TravisNagle/ECEN5613_Final_Project/docs/F26_PDR_TravisNagle_NathanCohen.pptx

ECEN 5613 · Final Project · Preliminary Design Review

MIDI Foot Controller for Reaper

An 8051-based MIDI foot controller with a motorized fader that stays in sync with the DAW

Inputs

- 4 footswitches
- Expression pedal (TRS)
- Motorized fader position
- MIDI IN (opto-isolated)

Outputs

- MIDI OUT → USB-MIDI → Reaper
- Fader motor (closed-loop)
- LCD status + presets
- Debug serial port

Team & ownership

Travis Nagle - MIDI & Interface lead
M2 debug + switches, M4 MIDI IN/merge, M5 LCD/presets
Nathan Cohen - Analog & Control lead
M3 pedal/ADC, M6 motorized fader
Joint: M1 MIDI OUT

Builds on the Lab 1-3 board: AT89C51RC2 @ 11.0592 MHz, MAX232, bq4011 NVRAM

Notes: ~40 s. Both: introduce yourselves. SW lead: what the device does, inputs/outputs. AE lead: ownership split.

## New hardware around the existing 8051 board

New hardware

Footswitches → 74HC165
M2 · PISO, shares SCLK and /CS with ADC

Existing

AT89C51RC2
existing Lab 1-3 board
UART 31,250 baud (Timer 2)
Soft UART TX 9,600 (Timer 0)
1 ms system tick (Timer 1)
PCA PWM 10.8 kHz (fader)
NVRAM presets 0x7F00–0x7FFF

MIDI OUT → 74HC125
M1 · TXD → USB-MIDI → Reaper

Pedal + fader → MCP3008
M3 · 10-bit SPI ADC, CH0 pedal, CH1 fader

SN754410 H-bridge → fader motor
M6 · PWM + 2 dir, 12 V USB-PD supply

MIDI IN → 6N138 opto
M4 · RXD via RUN / PC jumper

11 free port pins → 9 allocated, 2 reserved for Lab 4

Debug: MAX232 ch2 → DB9 #2
M2 · soft UART TX only (DB9 new)

Single-UART constraint: TXD fans out to MAX232 + MIDI OUT; RXD selected by jumper (MIDI / PC for FLIP); debug moved to a soft UART.

LCD (Lab 4)
M5 · status, preset menu

Notes: ~60 s. Walk inputs left, outputs right. Point out: '165 + MCP3008 share SCLK and /CS (saves 2 pins); MIDI IN is galvanically isolated per MIDI 1.0; motor on a separate 12 V rail with single-point ground at the driver.

## New firmware: interrupts feed a cooperative main loop

INTERRUPTS & HARDWARE TIMERS

UART RX
byte → 32-byte ring buffer; no parsing in ISR

Timer 0 (high)
soft UART TX, 9600 baud debug

Timer 1
1 ms tick sets loop flags

PCA (hardware)
8-bit PWM to H-bridge, no CPU cost

Primary firmware complexity: MIDI IN parse + merge/filter at up to 3,125 B/s alongside the 1 kHz fader loop. Debug output adds ~39%.

MAIN-LOOP MODULES

MIDI parser
status/data state machine, running status, real-time bytes

Merge + filter
interleave local msgs at boundaries; table filter; loop prevention

Switch scan
'165 read, 20 ms debounce → CC / MCU transport notes

Pedal
8-sample average, calibration, hysteresis → CC 0–127

Fader control
1 kHz PD loop, deadband brake, 1 s stall timeout

MCU link
14-bit pitch bend both ways with Reaper

Presets + LCD
NVRAM records with checksum; long-press edit menu

Drivers
Timer 2 UART, hardware SPI, bit-banged ‘165, soft UART, debug log

Notes: ~60 s. ISRs only move bytes and set flags; the main loop does the work.
Worst case: full-speed MIDI both ways plus the 1 kHz fader loop.
MIDI takes just under half (25% interrupts + 21% parsing), fader 24%, everything else 16%, 14% spare.
Debug output adds ~39%, so it's off in the worst case.
Need more headroom? X2 mode doubles the CPU and moves PWM to 21.6 kHz; recheck LCD timing first.

## Milestones: each one independently demonstrable

| Milestone | Owner | Dates | Acceptance test | Status
M1 | MIDI OUT: Timer 2 UART, 74HC125 driver | Both | Wk 1-2 (10/19–11/1) | Note On/Off in MIDI-OX; Reaper synth plays | 74HC125, DIN jacks and USB-MIDI interface to order
M2 | Debug port + footswitches ('165) | TN | Wk 2-3 (to 11/8) | FS1 toggles Reaper record; debug logs event | 74HC165, footswitches, and DB9 to order
M3 | Expression pedal via MCP3008 | NC | Wk 3 (11/2–11/8) | Full travel → CC 0–127; no messages at rest | MCP3008 and TRS jack to order
M4 | MIDI IN, merge, filter (6N138) | TN | Wk 3-5 (to 11/22) | Pass-through with footswitch traffic, zero drops | 6N138 and 1N4148 to order
M5 | LCD, presets, menu (NVRAM) | TN | Wk 6 (11/23–11/29) | Edit preset by footswitch; survives power cycle | Waiting on Lab 4 LCD
M6 | Motorized fader, PD loop, MCU link | NC | Wk 2-6 (to 11/29) | Fader tracks Reaper in 1 s, ±1 mm, no oscillation | Fader and USB-PD module on hand; SN754410 to order
M7 | Stretch: tempo sync or 2nd fader | Both | Wk 6 if ahead | — | Optional

Key dates: order all parts Tue 10/20 · TA progress check week 3 · feature freeze Mon 11/30 · demo Fri 12/4

Notes: ~50 s. Two tracks run in parallel weeks 4–5 (SW: M4, AE: M6).

## Deliverables, fallback plan, and open risks

Footswitch control of Reaper over MIDI

Minimum
M1–M2

OPEN RISKS → MITIGATION

Parts lead time
Order all parts 10/20; in-stock substitutes (e.g. TRS jack)

+ pedal, MIDI IN merge/filter, LCD presets, motorized fader

1

Target
M1–M6

2

One MIDI IN: keyboard (M4) vs Reaper feedback (M6)
Demo M4 and M6 with separate cabling; filter notes and pitch bend in MCU mode

+ MIDI clock tempo sync, or a second motorized fader

Stretch
M7

3

Fader fights Reaper feedback
Send synthetic MCU touch on user movement and ignore Reaper's fader position while touched

12 V not offered by every USB-PD charger
Verify in-hand charger; 9 V setting is marginal

FALLBACK

- DIN/USB-MIDI fails: MIDI bytes out DB9 #1 at 115,200 baud → Hairless MIDI → loopMIDI → Reaper
- Motor control fails: fader still works as an unpowered slider through the ADC

4

5

10.8 kHz PWM may be audible
X2 mode, after rechecking bus timing → 21.6 kHz PWM and 2× CPU

6

M5 depends on Lab 4 LCD
M5 is firmware-only; slip does not block M6

Notes: ~50 s. Close with: minimum demo is reachable by week 3; every target milestone is independently demonstrable. Then questions.
