TravisNagle/ECEN5613_Final_Project/hardware/digikey_order_102466363.csv

# | QUANTITY | PART NUMBER | MANUFACTURER PART NUMBER | DESCRIPTION | UNIT OF MEASURE | CUSTOMER REFERENCE | AVAILABILITY | UNIT PRICE
1 | 2 | MCP3008-I/P-ND | MCP3008-I/P | IC ADC 10BIT 16-PDIP |  | U11 fader ADC (+1 spare) | Immediate | 3.12000
2 | 2 | 296-1610-5-ND | SN74HCT244N | IC BUFF 4.5V/5.5V 20-PDIP |  | U16 panel button buffer (+1 spare) | Immediate | 1.52000
3 | 2 | 296-2110-5-ND | CD74HCT273E | IC FF D-TYPE 1-ELE 8-BIT 20-PDIP |  | U14 direction latch with /MR (+1 spare); kit 74L | Immediate | 1.16000
4 | 2 | 25TWL10MEFC5X11-ND | 25TWL10MEFC5X11 | CAP ALUM 10UF 20% 25V RADIAL TH |  | 10 uF 25 V (ADC reference filter; kit 10 uF are | Immediate | 0.27000
5 | 2 | P14419-ND | EEU-FR1E471 | CAP ALUM 470UF 20% 25V RADIAL TH |  | 470 uF 25 V motor rail bulk | Immediate | 1.00000
6 | 1 | RHEF300HF-ND | RHEF300 | PTC RESET FUSE 16V 3A RADIAL |  | PTC fuse for motor rail (3 A hold; three motors | Immediate | 0.81000
7 | 1 | 4878-P6KE15ACT-ND | P6KE15A | TVS DIODE 12.8VWM 21.2V DO204AC |  | TVS for motor rail | Immediate | 0.53000
8 | 3 | AT42QT1010-TSHRCT-ND | AT42QT1010-TSHR | IC TOUCH SENSOR 1KEY SOT23-6 |  | A4/A5 fader touch sensor IC SOT-23-6 (+1 spare) | Immediate | 0.77000
9 | 2 | 23-0702461201-ND | 0702461201 | CONN HEADER VERT 12POS 2.54MM |  | J20 12-pin shrouded keyed header (panel end + bo | Immediate | 2.69000
10 | 2 | WM9219-ND | 0702461001 | CONN HEADER VERT 10POS 2.54MM |  | J21 10-pin shrouded keyed header (panel end + bo | Immediate | 1.92000
11 | 2 | 2057-FCS-12-SG-ND | FCS-12-SG | SOCKET FLAT CABLE IDC 12P 2.54MM |  | J20 12-pin polarized IDC ribbon socket gold (one | Immediate | 0.41000
12 | 2 | ED10500-ND | 101-106 | CONN SOCKET 10POS IDC GOLD |  | J21 10-pin polarized IDC ribbon socket gold (one | Immediate | 0.31000
13 | 2 | 19-3365/12100-DS-ND | 3365/12 100 | CBL RIBN 12COND 0.05 GRY FEET | Feet | 12-conductor 0.050 in ribbon; quantity is feet; | Immediate | 0.96000 (Per Foot)
