TravisNagle/ECEN5613_Final_Project/hardware/kicad/ESD_Final/ESD_Final_schematic.pdf

1 | 2 | 3 | 4 | 5 | 6 | 7 | 8

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
Size: A3 | Rev: 13.4 | F Date: 2026-10-25
KiCad E.D.A. 10.0.6 | Id: 1/8

# Title: Reaper MIDI control surface: boards and cables

### File: ESD_Final.kicad_sch

### Sheet: /

### ECEN 5613 Final Project

### Spec: Hardware_Map.md Rev 13.4

### Generated from hardware/kicad/tools/design.py by gen_schematic.py

### Authors: Nathan Cohen, Travis Nagle (AI-assisted, see report)

Class board: 8051, address latch, decode, reset, status LED

File: class_mcu.kicad_sch Class board: Serial, USB-MIDI, I2C and panel cables File: class_io.kicad_sch

Fader button board: Fader buttons F1/F2 and touch sensors File: fader_strip.kicad_sch Button daughter board: PCF8574 buttons and LEDs on the RJ45 I2C bus (Phase 3) File: btn_daughter.kicad_sch

Class board: Power, motor supply, motor driver and direction latch

File: class_power.kicad_sch

D-pad board: Button buffer, fader ADC, D-pad, LCD contrast File: dpad.kicad_sch Panel Mounted: Motor faders, LCD and pedal jack (wired to the boards) File: panel.kicad_sch

### Inter-board connections:

J20 (class) <-> J30 (D-pad) | 12-pin ribbon, about 9 in: AD0-AD7, LCD_RS, LCD_RW, LCD_E, GND
J21 (class) <-> J31 (D-pad) | 10-pin ribbon, about 8 in: +5V, GND x2, BTN_OE_N, TOUCH2, ADC SPI, 1 spare
J22 (class) --> FDR1, FDR2 motors | 4 wires (two twisted pairs)
J32 (D-pad) <-> J40 (fader strip) | 6 wires: +5V, GND, BTN_F1, BTN_F2, TOUCH1, TOUCH2
J33 (D-pad) --> LCD1 | 14 wires; | J34 (D-pad) --> FDR1/FDR2 pots | 4 wires; | J35 (D-pad) --> J13 pedal jack | 3 wires
J41 (fader strip) --> FDR1/FDR2 touch pins T | 2 wires
J11 (class) RJ45 --> J101 (button daughter) patch cable; | J102 --> next daughter board
Power: J1 (class) <-- 9 V >= 2 A adapter. | USB-C to the KB2040 (A2). | DB9 J5 / J7 TTL debug to the PC.

# ECEN 5613 Final Project: 8051 MIDI control surface for Reaper (Hardware_Map.md Rev 13.4)

Authors: Nathan Cohen and Travis Nagle. One sheet per board section; nets join across sheets by global label.

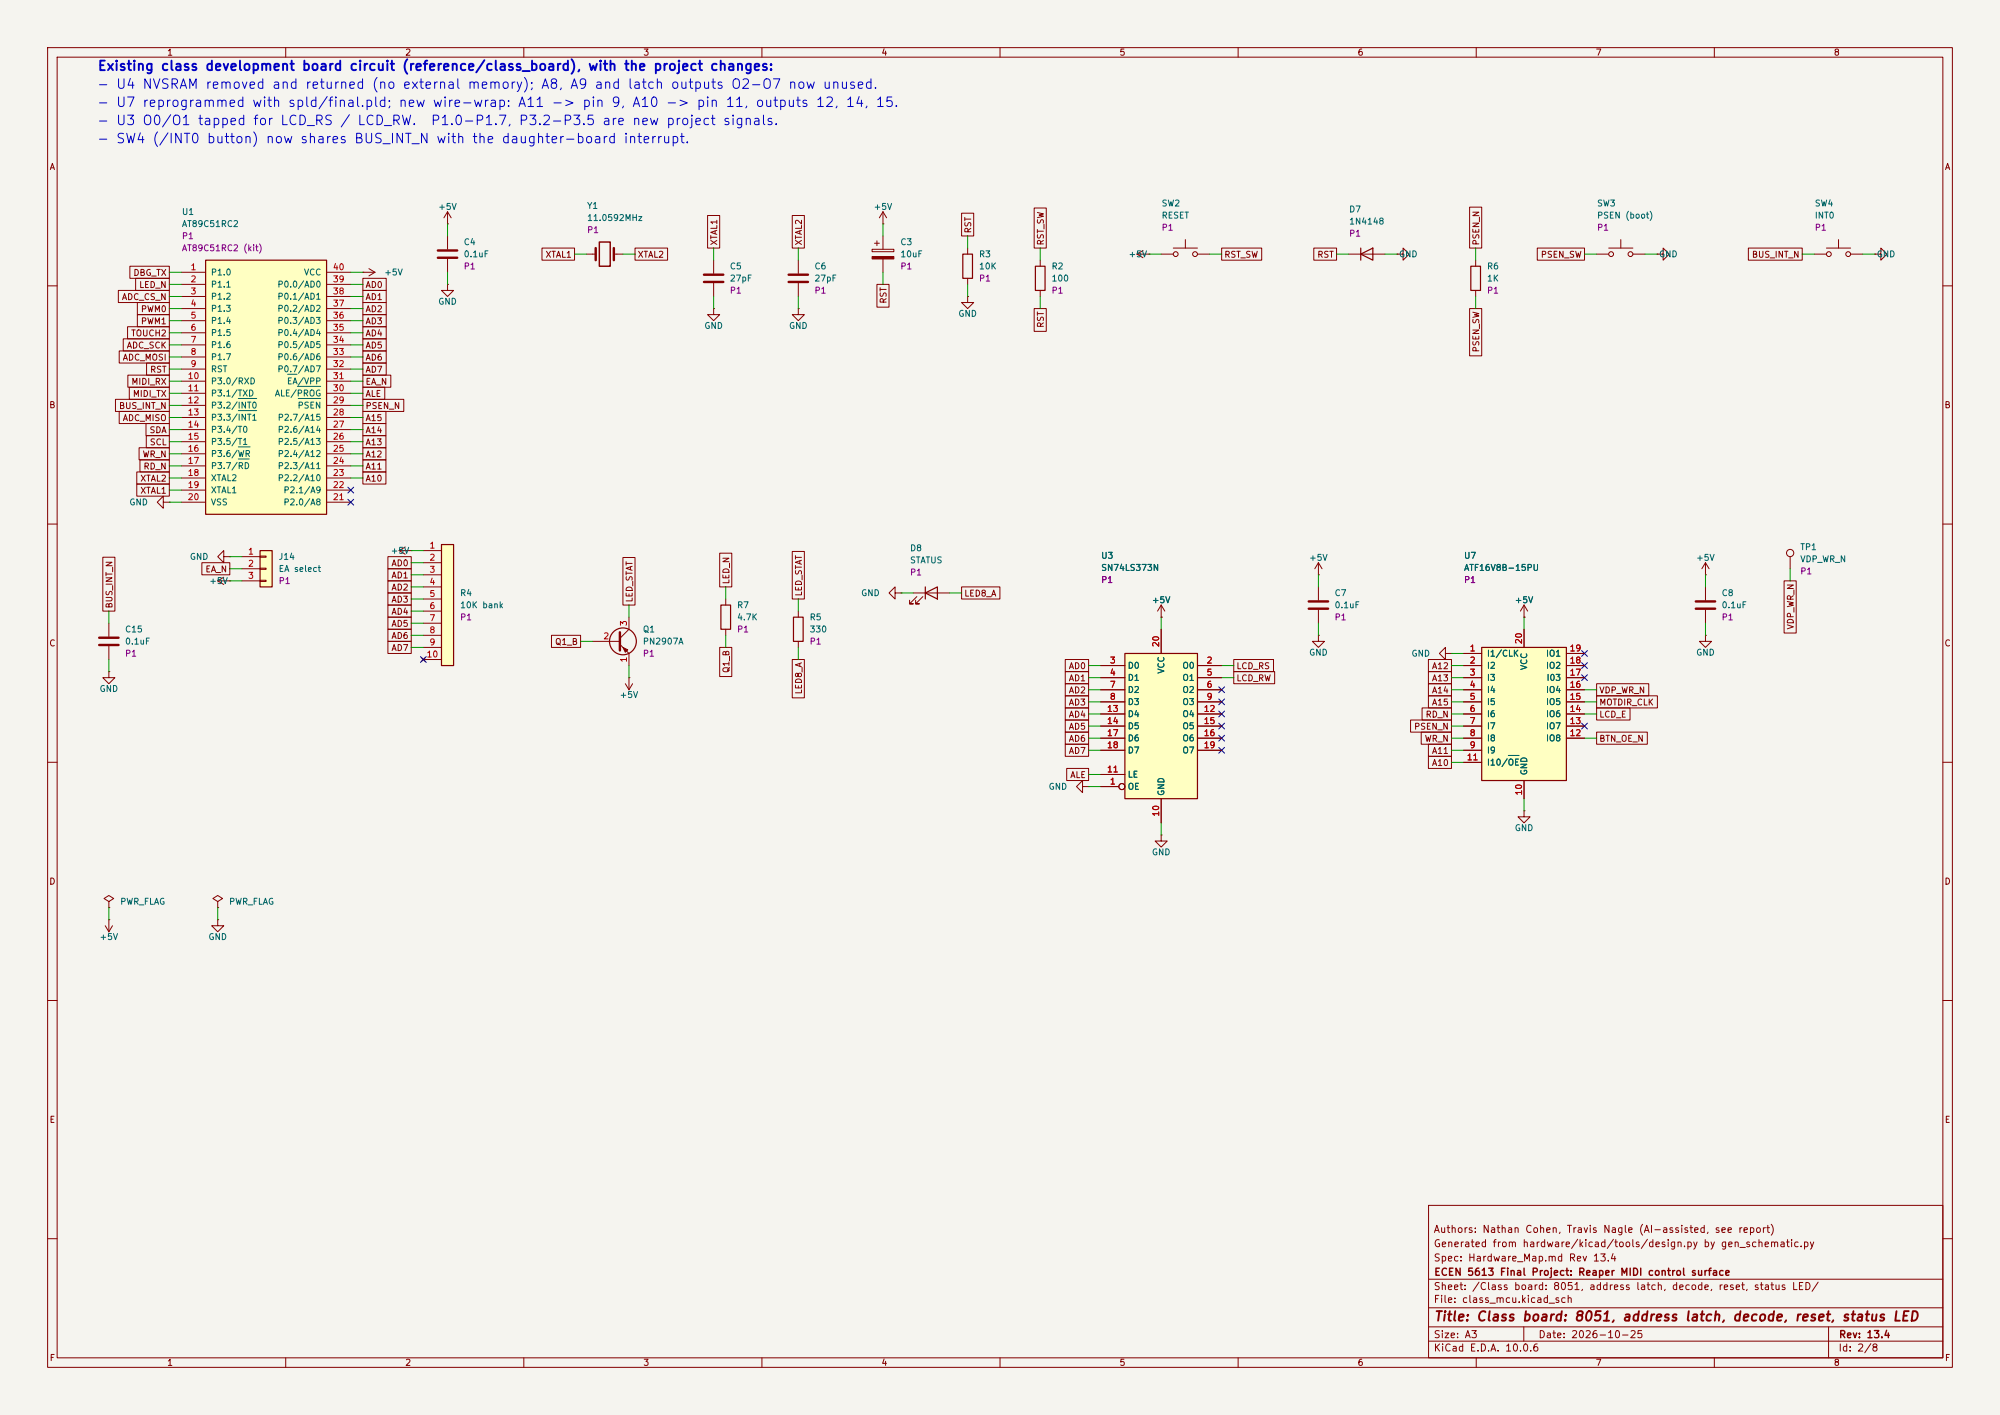
[picture p1: page 2]

Authors: Nathan Cohen, Travis Nagle (AI-assisted, see report)
Generated from hardware/kicad/tools/design.py by gen_schematic.py
Spec: Hardware_Map.md Rev 13.4
ECEN 5613 Final Project: Reaper MIDI control surface
Sheet: /Class board: 8051, address latch, decode, reset, status LED/
File: class_mcu.kicad_sch
Title: Class board: 8051, address latch, decode, reset, status LED

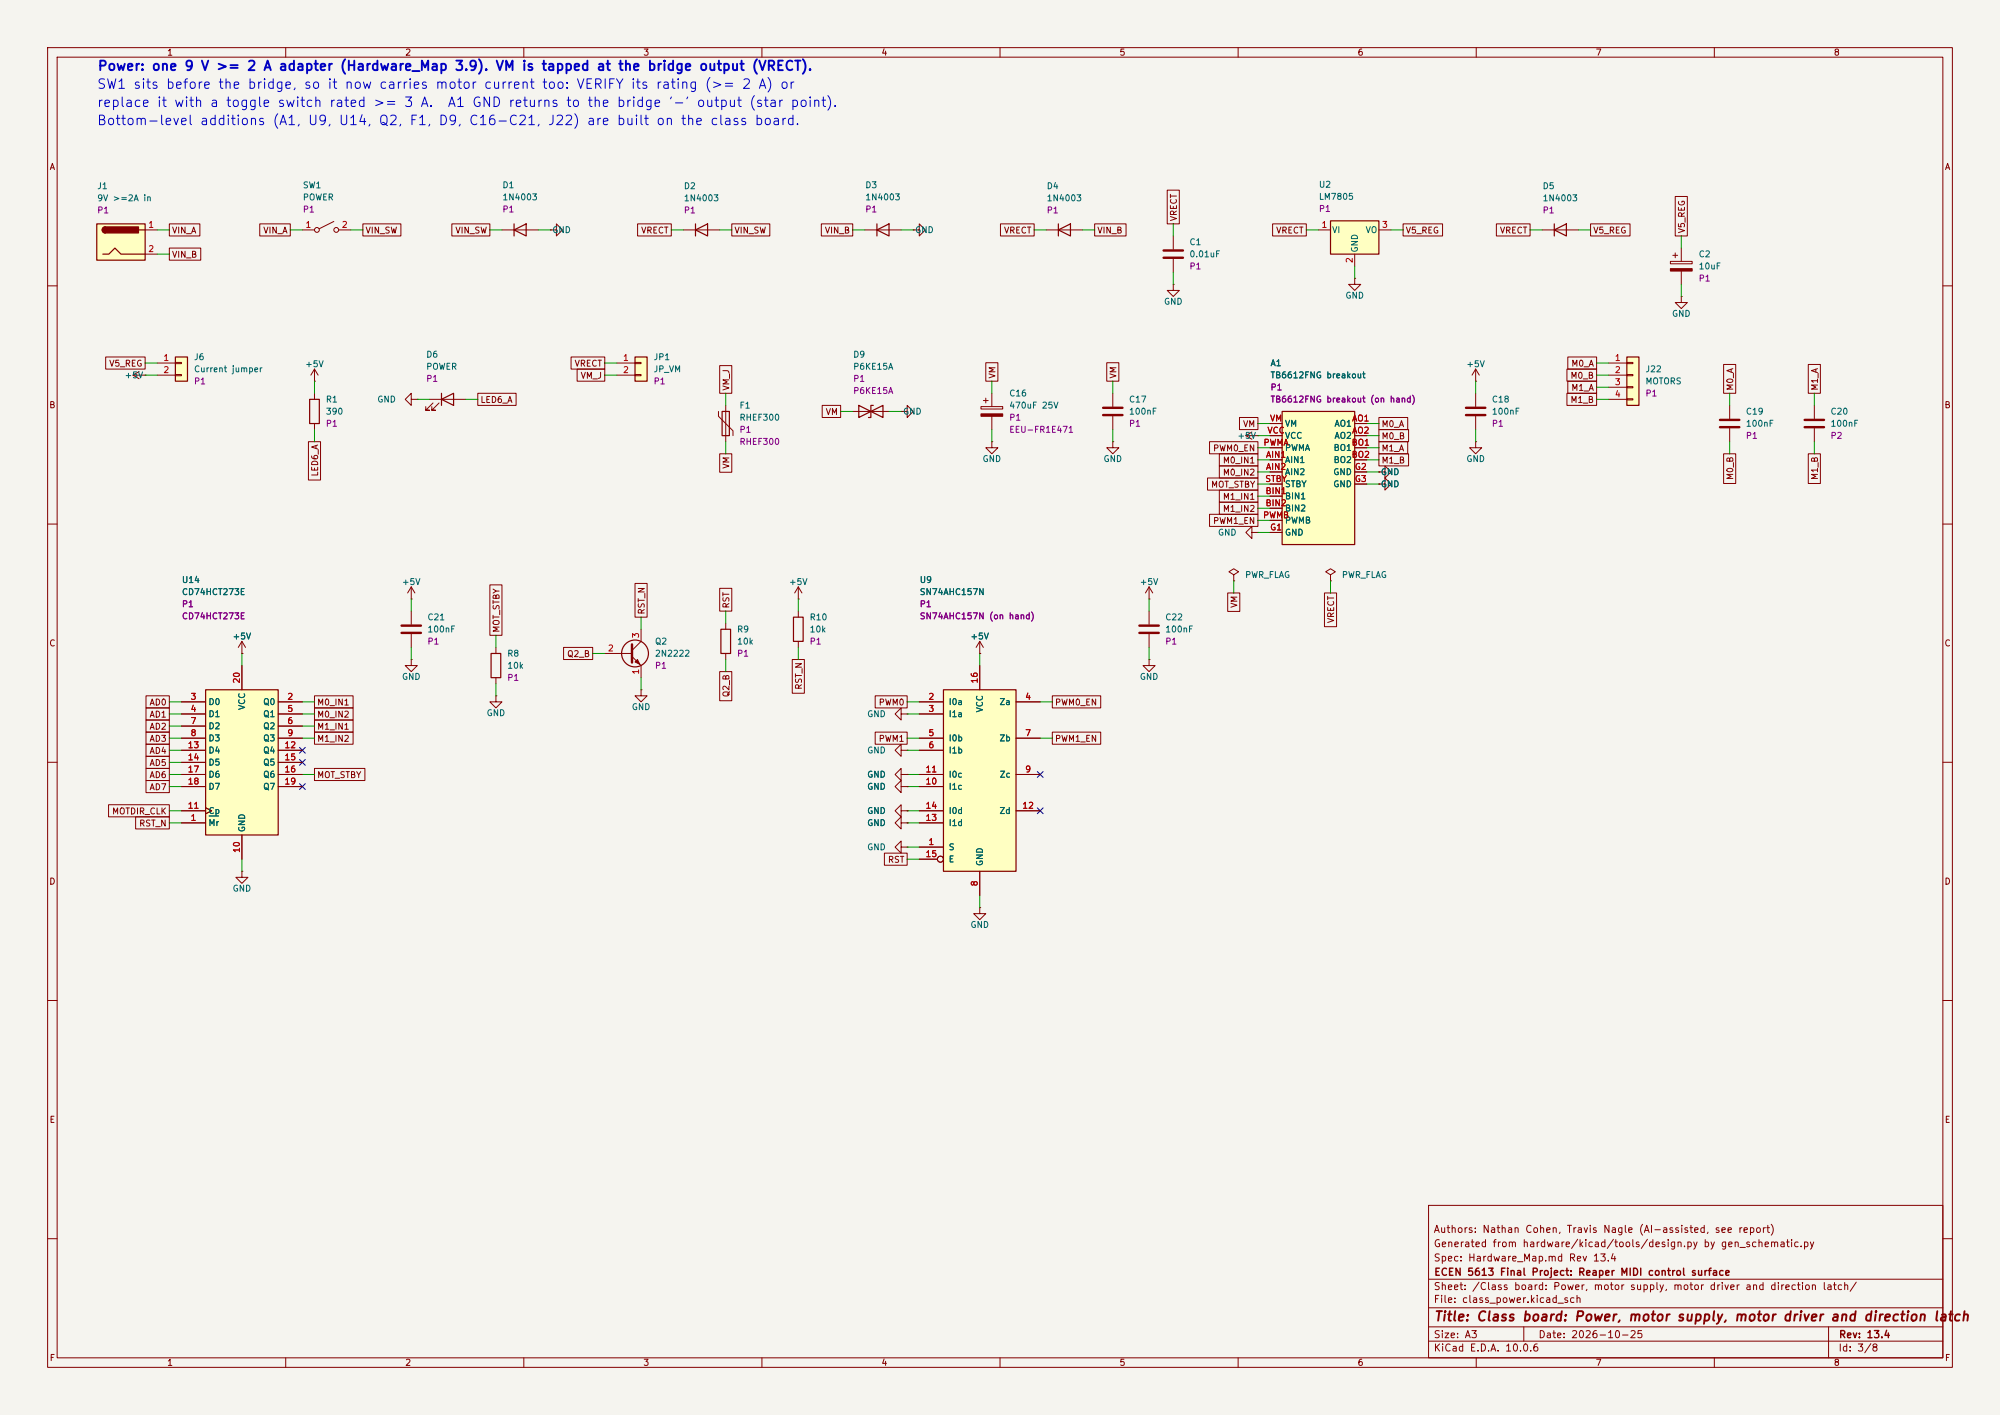
[picture p2: page 3]

AD1 Power: one 9 V >= 2 A adapter (Hardware_Map 3.9). VM is tapped at the bridge output (VRECT).

Bottom-level additions (A1, U9, U14, Q2, F1, D9, C16-C21, J22) are built on the class board.

Authors: Nathan Cohen, Travis Nagle (AI-assisted, see report)
Generated from hardware/kicad/tools/design.py by gen_schematic.py
Spec: Hardware_Map.md Rev 13.4
ECEN 5613 Final Project: Reaper MIDI control surface
Sheet: /Class board: Power, motor supply, motor driver and direction latch/
File: class_power.kicad_sch
Title: Class board: Power, motor supply, motor driver and direction latch

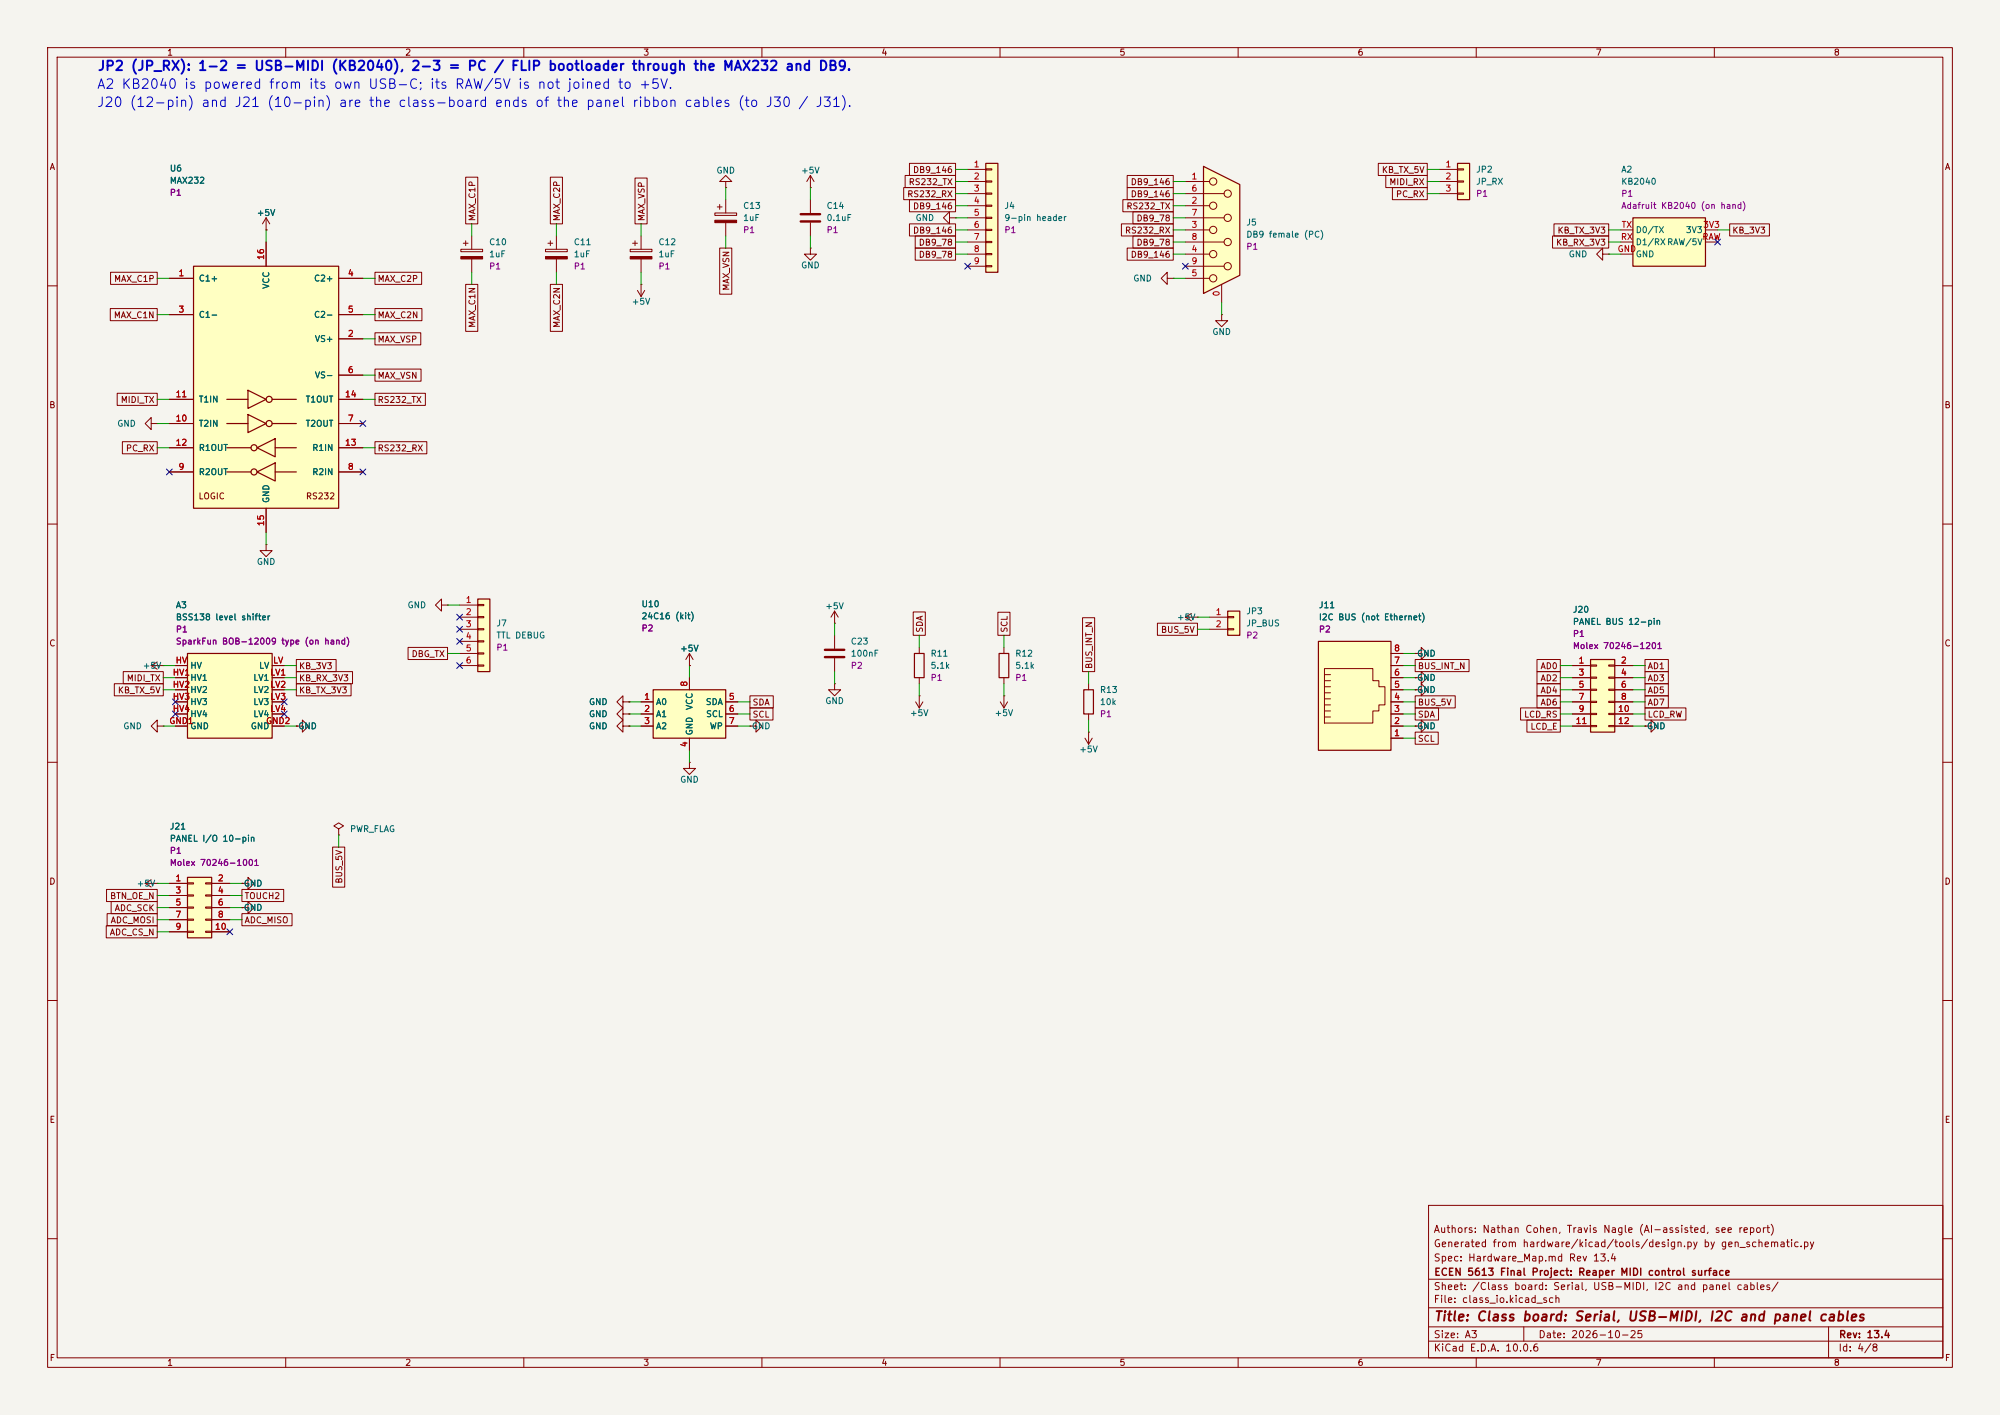
[picture p3: page 4]

JP2 (JP_RX): 1-2 = USB-MIDI (KB2040), 2-3 = PC / FLIP bootloader through the MAX232 and DB9.
A2 KB2040 is powered from its own USB-C; its RAW/5V is not joined to +5V.

Generated from hardware/kicad/tools/design.py by gen_schematic.py
Spec: Hardware_Map.md Rev 13.4
ECEN 5613 Final Project: Reaper MIDI control surface
Sheet: /Class board: Serial, USB-MIDI, I2C and panel cables/
File: class_io.kicad_sch
Title: Class board: Serial, USB-MIDI, I2C and panel cables

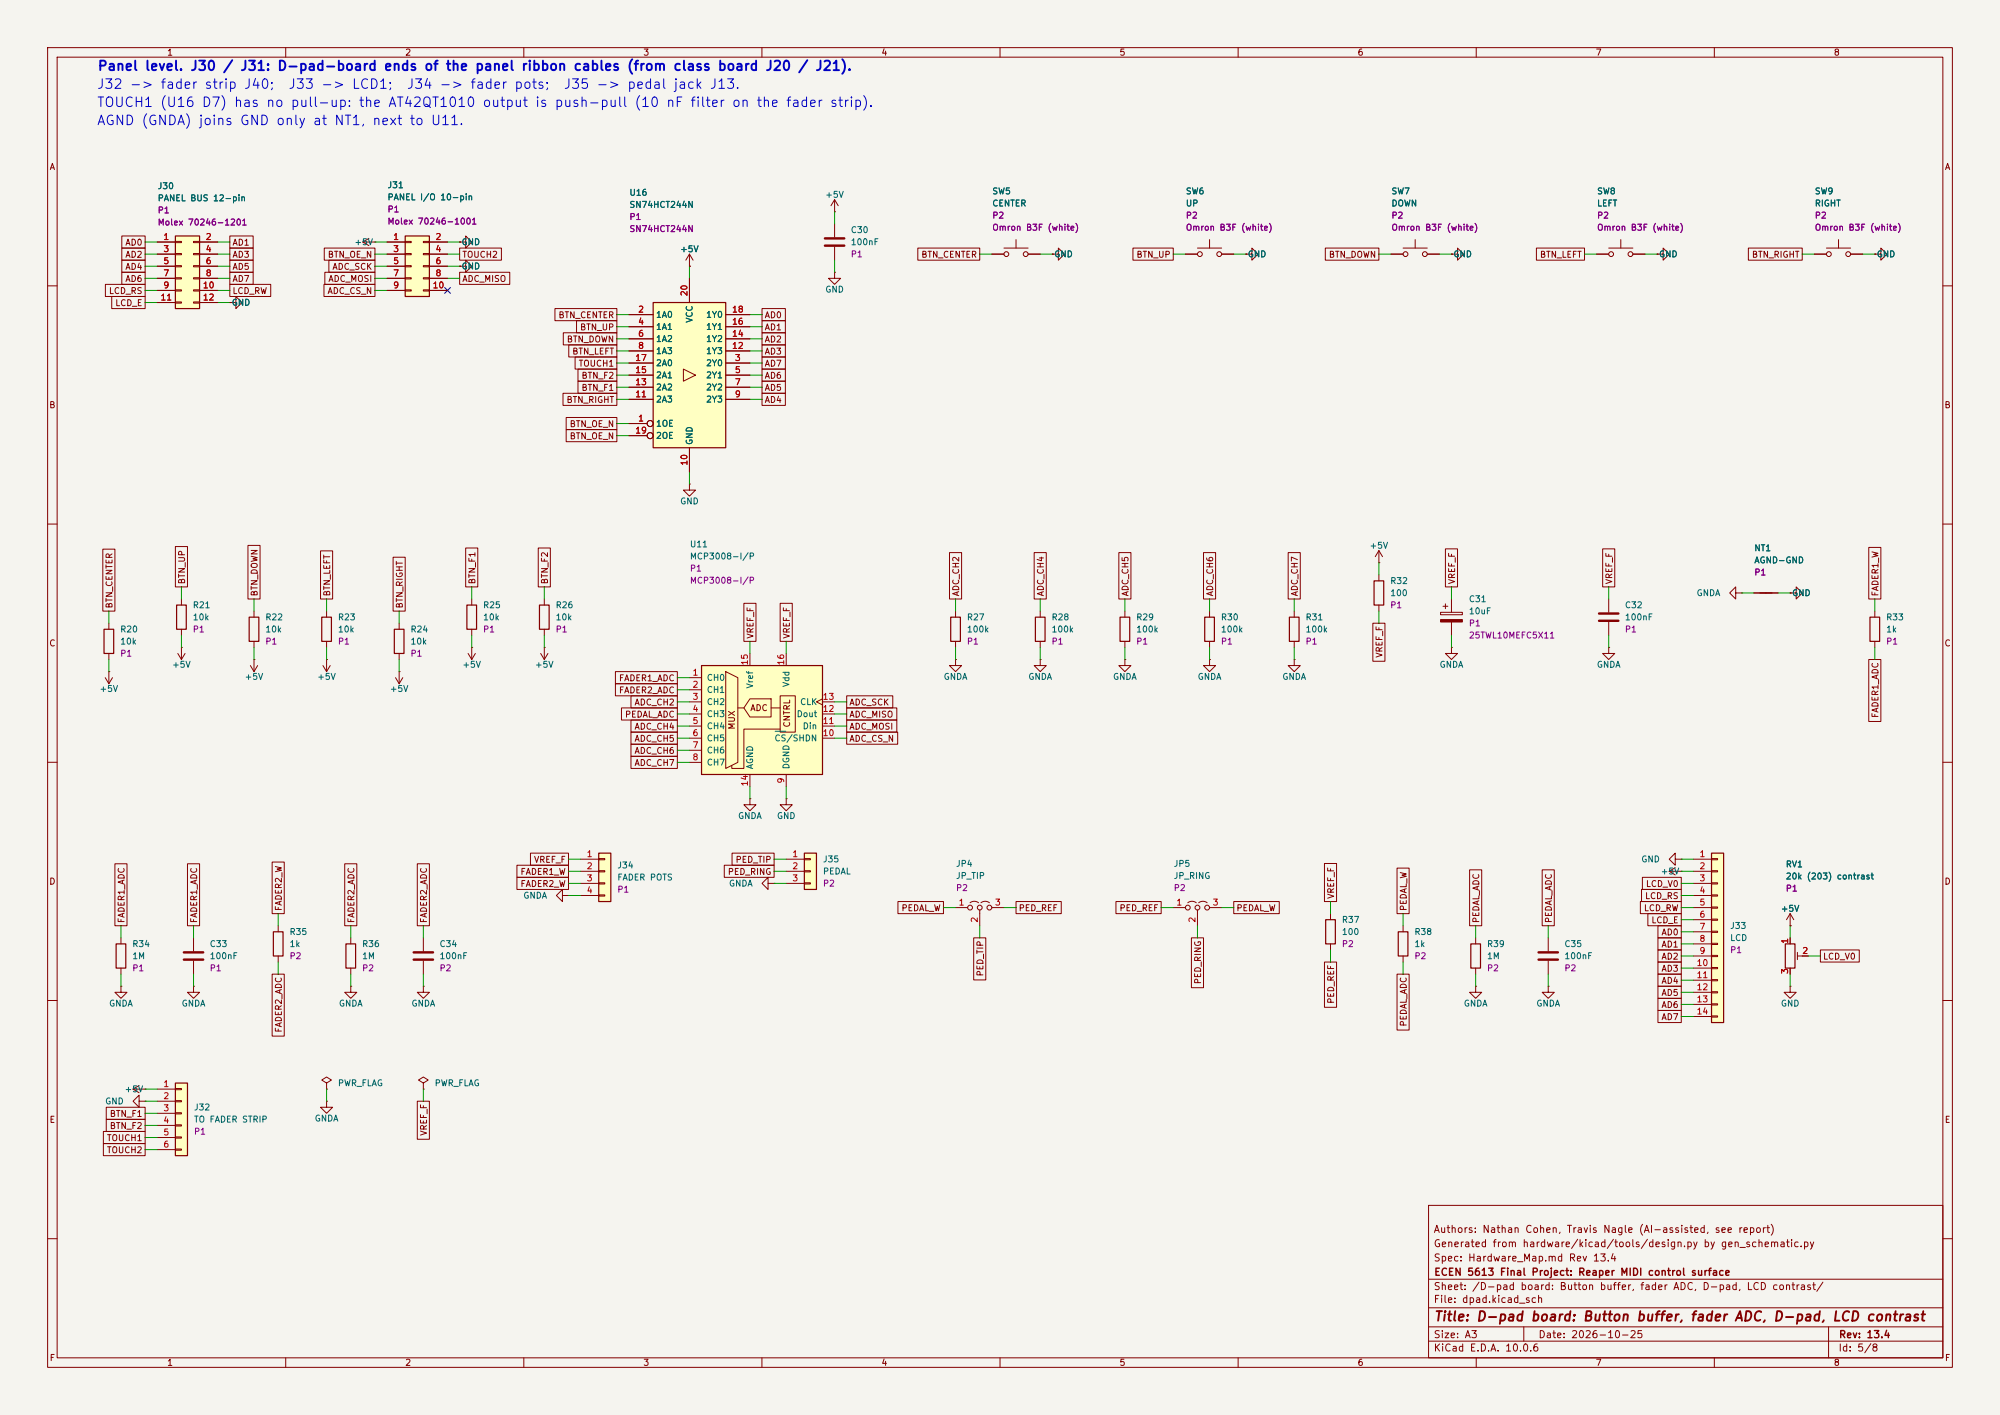
[picture p4: page 5]

TOUCH1 (U16 D7) has no pull-up: the AT42QT1010 output is push-pull (10 nF filter on the fader strip).

J30 PANEL BUS 12-pin P1Molex 70246-1201 GND
LEFT P2Omron B3F (white) +5V

9 CS/SHDN 10 Din 11 Dout 12 CLK 13 AGND 14 Vref 15 Vdd 16 U11 MCP3008-I/P

Authors: Nathan Cohen, Travis Nagle (AI-assisted, see report)
Generated from hardware/kicad/tools/design.py by gen_schematic.py
Spec: Hardware_Map.md Rev 13.4
ECEN 5613 Final Project: Reaper MIDI control surface
Sheet: /D-pad board: Button buffer, fader ADC, D-pad, LCD contrast/
File: dpad.kicad_sch
Title: D-pad board: Button buffer, fader ADC, D-pad, LCD contrast

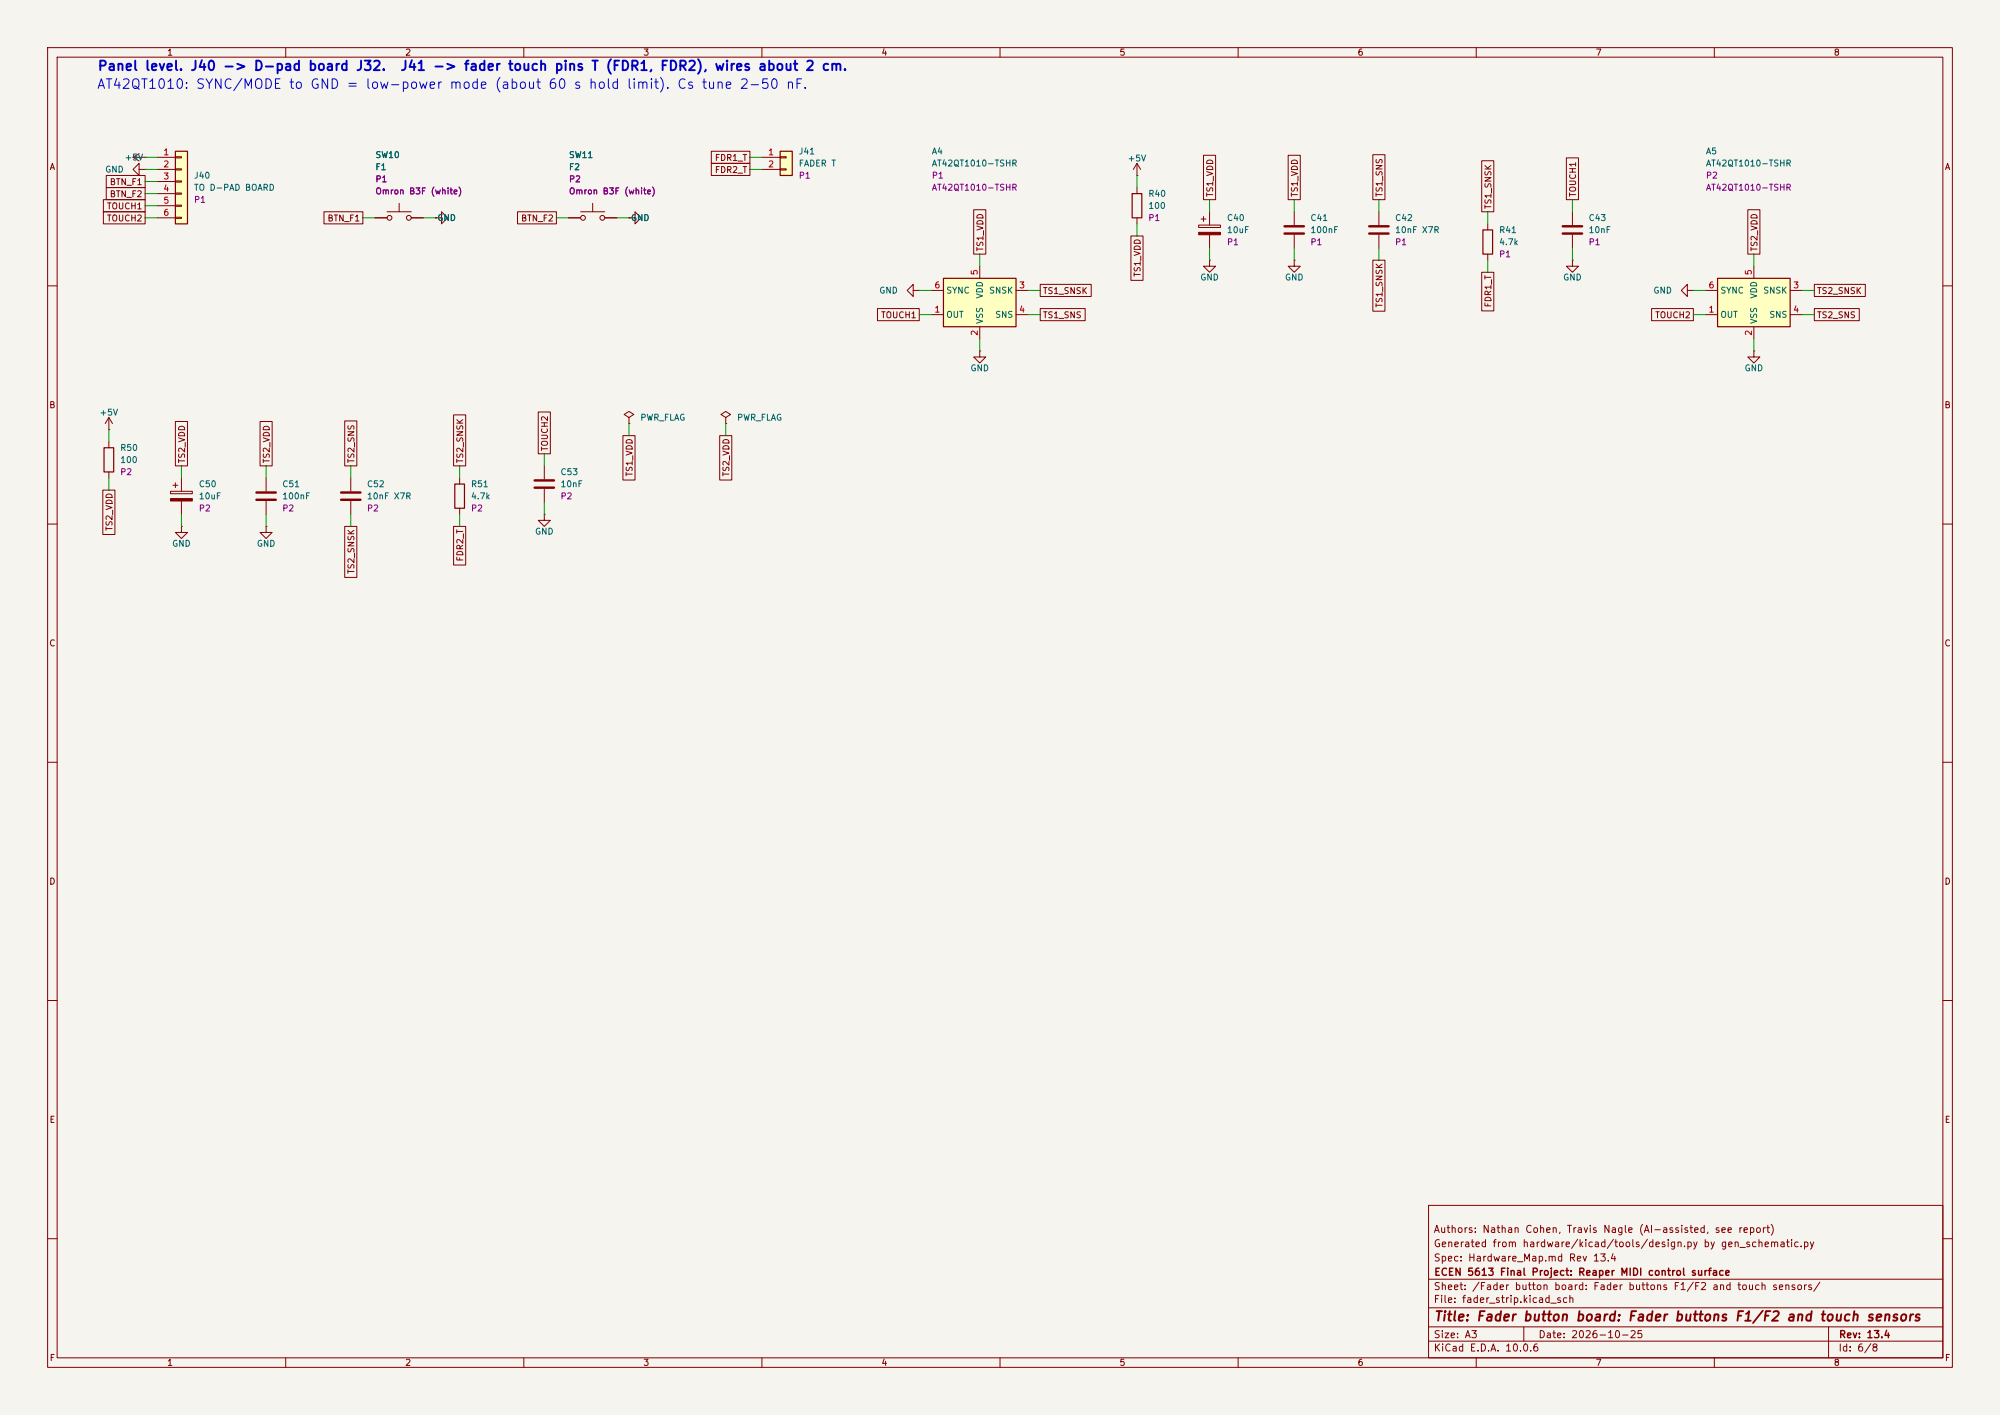
[picture p5: page 6]

Panel level. J40 -> D-pad board J32. J41 -> fader touch pins T (FDR1, FDR2), wires about 2 cm. GND
AT42QT1010: SYNC/MODE to GND = low-power mode (about 60 s hold limit). Cs tune 2-50 nF.

Authors: Nathan Cohen, Travis Nagle (AI-assisted, see report)
Generated from hardware/kicad/tools/design.py by gen_schematic.py
Spec: Hardware_Map.md Rev 13.4
ECEN 5613 Final Project: Reaper MIDI control surface
Sheet: /Fader button board: Fader buttons F1/F2 and touch sensors/
File: fader_strip.kicad_sch
Title: Fader button board: Fader buttons F1/F2 and touch sensors

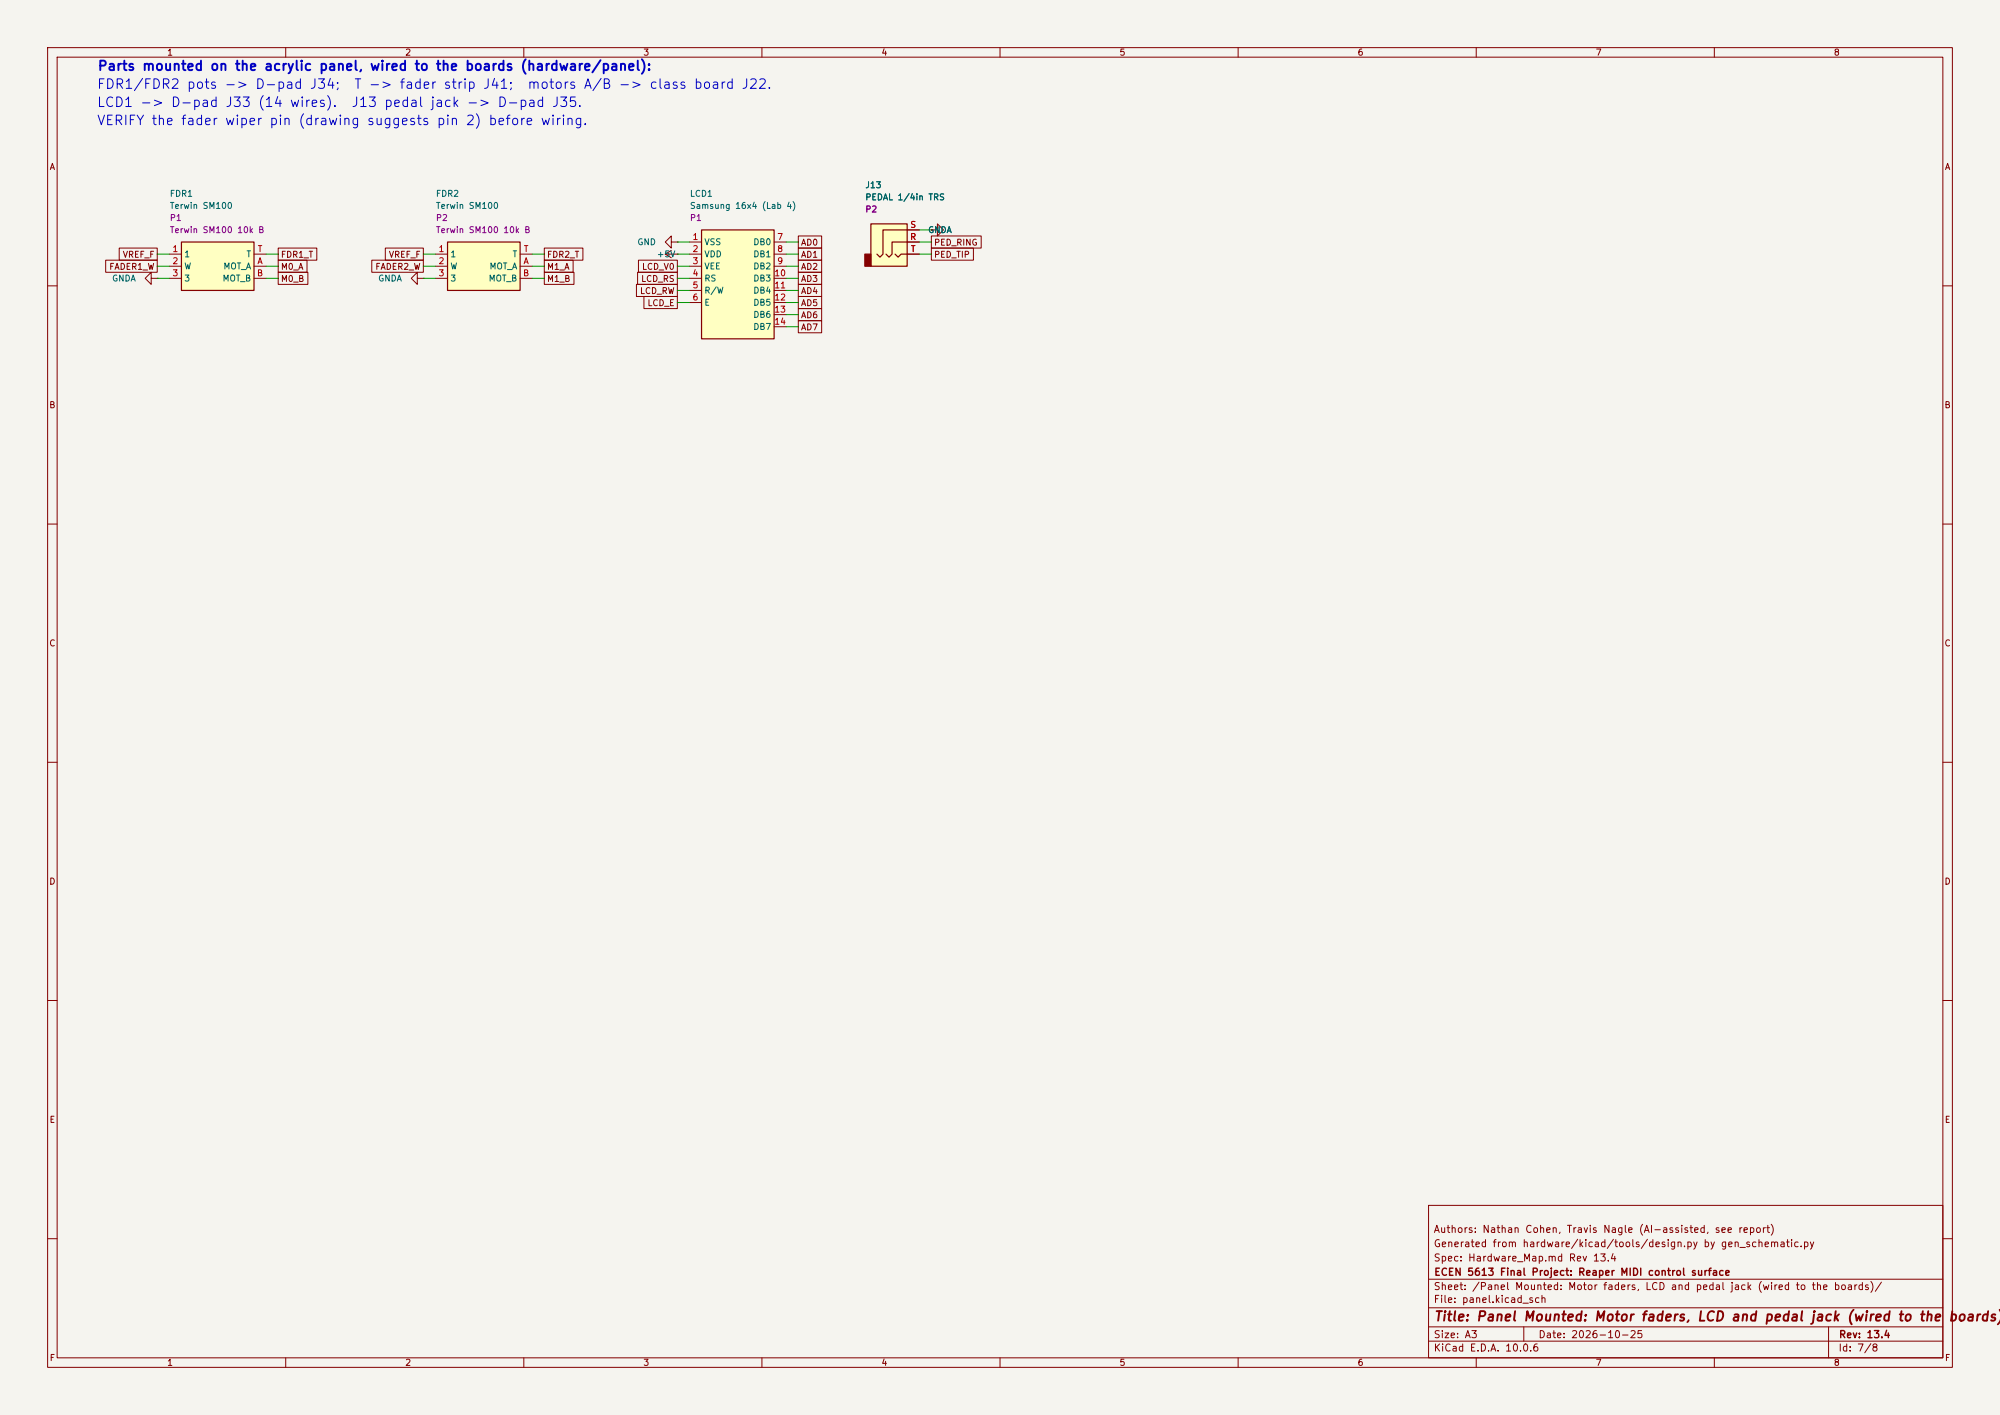
[picture p6: page 7]

VERIFY the fader wiper pin (drawing suggests pin 2) before wiring.

Authors: Nathan Cohen, Travis Nagle (AI-assisted, see report)
Generated from hardware/kicad/tools/design.py by gen_schematic.py
Spec: Hardware_Map.md Rev 13.4
ECEN 5613 Final Project: Reaper MIDI control surface
Sheet: /Panel Mounted: Motor faders, LCD and pedal jack (wired to the boards)/
File: panel.kicad_sch
Title: Panel Mounted: Motor faders, LCD and pedal jack (wired to the boards)

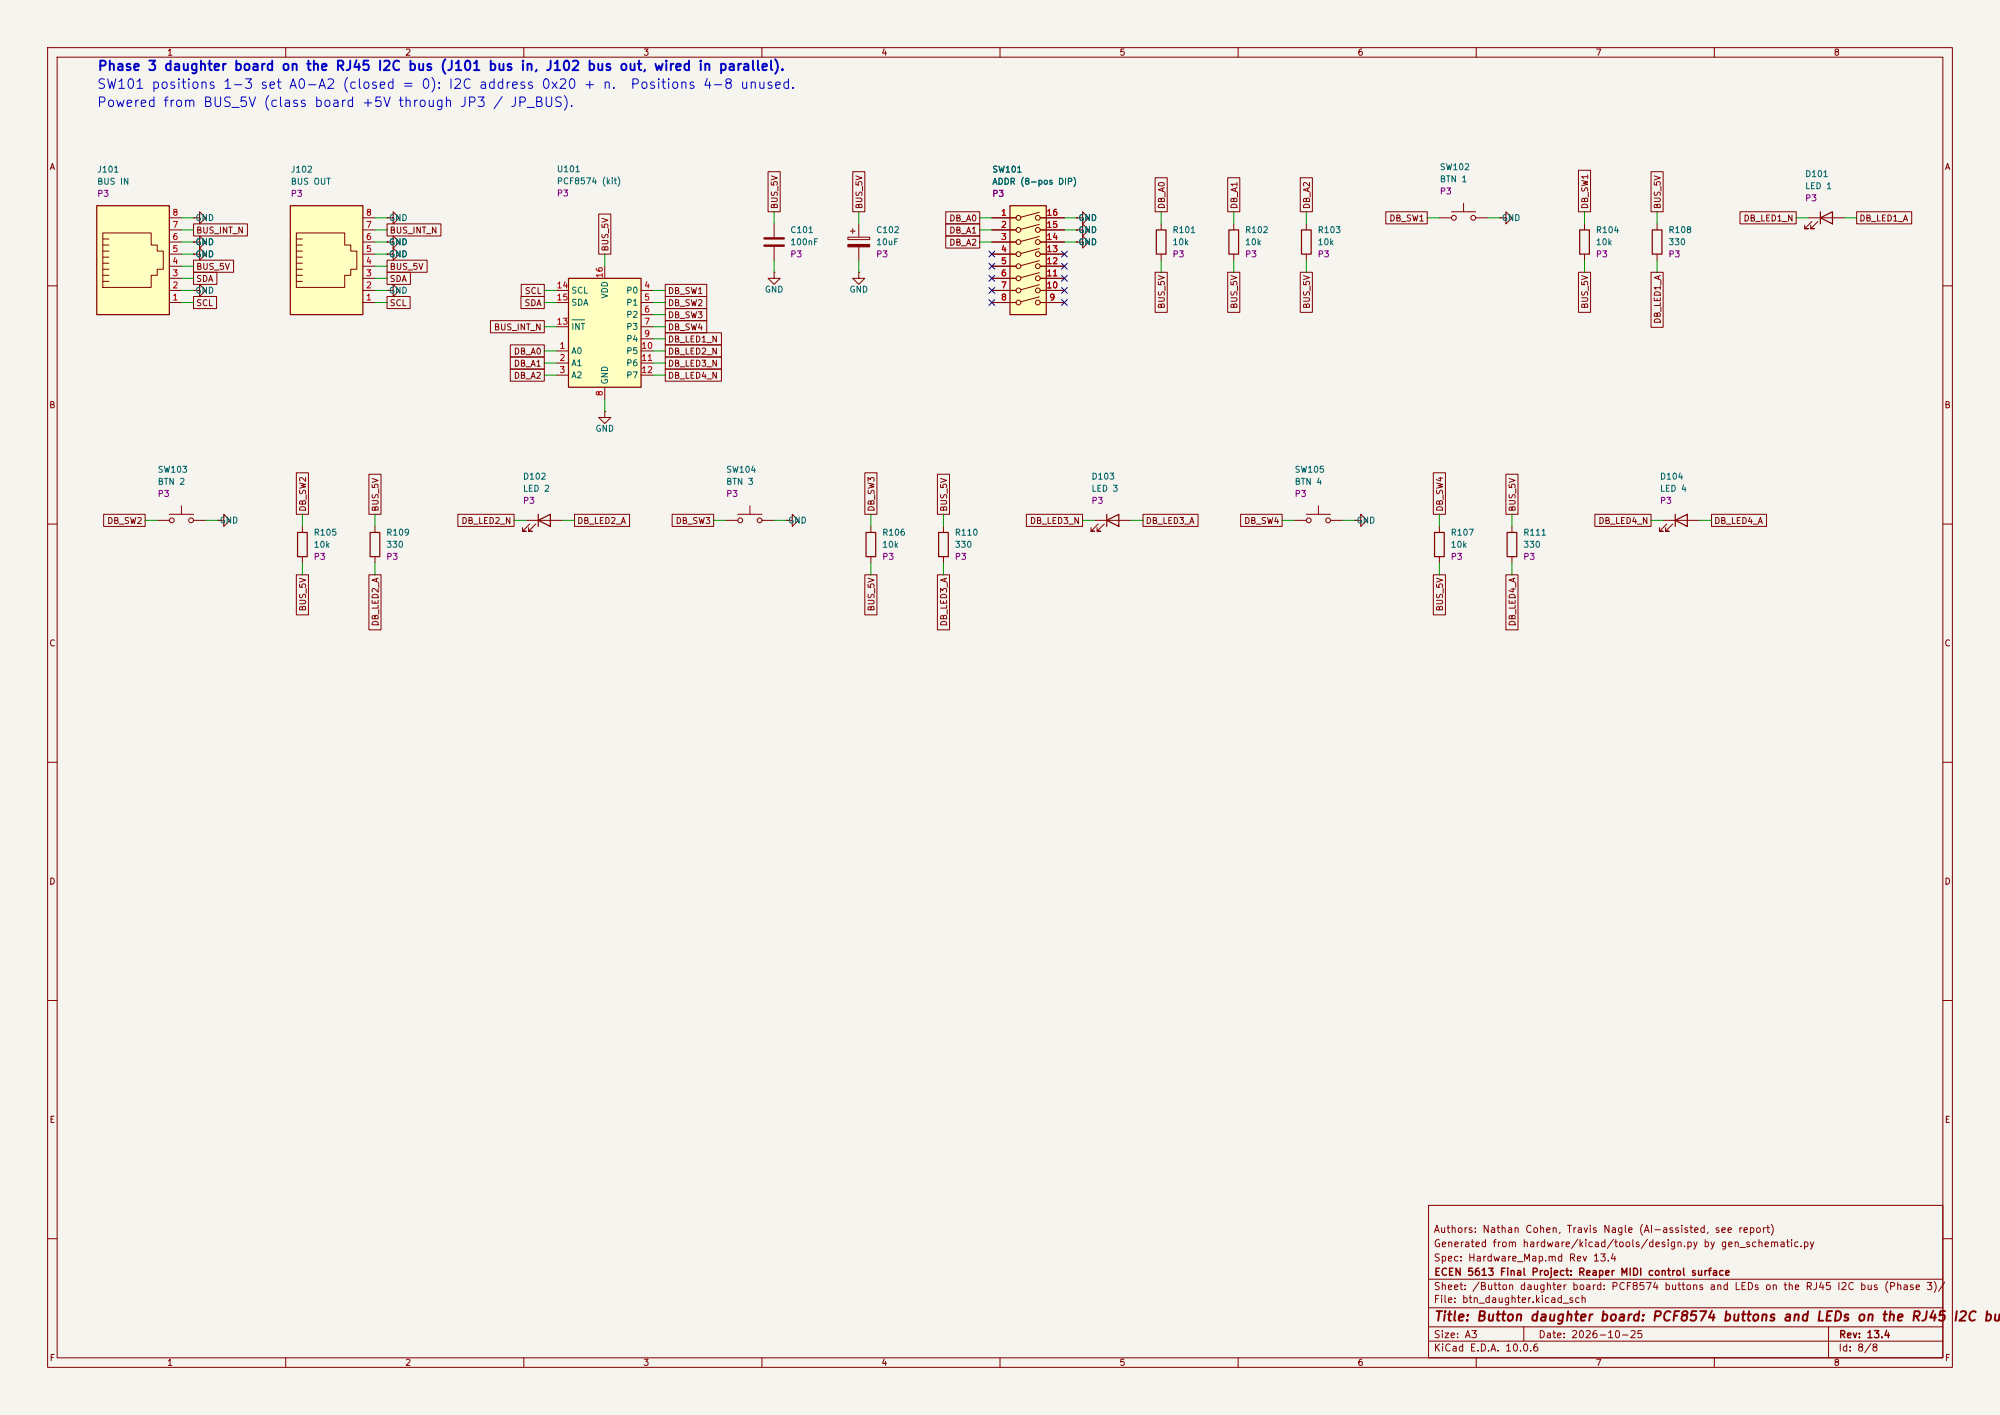
[picture p7: page 8]

Powered from BUS_5V (class board +5V through JP3 / JP_BUS).

Authors: Nathan Cohen, Travis Nagle (AI-assisted, see report)
Generated from hardware/kicad/tools/design.py by gen_schematic.py
Spec: Hardware_Map.md Rev 13.4
ECEN 5613 Final Project: Reaper MIDI control surface
Sheet: /Button daughter board: PCF8574 buttons and LEDs on the RJ45 I2C bus (Phase 3)/
File: btn_daughter.kicad_sch
Title: Button daughter board: PCF8574 buttons and LEDs on the RJ45 I2C bus (Phase 3)
