TravisNagle/ECEN5613_Final_Project/docs/MIDI-Controller.pdf

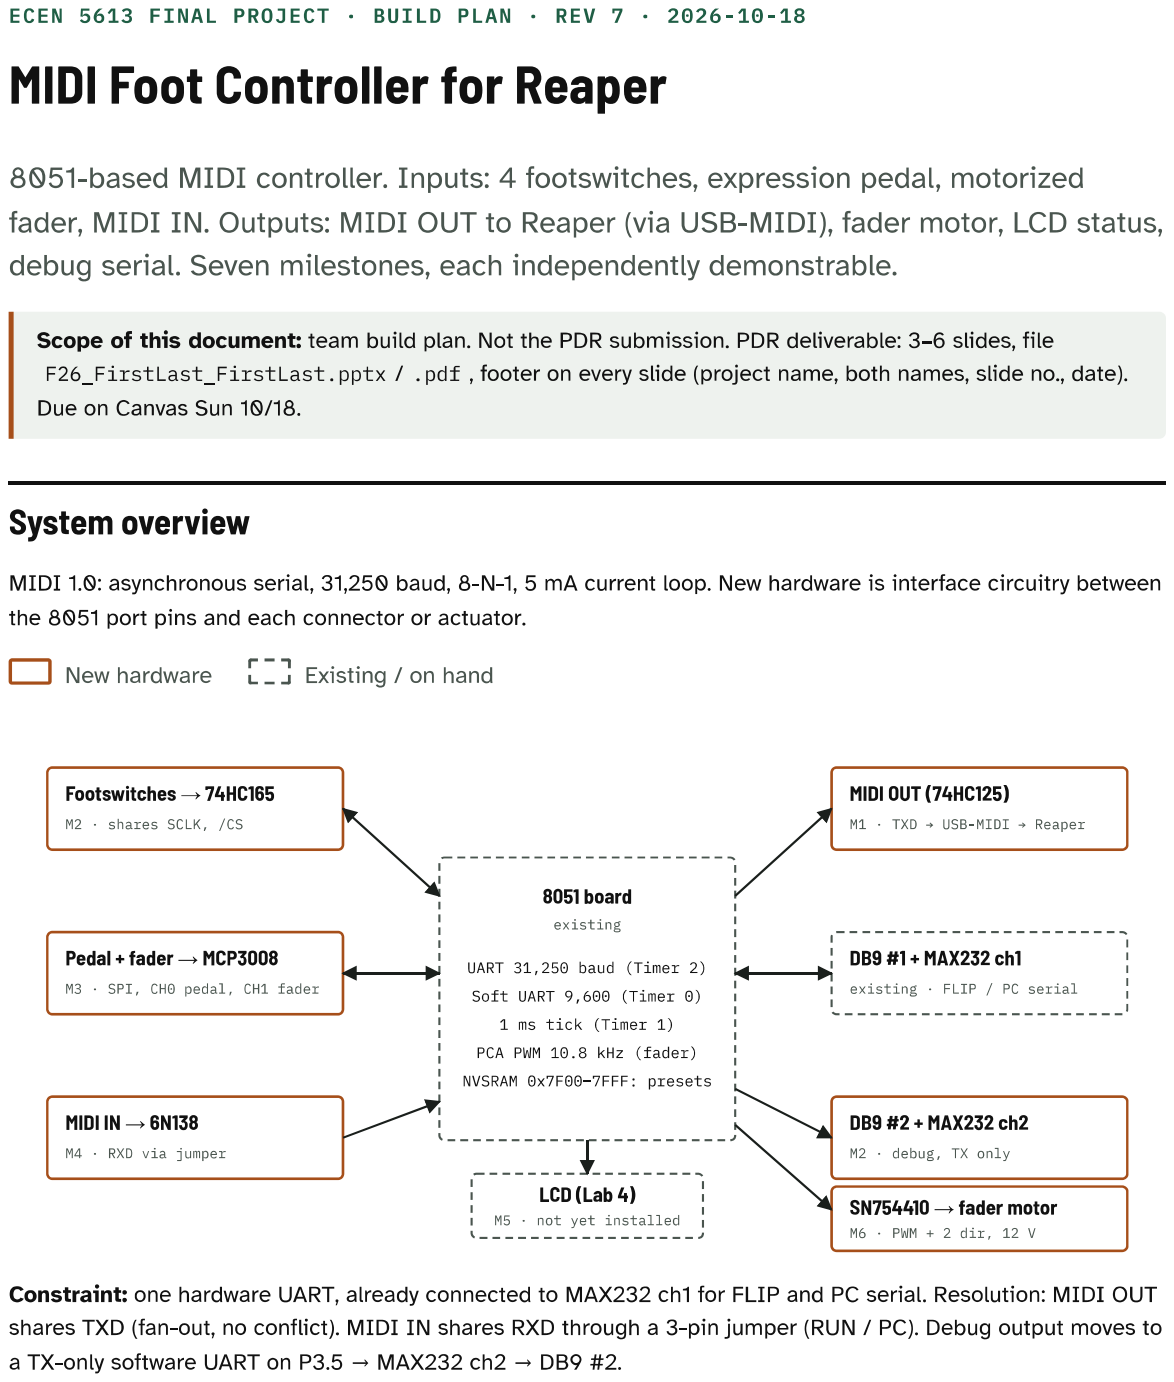
[picture p8: page 1]

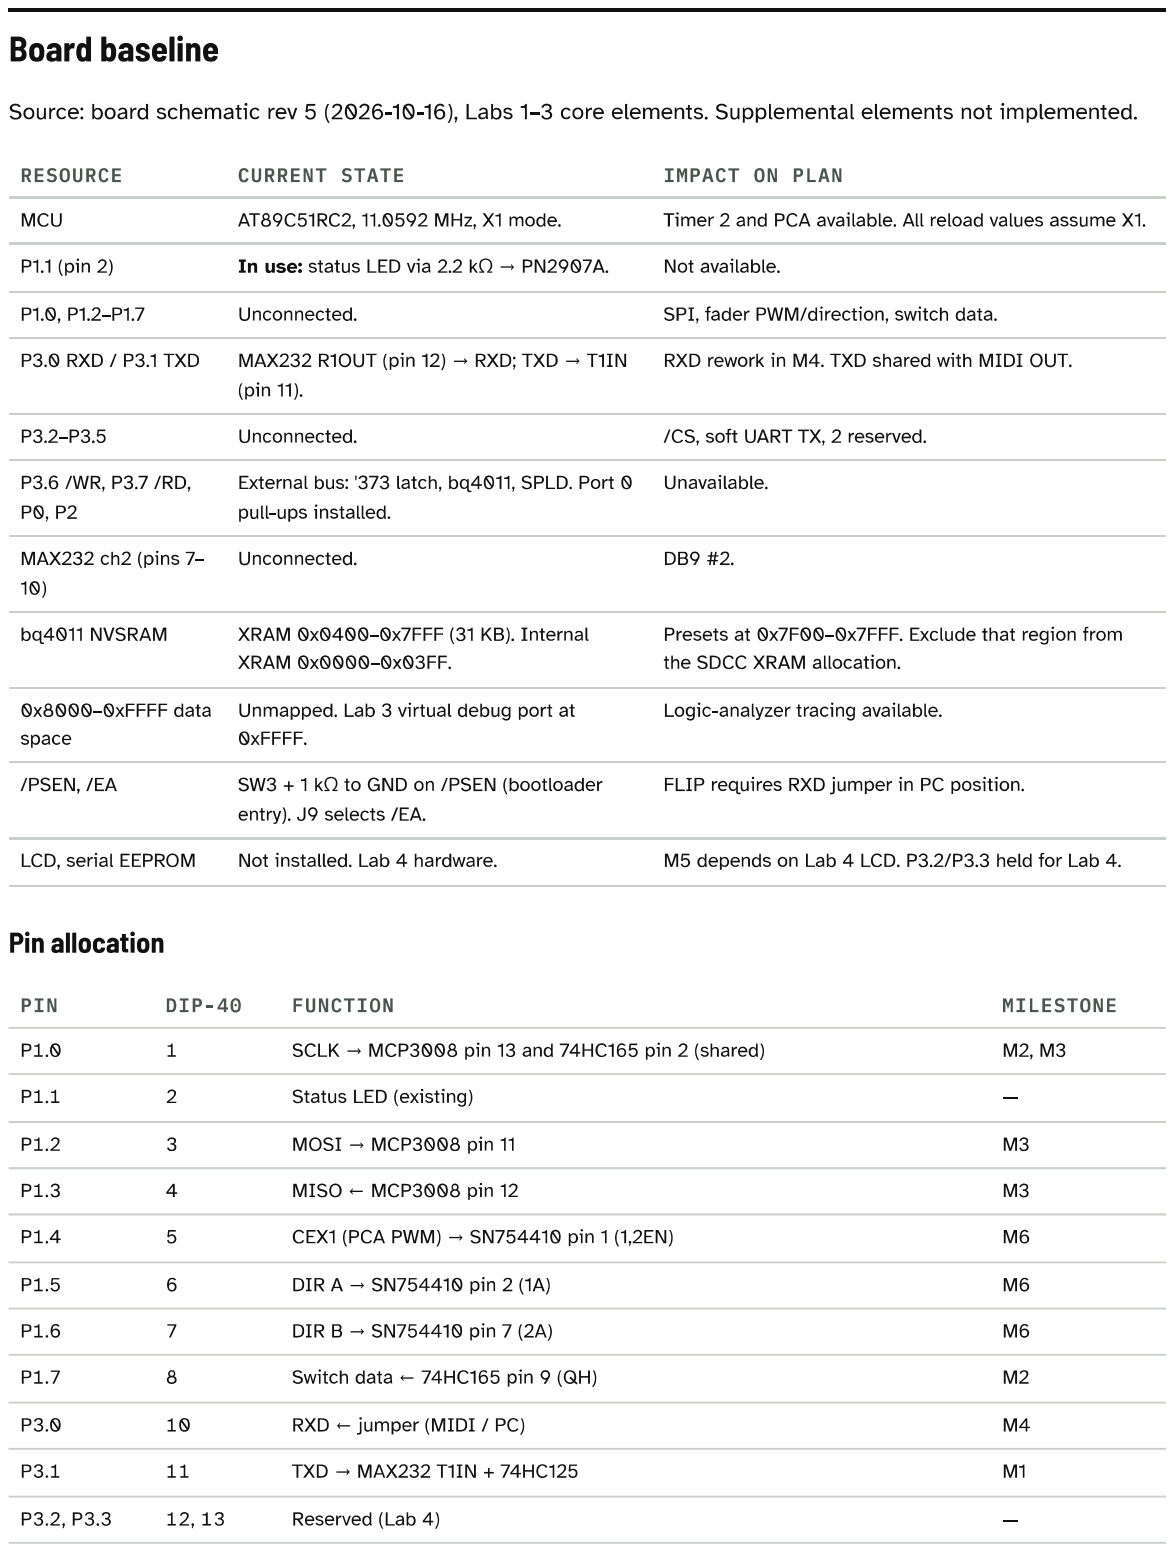
[picture p9: page 2]

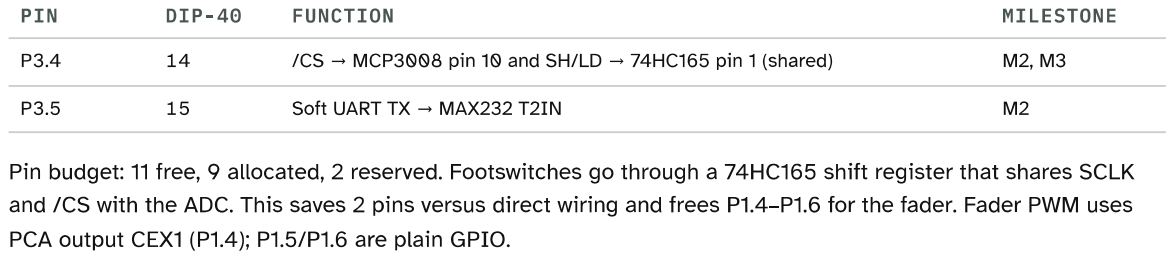
[picture p10: page 3]

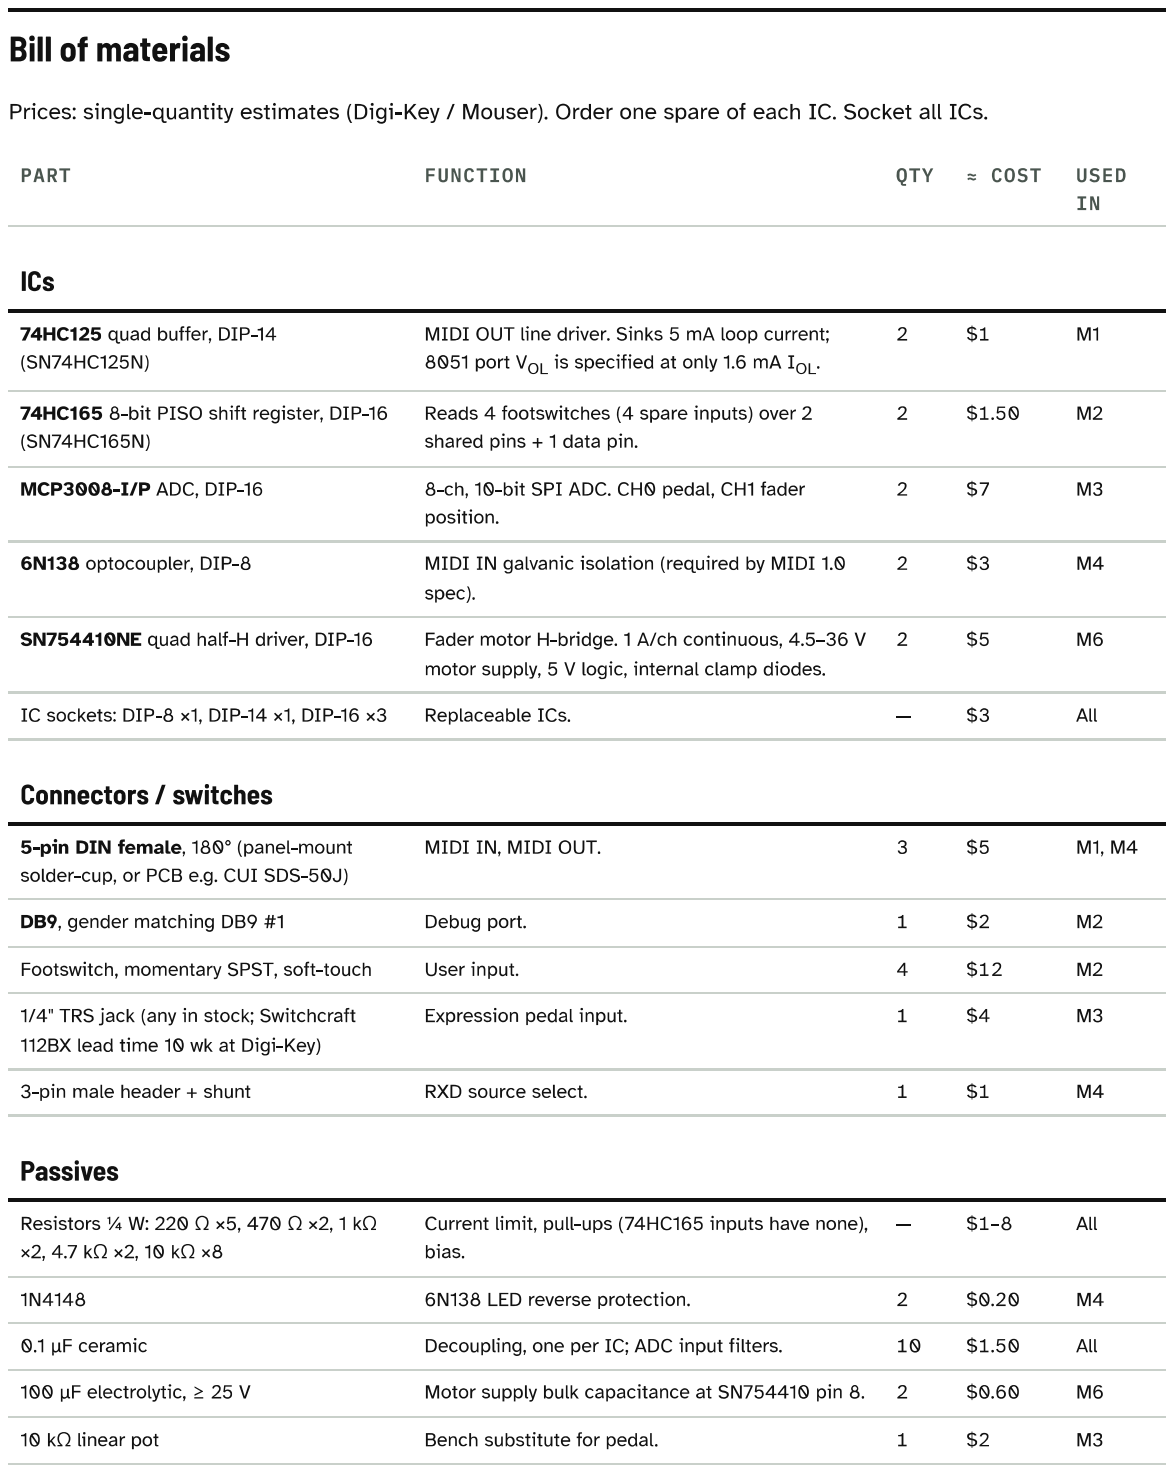
[picture p11: page 4]

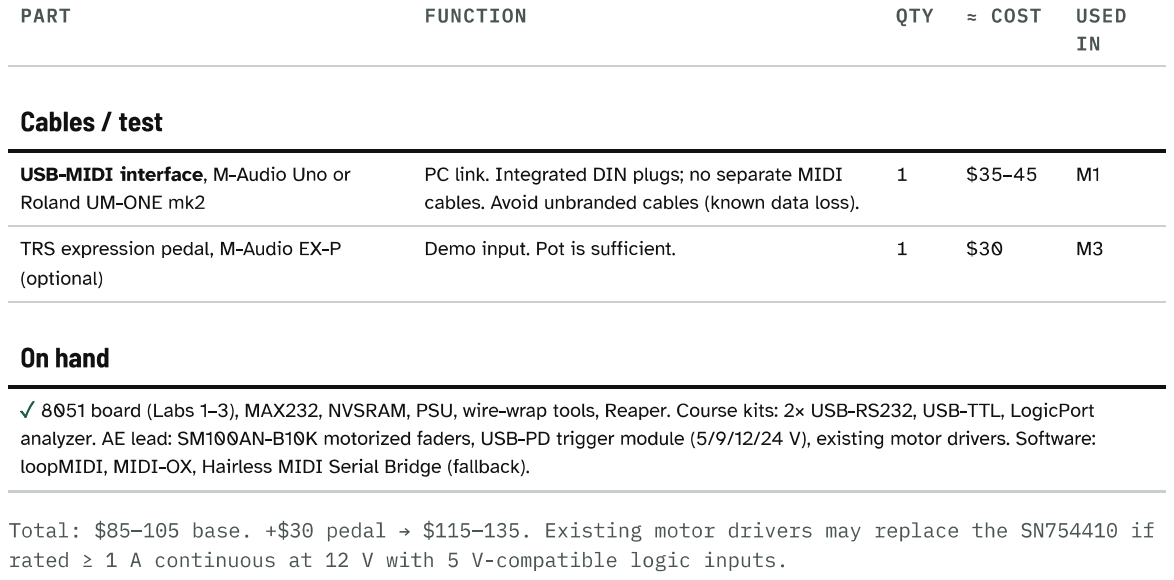
[picture p12: page 5]

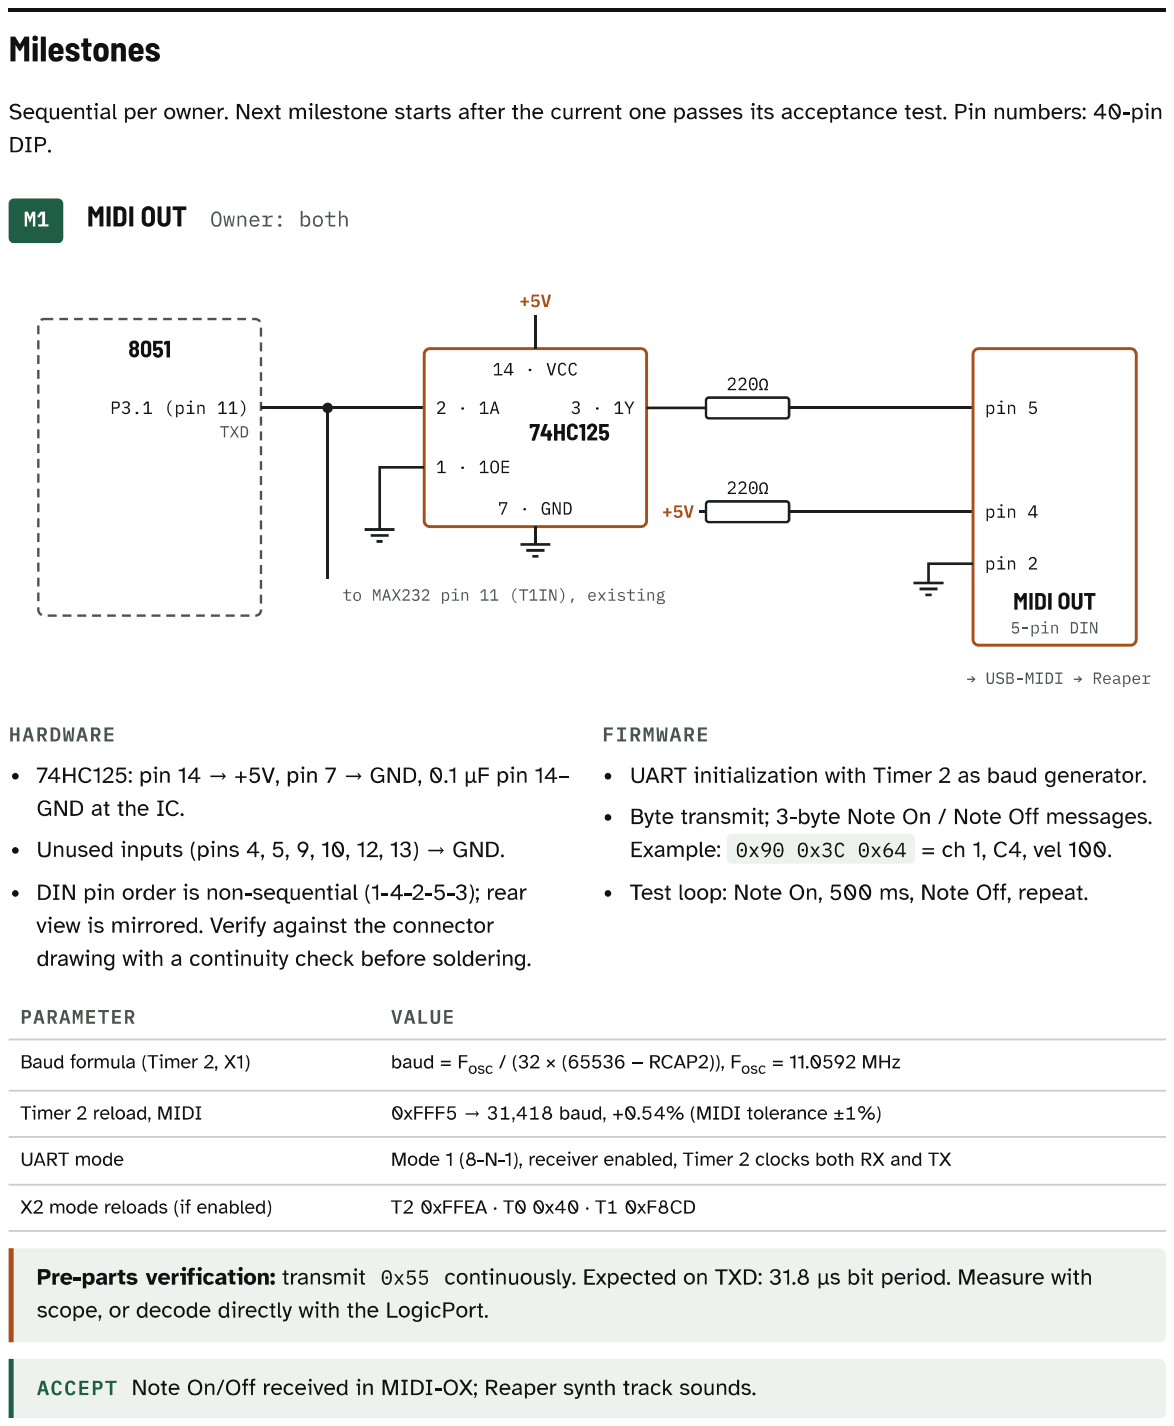
[picture p13: page 6]

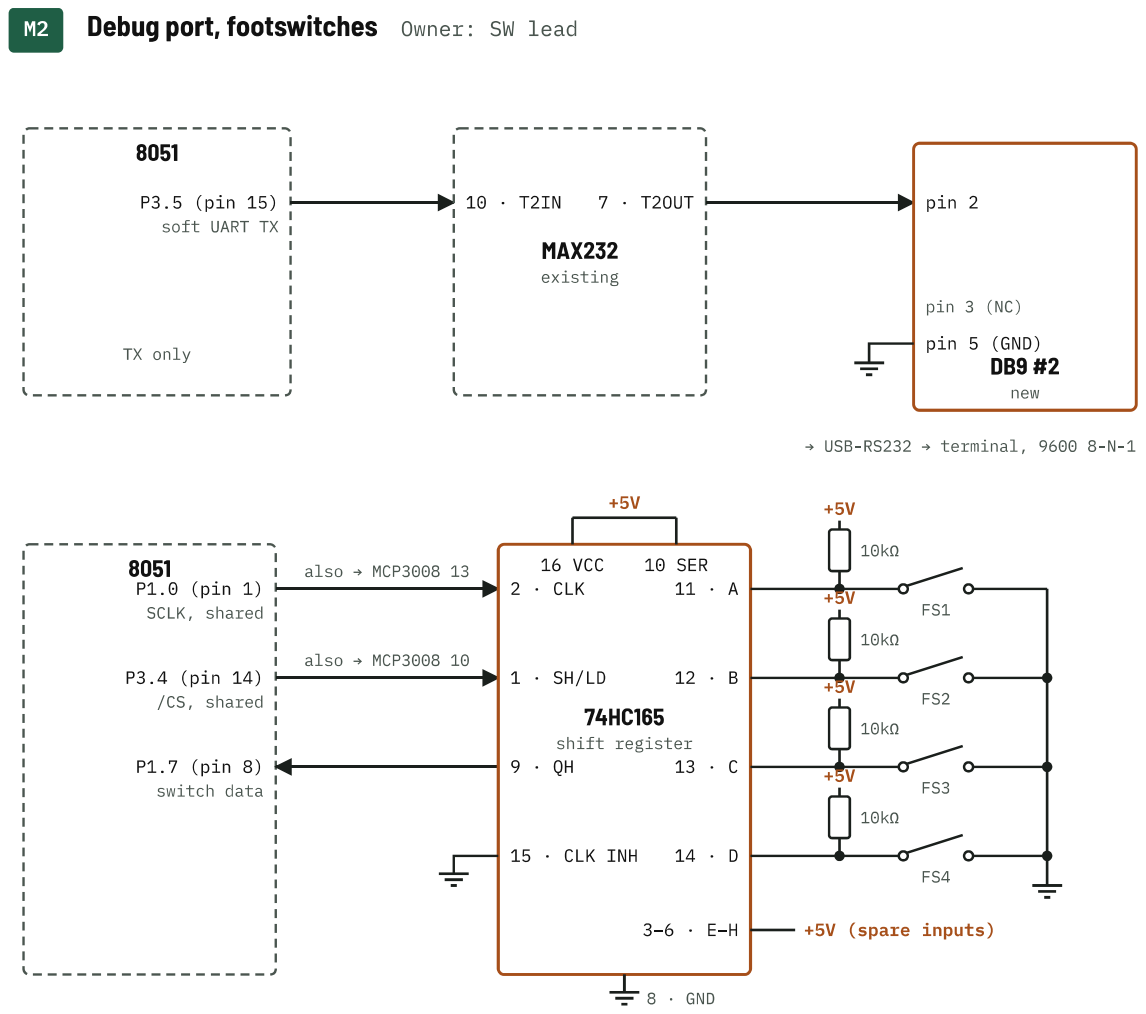
[picture p14: page 7]

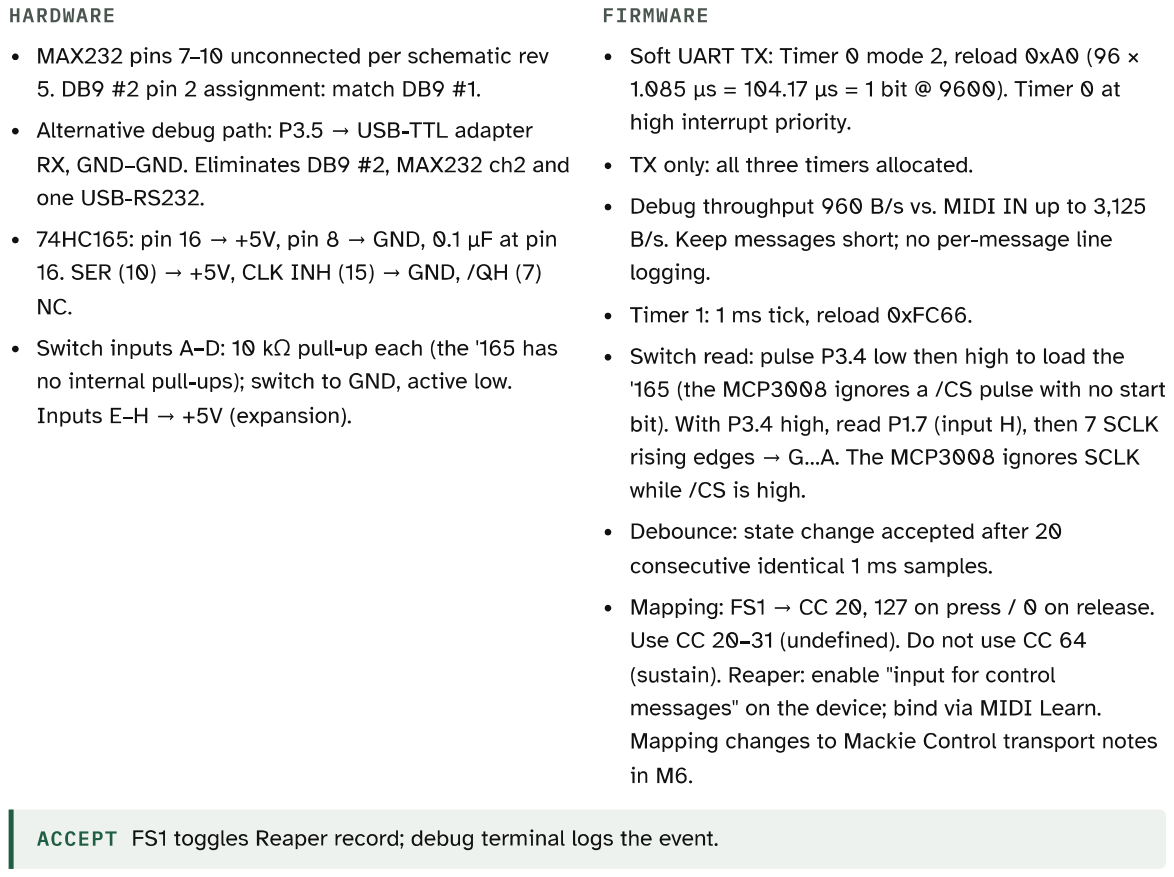
[picture p15: page 8]

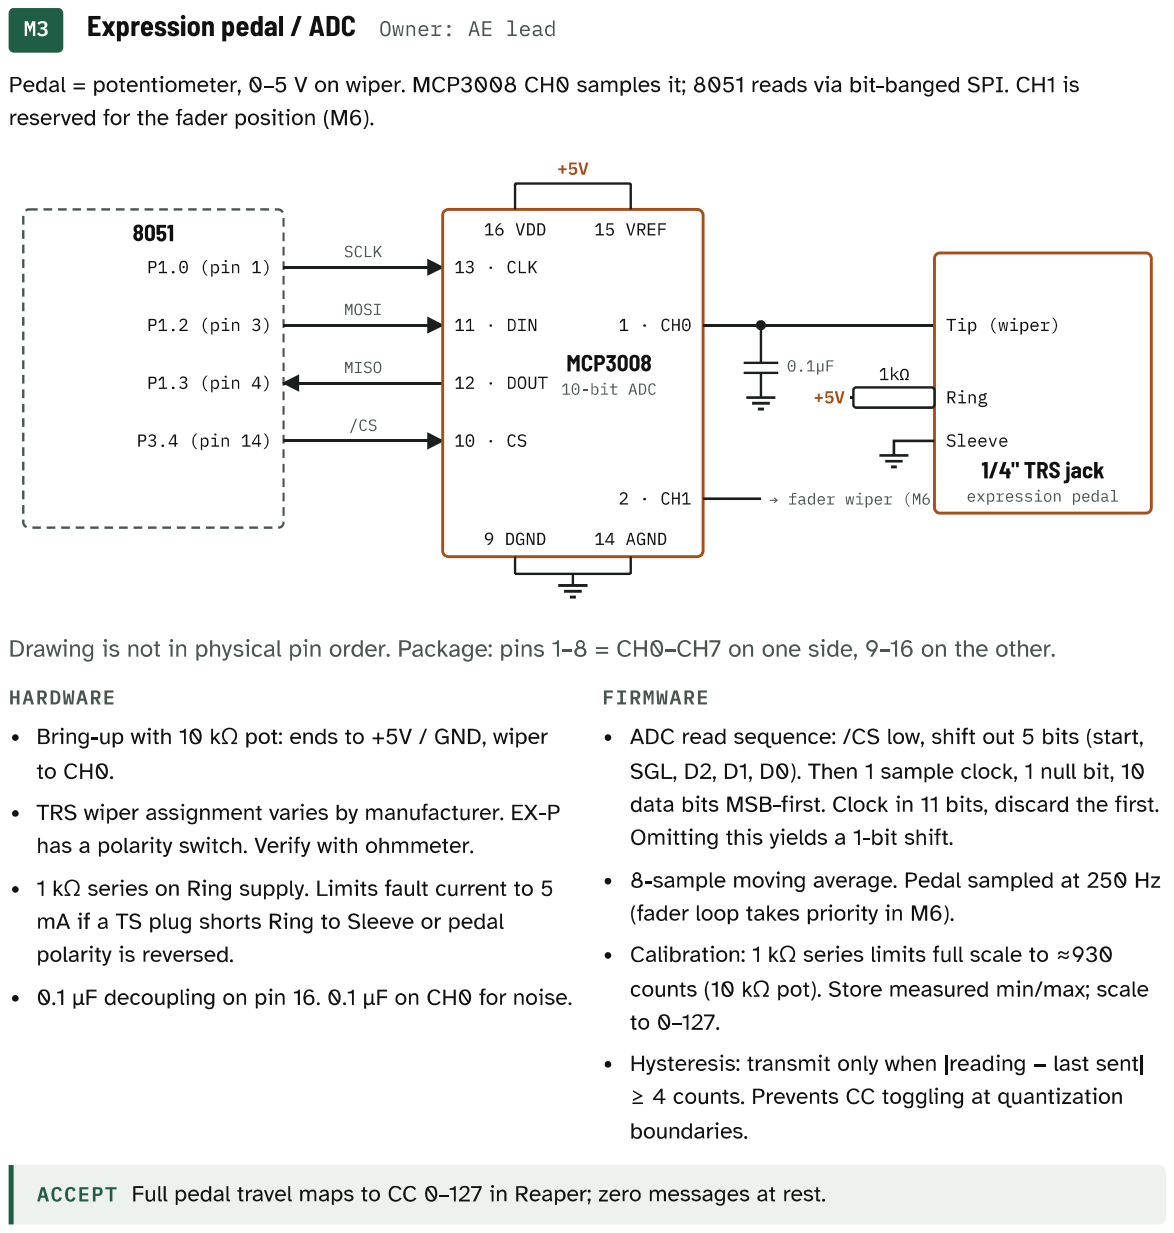
[picture p16: page 9]

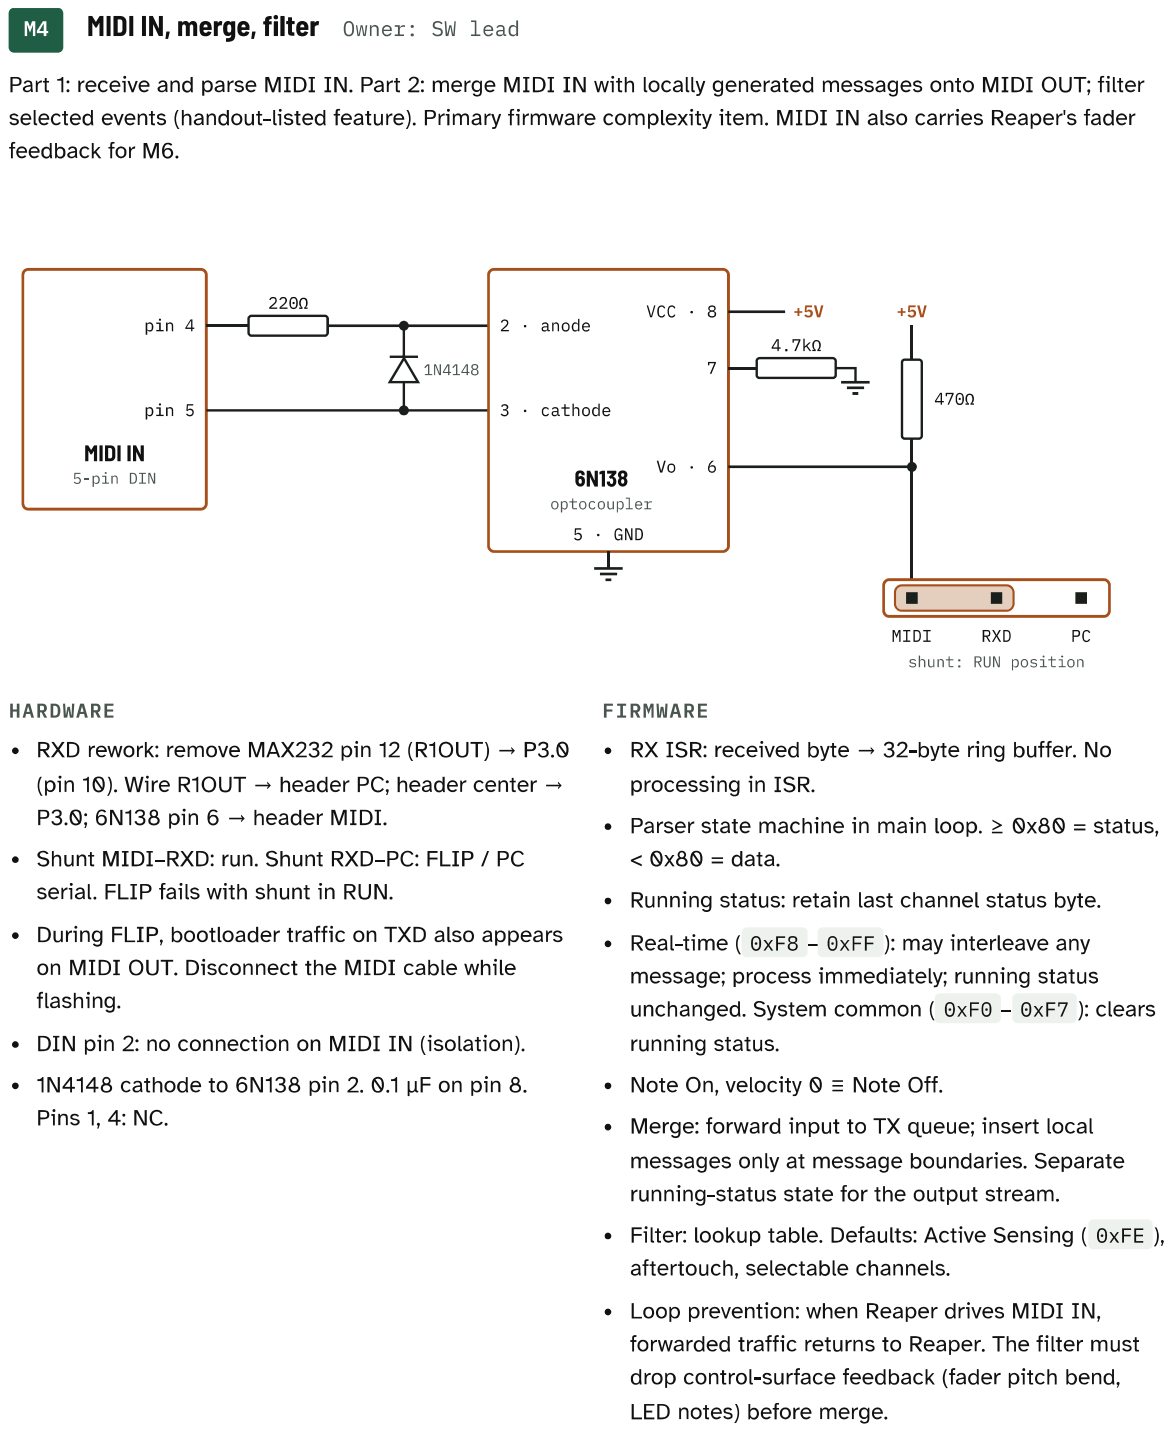
[picture p17: page 10]

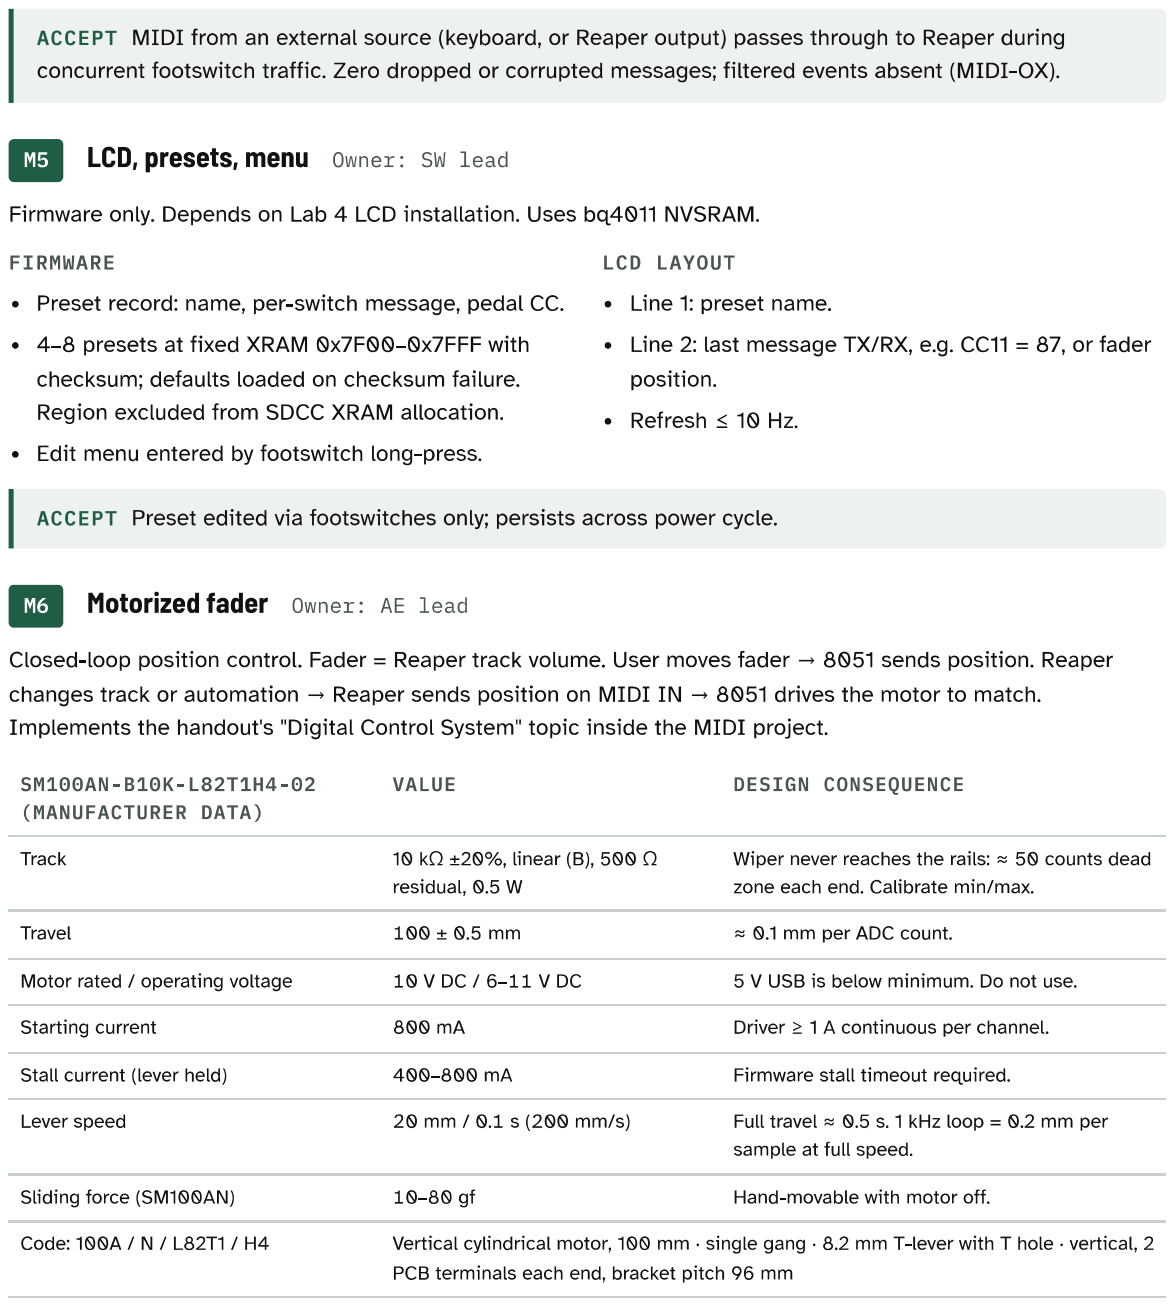
[picture p18: page 11]

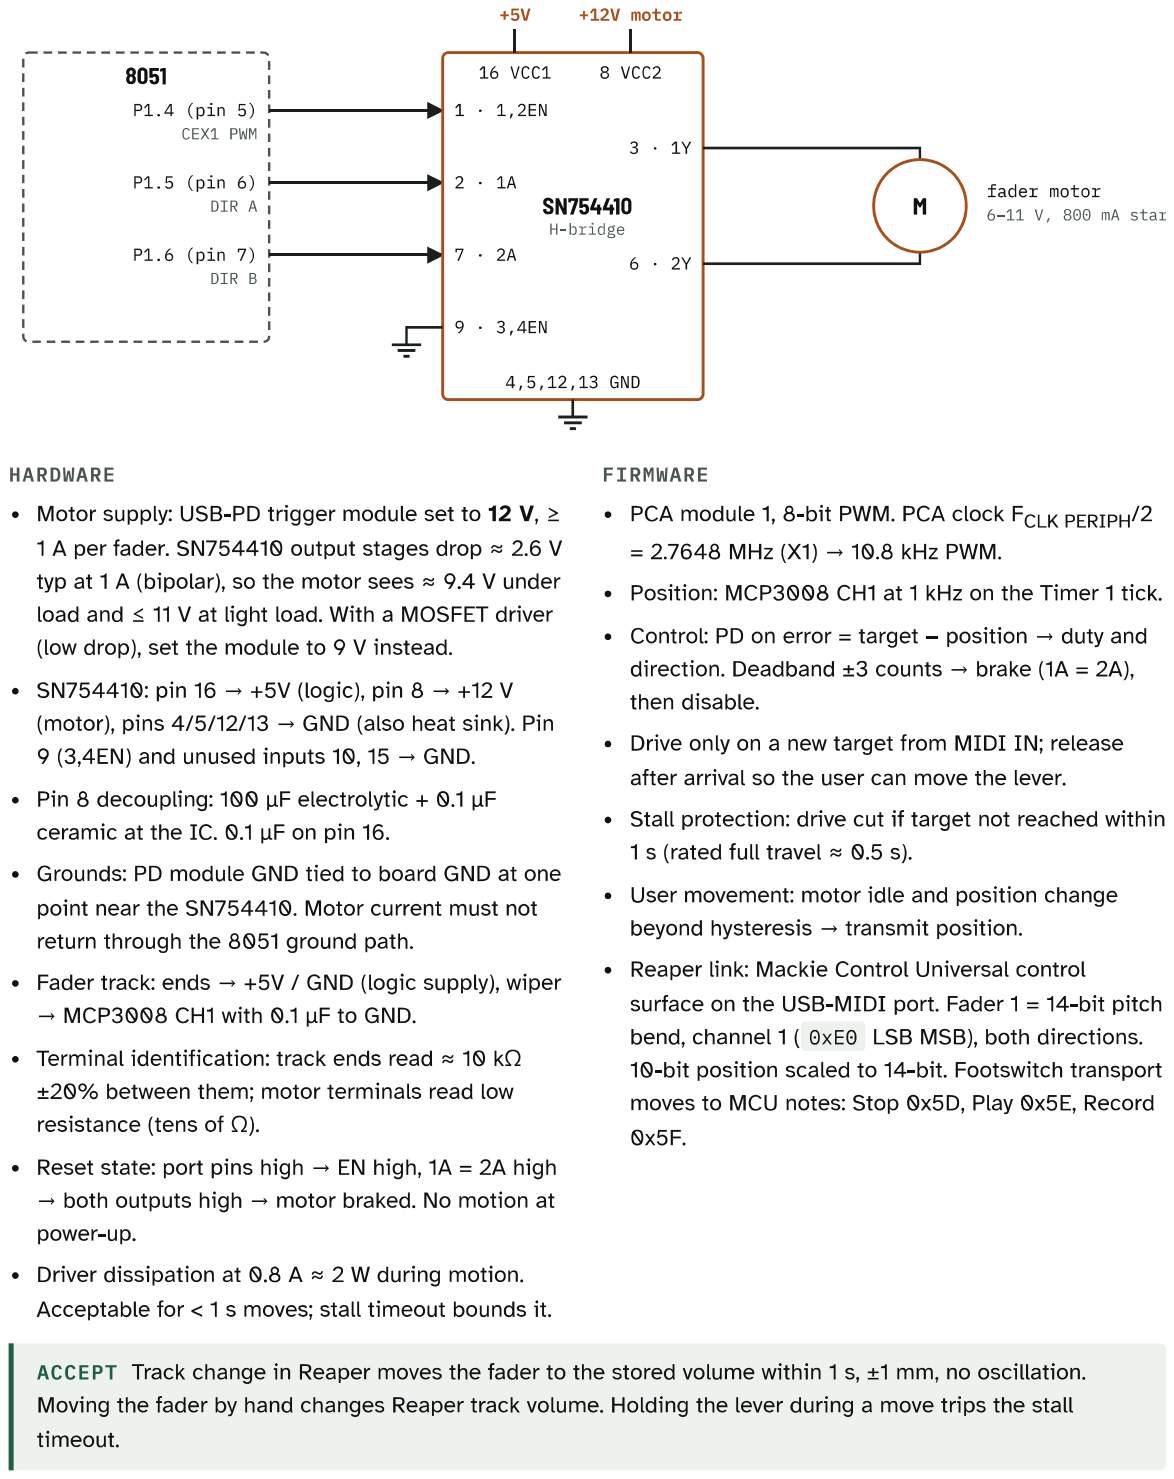
[picture p19: page 12]

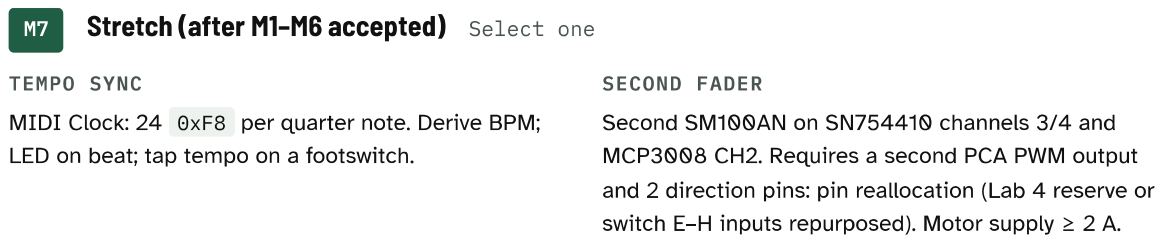
[picture p20: page 13]

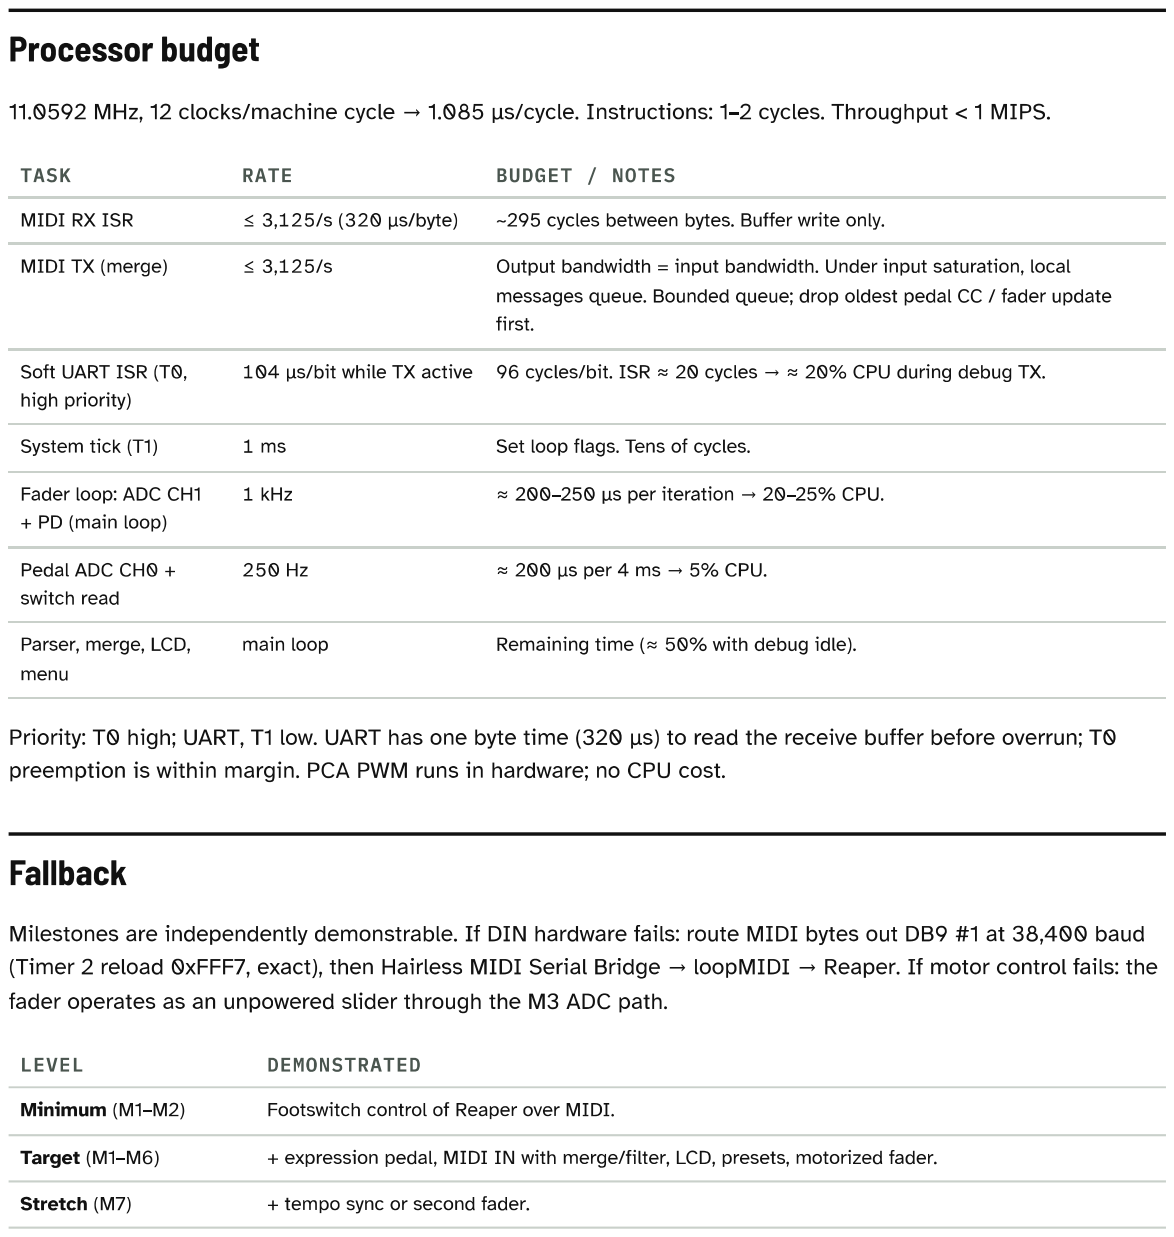
[picture p21: page 14]

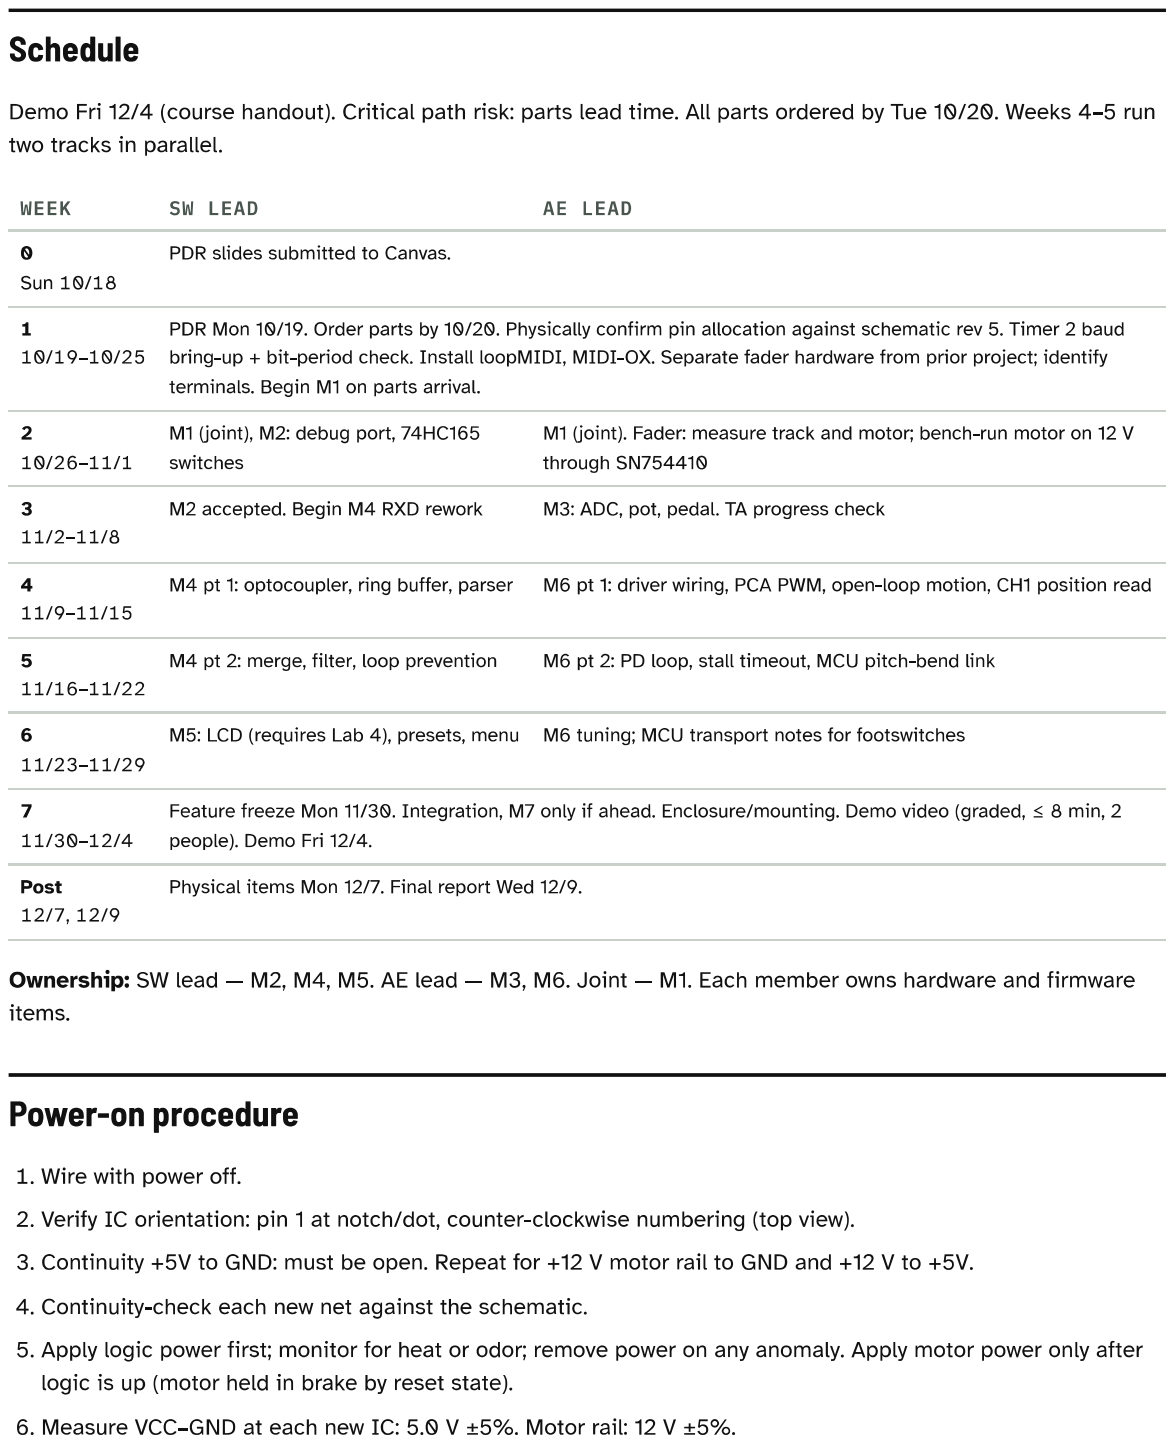
[picture p22: page 15]

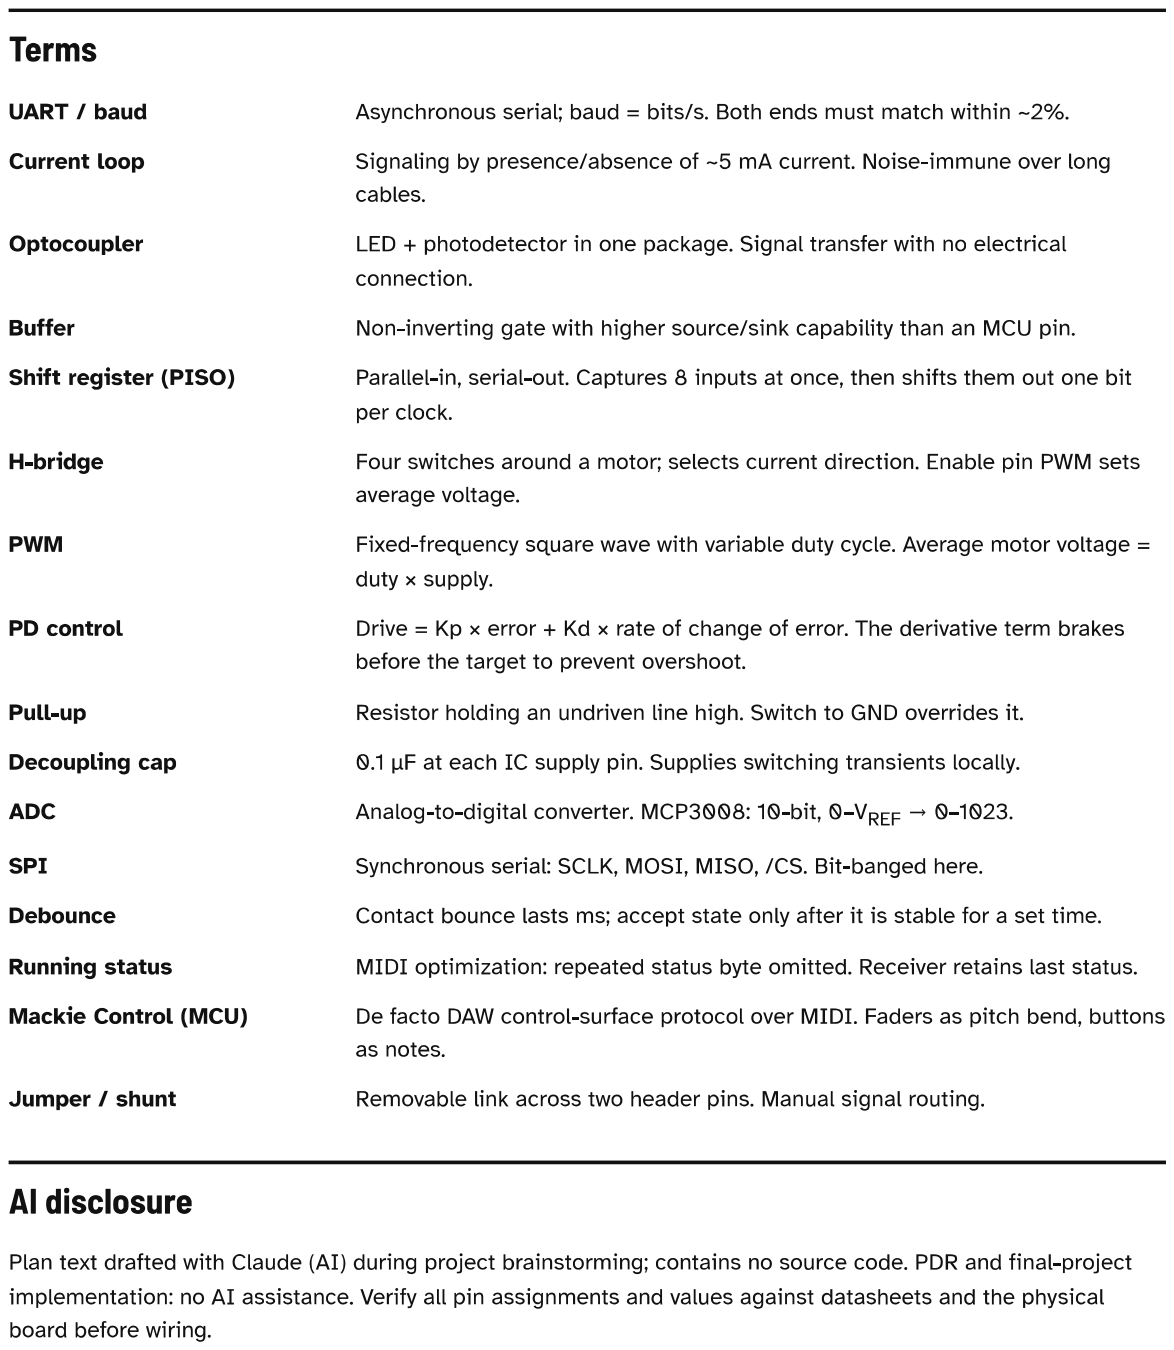
[picture p23: page 16]
