TravisNagle/ECEN5613_Final_Project/hardware/kicad/ESD_Final/btn_daughter.kicad_sch

## KiCad design hardware/kicad/ESD_Final/btn_daughter.kicad_sch (2026-10-25)

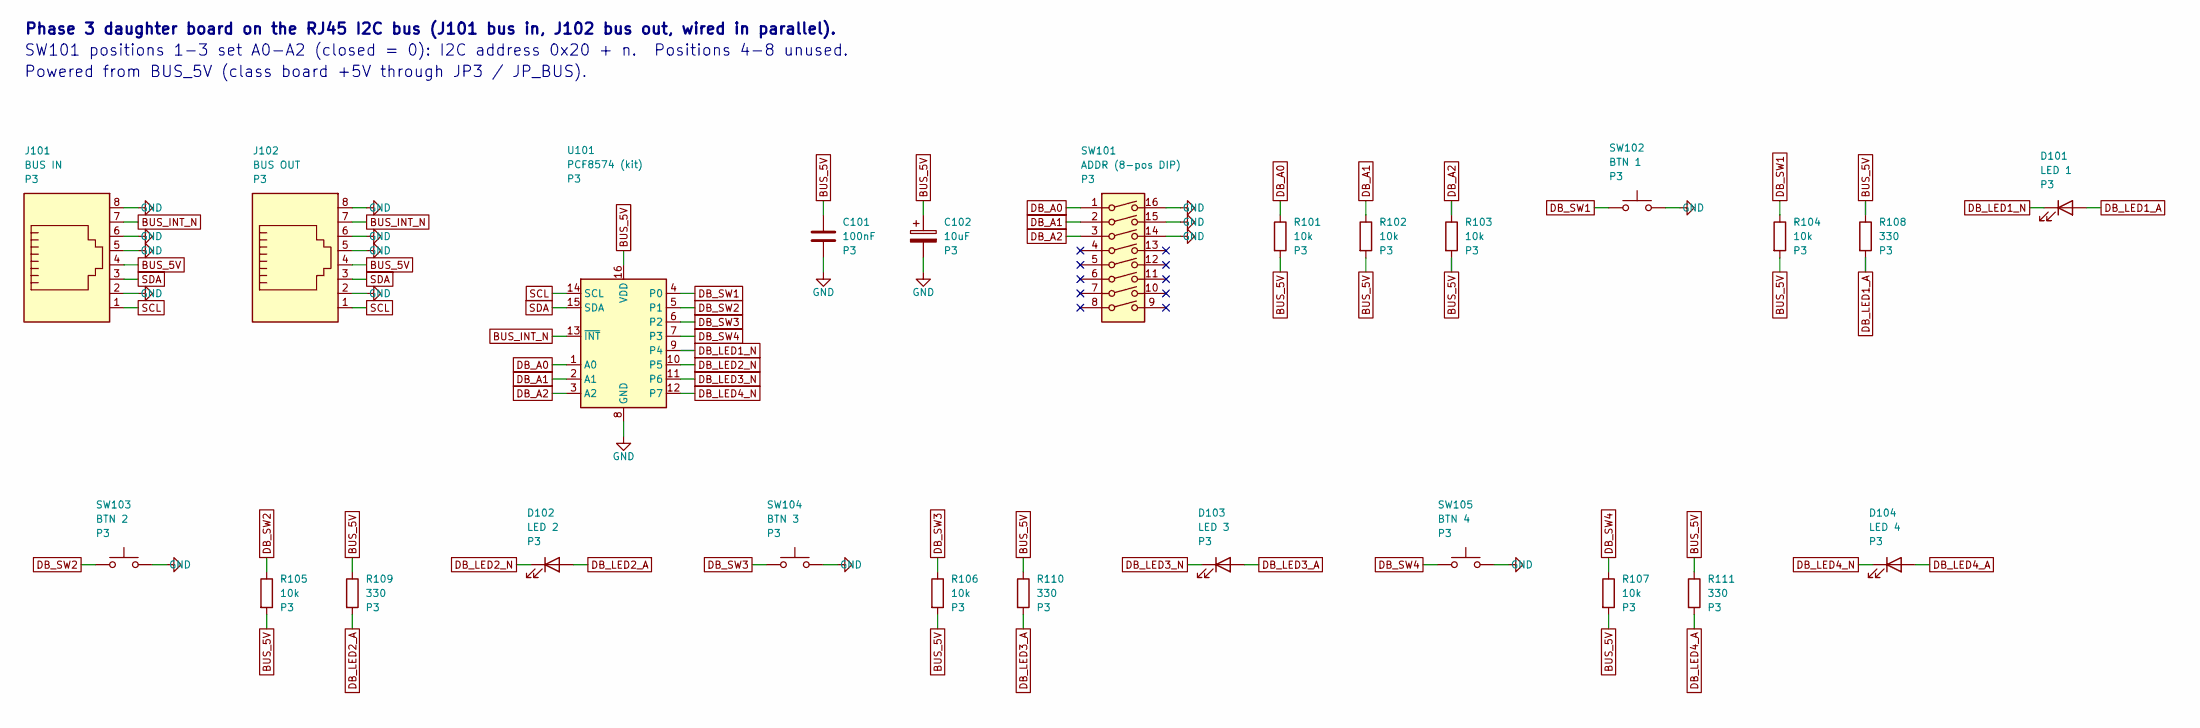
[picture p24: schematic btn_daughter.kicad_sch]

Parts:
C101: 100nF
C102: 10uF
D101: LED 1
D102: LED 2
D103: LED 3
D104: LED 4
J101: BUS IN
J102: BUS OUT
R101, R102, R103, R104, R105, R106, R107: 10k
R108, R109, R110, R111: 330
SW101: ADDR (8-pos DIP)
SW102: BTN 1
SW103: BTN 2
SW104: BTN 3
SW105: BTN 4
U101: PCF8574 (kit)

Connections:
BUS_5V: C101.1, C102.1, J101.4, J102.4, R101.2, R102.2, R103.2, R104.2, R105.2, R106.2, R107.2, R108.1, R109.1, R110.1, R111.1, U101.16 (VDD)
BUS_INT_N: J101.7, J102.7, U101.13 (~INT)
DB_A0: R101.1, SW101.1, U101.1 (A0)
DB_A1: R102.1, SW101.2, U101.2 (A1)
DB_A2: R103.1, SW101.3, U101.3 (A2)
DB_LED1_A: D101.2 (A), R108.2
DB_LED1_N: D101.1 (K), U101.9 (P4)
DB_LED2_A: D102.2 (A), R109.2
DB_LED2_N: D102.1 (K), U101.10 (P5)
DB_LED3_A: D103.2 (A), R110.2
DB_LED3_N: D103.1 (K), U101.11 (P6)
DB_LED4_A: D104.2 (A), R111.2
DB_LED4_N: D104.1 (K), U101.12 (P7)
DB_SW1: R104.1, SW102.1, U101.4 (P0)
DB_SW2: R105.1, SW103.1, U101.5 (P1)
DB_SW3: R106.1, SW104.1, U101.6 (P2)
DB_SW4: R107.1, SW105.1, U101.7 (P3)
GND: C101.2, C102.2, J101.2, J101.5, J101.6, J101.8, J102.2, J102.5, J102.6, J102.8, SW101.14, SW101.15, SW101.16, SW102.2, SW103.2, SW104.2, SW105.2, U101.8 (GND)
SCL: J101.1, J102.1, U101.14 (SCL)
SDA: J101.3, J102.3, U101.15 (SDA)

Notes on the sheet:
Phase 3 daughter board on the RJ45 I2C bus (J101 bus in, J102 bus out, wired in parallel).
SW101 positions 1-3 set A0-A2 (closed = 0): I2C address 0x20 + n. Positions 4-8 unused.
Powered from BUS_5V (class board +5V through JP3 / JP_BUS).
