TravisNagle/ECEN5613_Final_Project/hardware/kicad/ESD_Final/class_io.kicad_sch

## KiCad design hardware/kicad/ESD_Final/class_io.kicad_sch (2026-10-25)

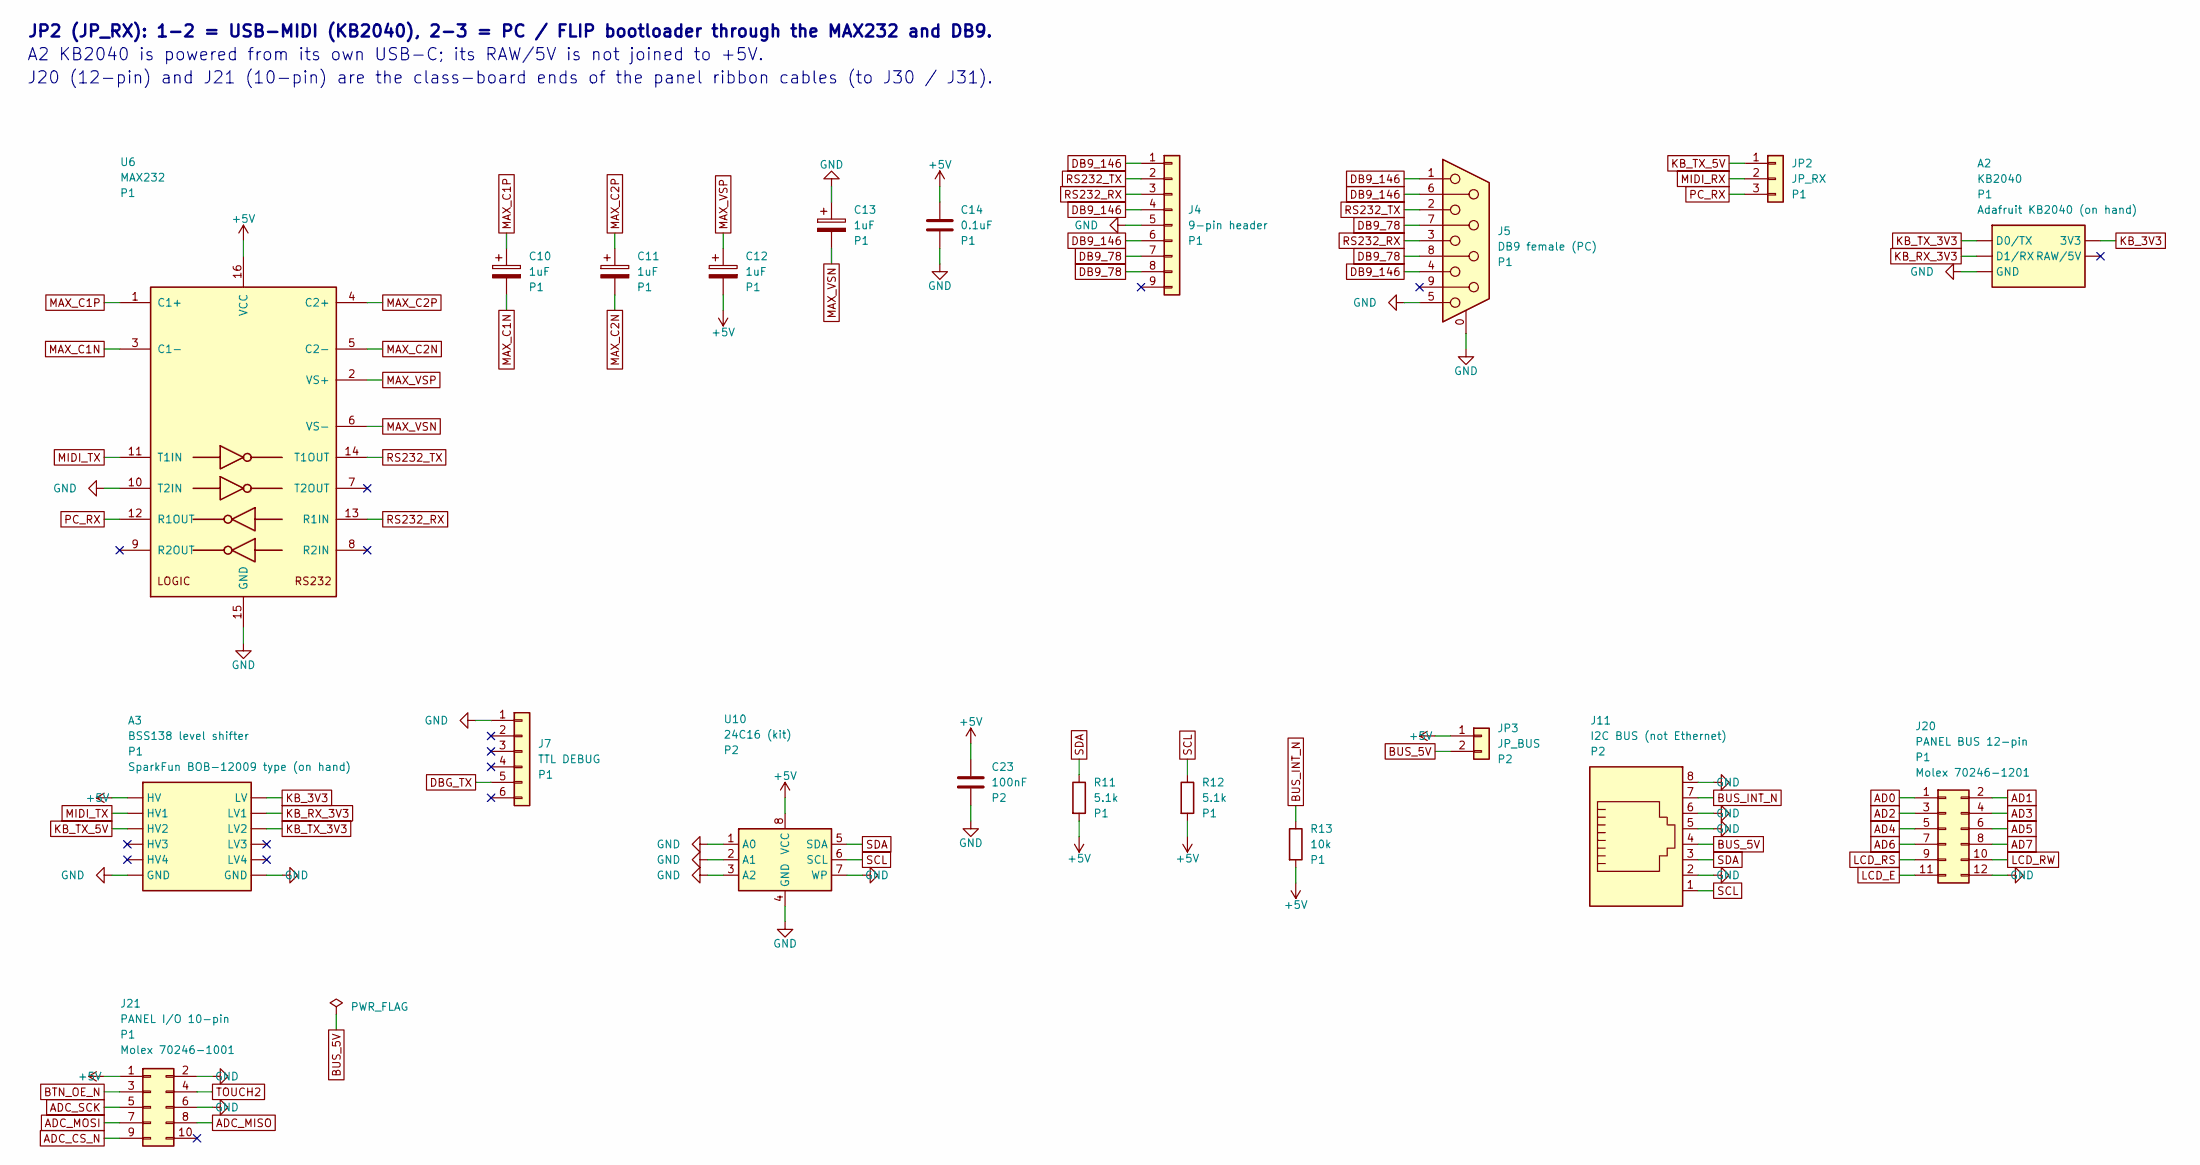
[picture p25: schematic class_io.kicad_sch]

Parts:
A2: KB2040; MPN Adafruit KB2040 (on hand)
A3: BSS138 level shifter; MPN SparkFun BOB-12009 type (on hand)
C10, C11, C12, C13: 1uF
C14: 0.1uF
C23: 100nF
J4: 9-pin header
J5: DB9 female (PC)
J7: TTL DEBUG
J11: I2C BUS (not Ethernet)
J20: PANEL BUS 12-pin; MPN Molex 70246-1201
J21: PANEL I/O 10-pin; MPN Molex 70246-1001
JP2: JP_RX
JP3: JP_BUS
R11, R12: 5.1k
R13: 10k
U6: MAX232
U10: 24C16 (kit)

Connections:
+5V: A3.HV, C12.2, C14.1, C23.1, J21.1, JP3.1, R11.2, R12.2, R13.2, U6.16 (VCC), U10.8 (VCC)
AD0: J20.1
AD1: J20.2
AD2: J20.3
AD3: J20.4
AD4: J20.5
AD5: J20.6
AD6: J20.7
AD7: J20.8
ADC_CS_N: J21.9
ADC_MISO: J21.8
ADC_MOSI: J21.7
ADC_SCK: J21.5
BTN_OE_N: J21.3
BUS_5V: J11.4, JP3.2
BUS_INT_N: J11.7, R13.1
DB9_78: J4.7, J4.8, J5.7, J5.8
DB9_146: J4.1, J4.4, J4.6, J5.1, J5.4, J5.6
DBG_TX: J7.5
GND: A2.GND, A3.GND1 (GND), A3.GND2 (GND), C13.1, C14.2, C23.2, J4.5, J5.0 (PAD), J5.5, J7.1, J11.2, J11.5, J11.6, J11.8, J20.12, J21.2, J21.6, U6.10 (T2IN), U6.15 (GND), U10.1 (A0), U10.2 (A1), U10.3 (A2), U10.4 (GND), U10.7 (WP)
KB_3V3: A2.3V3, A3.LV
KB_RX_3V3: A2.RX (D1/RX), A3.LV1
KB_TX_3V3: A2.TX (D0/TX), A3.LV2
KB_TX_5V: A3.HV2, JP2.1
LCD_E: J20.11
LCD_RS: J20.9
LCD_RW: J20.10
MAX_C1N: C10.2, U6.3 (C1-)
MAX_C1P: C10.1, U6.1 (C1+)
MAX_C2N: C11.2, U6.5 (C2-)
MAX_C2P: C11.1, U6.4 (C2+)
MAX_VSN: C13.2, U6.6 (VS-)
MAX_VSP: C12.1, U6.2 (VS+)
MIDI_RX: JP2.2
MIDI_TX: A3.HV1, U6.11 (T1IN)
PC_RX: JP2.3, U6.12 (R1OUT)
RS232_RX: J4.3, J5.3, U6.13 (R1IN)
RS232_TX: J4.2, J5.2, U6.14 (T1OUT)
SCL: J11.1, R12.1, U10.6 (SCL)
SDA: J11.3, R11.1, U10.5 (SDA)
TOUCH2: J21.4

Notes on the sheet:
JP2 (JP_RX): 1-2 = USB-MIDI (KB2040), 2-3 = PC / FLIP bootloader through the MAX232 and DB9.
A2 KB2040 is powered from its own USB-C; its RAW/5V is not joined to +5V.
J20 (12-pin) and J21 (10-pin) are the class-board ends of the panel ribbon cables (to J30 / J31).
