TravisNagle/ECEN5613_Final_Project/hardware/kicad/ESD_Final/class_mcu.kicad_sch

## KiCad design hardware/kicad/ESD_Final/class_mcu.kicad_sch (2026-10-25)

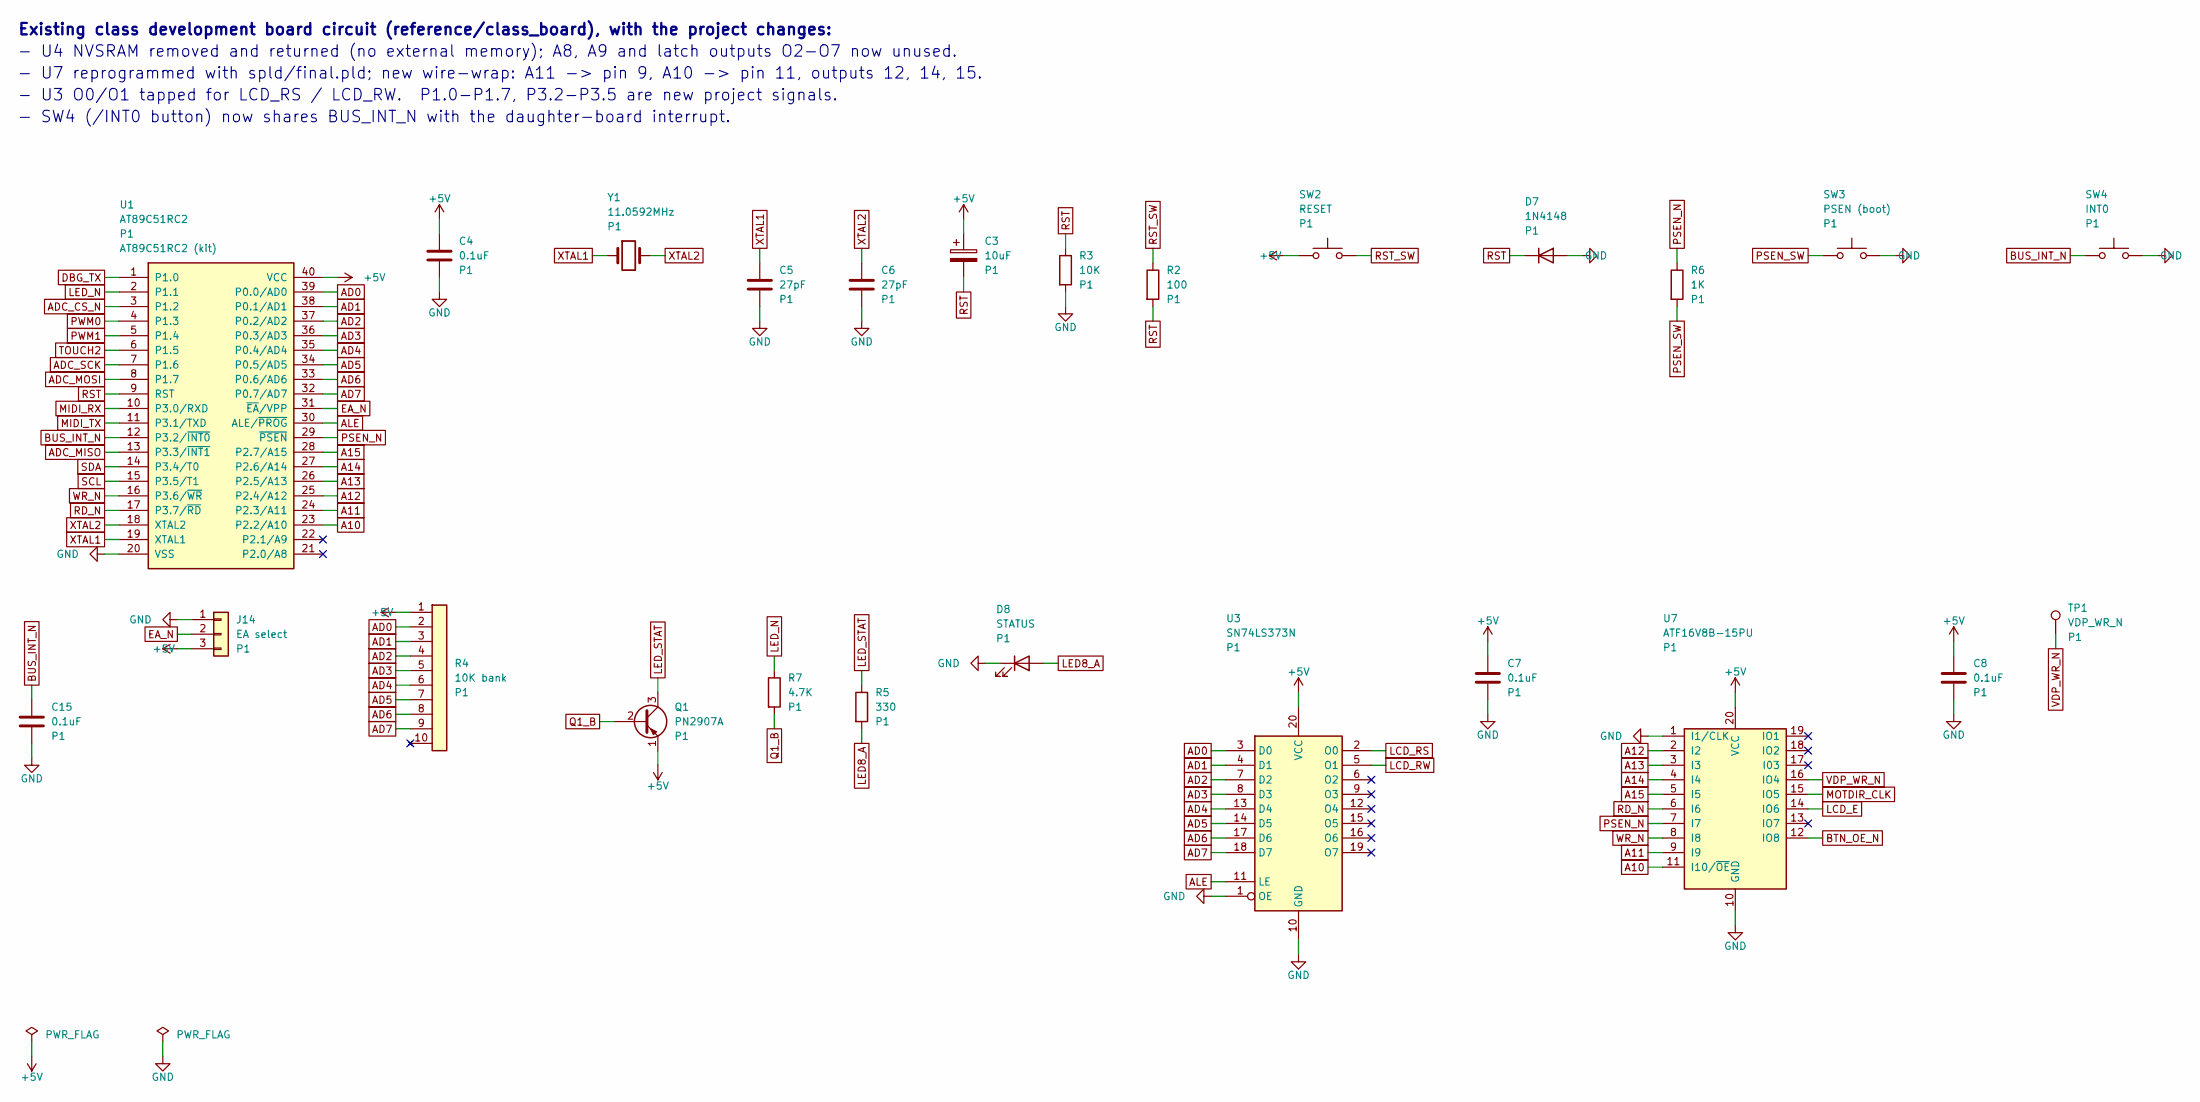
[picture p26: schematic class_mcu.kicad_sch]

Parts:
C3: 10uF
C4, C7, C8, C15: 0.1uF
C5, C6: 27pF
D7: 1N4148
D8: STATUS
J14: EA select
Q1: PN2907A
R2: 100
R3: 10K
R4: 10K bank
R5: 330
R6: 1K
R7: 4.7K
SW2: RESET
SW3: PSEN (boot)
SW4: INT0
TP1: VDP_WR_N
U1: AT89C51RC2; MPN AT89C51RC2 (kit)
U3: SN74LS373N
U7: ATF16V8B-15PU
Y1: 11.0592MHz

Connections:
+5V: C3.1, C4.1, C7.1, C8.1, J14.3, Q1.1 (E), R4.1 (COM), SW2.1, U1.40 (VCC), U3.20 (VCC), U7.20 (VCC)
A10: U1.23 (P2.2/A10), U7.11 (I10/~OE)
A11: U1.24 (P2.3/A11), U7.9 (I9)
A12: U1.25 (P2.4/A12), U7.2 (I2)
A13: U1.26 (P2.5/A13), U7.3 (I3)
A14: U1.27 (P2.6/A14), U7.4 (I4)
A15: U1.28 (P2.7/A15), U7.5 (I5)
AD0: R4.2 (R1), U1.39 (P0.0/AD0), U3.3 (D0)
AD1: R4.3 (R2), U1.38 (P0.1/AD1), U3.4 (D1)
AD2: R4.4 (R3), U1.37 (P0.2/AD2), U3.7 (D2)
AD3: R4.5 (R4), U1.36 (P0.3/AD3), U3.8 (D3)
AD4: R4.6 (R5), U1.35 (P0.4/AD4), U3.13 (D4)
AD5: R4.7 (R6), U1.34 (P0.5/AD5), U3.14 (D5)
AD6: R4.8 (R7), U1.33 (P0.6/AD6), U3.17 (D6)
AD7: R4.9 (R8), U1.32 (P0.7/AD7), U3.18 (D7)
ADC_CS_N: U1.3 (P1.2)
ADC_MISO: U1.13 (P3.3/~INT1)
ADC_MOSI: U1.8 (P1.7)
ADC_SCK: U1.7 (P1.6)
ALE: U1.30 (ALE/~PROG), U3.11 (LE)
BTN_OE_N: U7.12 (IO8)
BUS_INT_N: C15.1, SW4.1, U1.12 (P3.2/~INT0)
DBG_TX: U1.1 (P1.0)
EA_N: J14.2, U1.31 (~EA/VPP)
GND: C4.2, C5.2, C6.2, C7.2, C8.2, C15.2, D7.2 (A), D8.1 (K), J14.1, R3.2, SW3.2, SW4.2, U1.20 (VSS), U3.1 (OE), U3.10 (GND), U7.1 (I1/CLK), U7.10 (GND)
LCD_E: U7.14 (IO6)
LCD_RS: U3.2 (O0)
LCD_RW: U3.5 (O1)
LED8_A: D8.2 (A), R5.2
LED_N: R7.1, U1.2 (P1.1)
LED_STAT: Q1.3 (C), R5.1
MIDI_RX: U1.10 (P3.0/RXD)
MIDI_TX: U1.11 (P3.1/TXD)
MOTDIR_CLK: U7.15 (IO5)
PSEN_N: R6.1, U1.29 (~PSEN), U7.7 (I7)
PSEN_SW: R6.2, SW3.1
PWM0: U1.4 (P1.3)
PWM1: U1.5 (P1.4)
Q1_B: Q1.2 (B), R7.2
RD_N: U1.17 (P3.7/~RD), U7.6 (I6)
RST: C3.2, D7.1 (K), R2.2, R3.1, U1.9 (RST)
RST_SW: R2.1, SW2.2
SCL: U1.15 (P3.5/T1)
SDA: U1.14 (P3.4/T0)
TOUCH2: U1.6 (P1.5)
VDP_WR_N: TP1.1, U7.16 (IO4)
WR_N: U1.16 (P3.6/~WR), U7.8 (I8)
XTAL1: C5.1, U1.19 (XTAL1), Y1.1
XTAL2: C6.1, U1.18 (XTAL2), Y1.2

Notes on the sheet:
Existing class development board circuit (reference/class_board), with the project changes:
- U4 NVSRAM removed and returned (no external memory); A8, A9 and latch outputs O2-O7 now unused.
- U7 reprogrammed with spld/final.pld; new wire-wrap: A11 -> pin 9, A10 -> pin 11, outputs 12, 14, 15.
- U3 O0/O1 tapped for LCD_RS / LCD_RW. P1.0-P1.7, P3.2-P3.5 are new project signals.
- SW4 (/INT0 button) now shares BUS_INT_N with the daughter-board interrupt.
