TravisNagle/ECEN5613_Final_Project/hardware/kicad/ESD_Final/class_power.kicad_sch

## KiCad design hardware/kicad/ESD_Final/class_power.kicad_sch (2026-10-25)

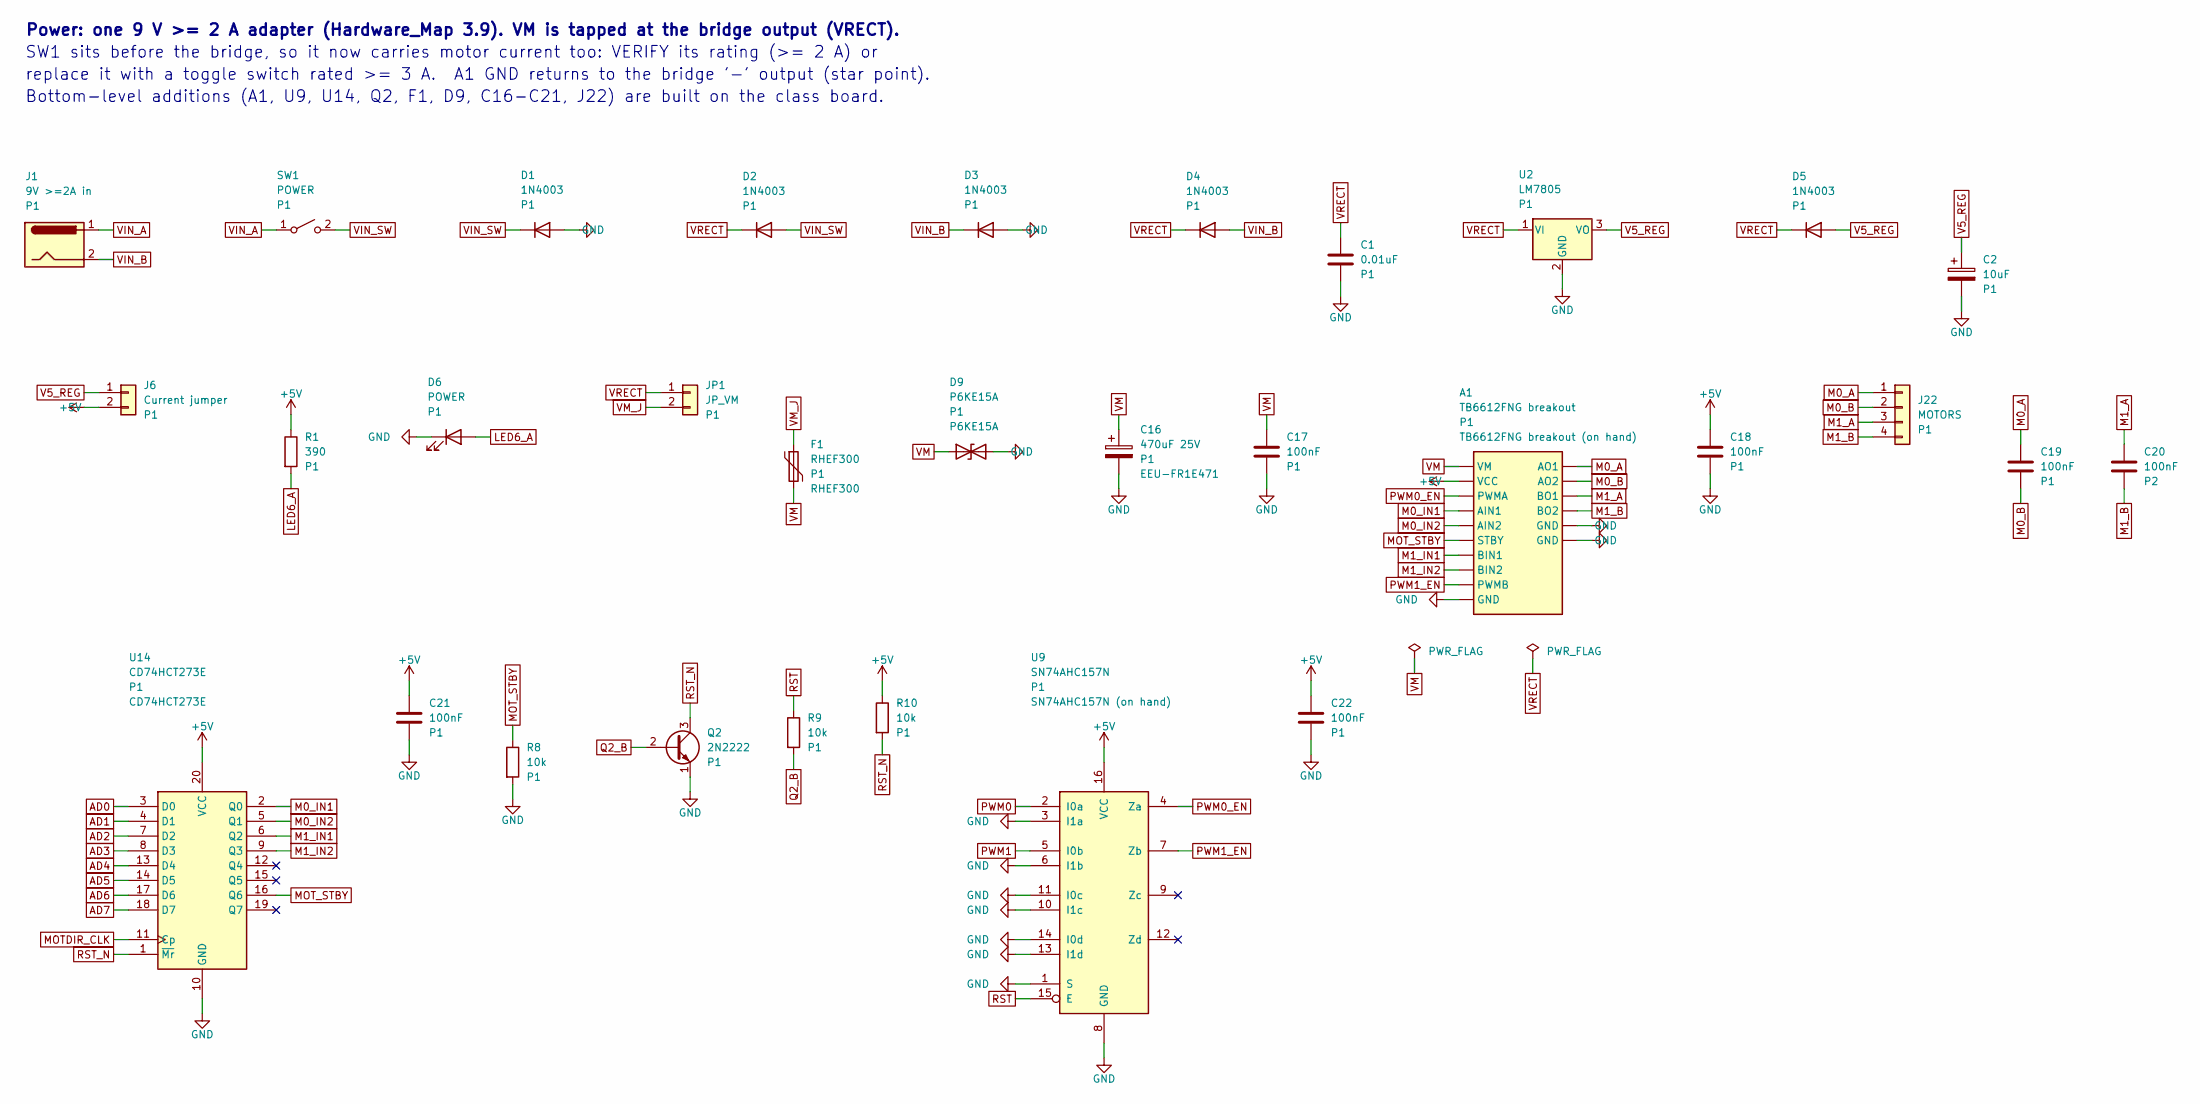
[picture p27: schematic class_power.kicad_sch]

Parts:
A1: TB6612FNG breakout; MPN TB6612FNG breakout (on hand)
C1: 0.01uF
C2: 10uF
C16: 470uF 25V; MPN EEU-FR1E471
C17, C18, C19, C20, C21, C22: 100nF
D1, D2, D3, D4, D5: 1N4003
D6: POWER
D9: P6KE15A; MPN P6KE15A
F1: RHEF300; MPN RHEF300
J1: 9V >=2A in
J6: Current jumper
J22: MOTORS
JP1: JP_VM
Q2: 2N2222
R1: 390
R8, R9, R10: 10k
SW1: POWER
U2: LM7805
U9: SN74AHC157N; MPN SN74AHC157N (on hand)
U14: CD74HCT273E; MPN CD74HCT273E

Connections:
+5V: A1.VCC, C18.1, C21.1, C22.1, J6.2, R1.1, R10.1, U9.16 (VCC), U14.20 (VCC)
AD0: U14.3 (D0)
AD1: U14.4 (D1)
AD2: U14.7 (D2)
AD3: U14.8 (D3)
AD4: U14.13 (D4)
AD5: U14.14 (D5)
AD6: U14.17 (D6)
AD7: U14.18 (D7)
GND: A1.G1 (GND), A1.G2 (GND), A1.G3 (GND), C1.2, C2.2, C16.2, C17.2, C18.2, C21.2, C22.2, D1.2 (A), D3.2 (A), D6.1 (K), D9.2 (A2), Q2.1 (E), R8.2, U2.2 (GND), U9.1 (S), U9.3 (I1a), U9.6 (I1b), U9.8 (GND), U9.10 (I1c), U9.11 (I0c), U9.13 (I1d), U9.14 (I0d), U14.10 (GND)
LED6_A: D6.2 (A), R1.2
M0_A: A1.AO1, C19.1, J22.1
M0_B: A1.AO2, C19.2, J22.2
M0_IN1: A1.AIN1, U14.2 (Q0)
M0_IN2: A1.AIN2, U14.5 (Q1)
M1_A: A1.BO1, C20.1, J22.3
M1_B: A1.BO2, C20.2, J22.4
M1_IN1: A1.BIN1, U14.6 (Q2)
M1_IN2: A1.BIN2, U14.9 (Q3)
MOTDIR_CLK: U14.11 (Cp)
MOT_STBY: A1.STBY, R8.1, U14.16 (Q6)
PWM0: U9.2 (I0a)
PWM0_EN: A1.PWMA, U9.4 (Za)
PWM1: U9.5 (I0b)
PWM1_EN: A1.PWMB, U9.7 (Zb)
Q2_B: Q2.2 (B), R9.2
RST: R9.1, U9.15 (E)
RST_N: Q2.3 (C), R10.2, U14.1 (~Mr)
V5_REG: C2.1, D5.2 (A), J6.1, U2.3 (VO)
VIN_A: J1.1, SW1.1 (A)
VIN_B: D3.1 (K), D4.2 (A), J1.2
VIN_SW: D1.1 (K), D2.2 (A), SW1.2 (B)
VM: A1.VM, C16.1, C17.1, D9.1 (A1), F1.2
VM_J: F1.1, JP1.2
VRECT: C1.1, D2.1 (K), D4.1 (K), D5.1 (K), JP1.1, U2.1 (VI)

Notes on the sheet:
Power: one 9 V >= 2 A adapter (Hardware_Map 3.9). VM is tapped at the bridge output (VRECT).
SW1 sits before the bridge, so it now carries motor current too: VERIFY its rating (>= 2 A) or
replace it with a toggle switch rated >= 3 A. A1 GND returns to the bridge '-' output (star point).
Bottom-level additions (A1, U9, U14, Q2, F1, D9, C16-C21, J22) are built on the class board.
