TravisNagle/ECEN5613_Final_Project/hardware/kicad/ESD_Final/dpad.kicad_sch

## KiCad design hardware/kicad/ESD_Final/dpad.kicad_sch (2026-10-25)

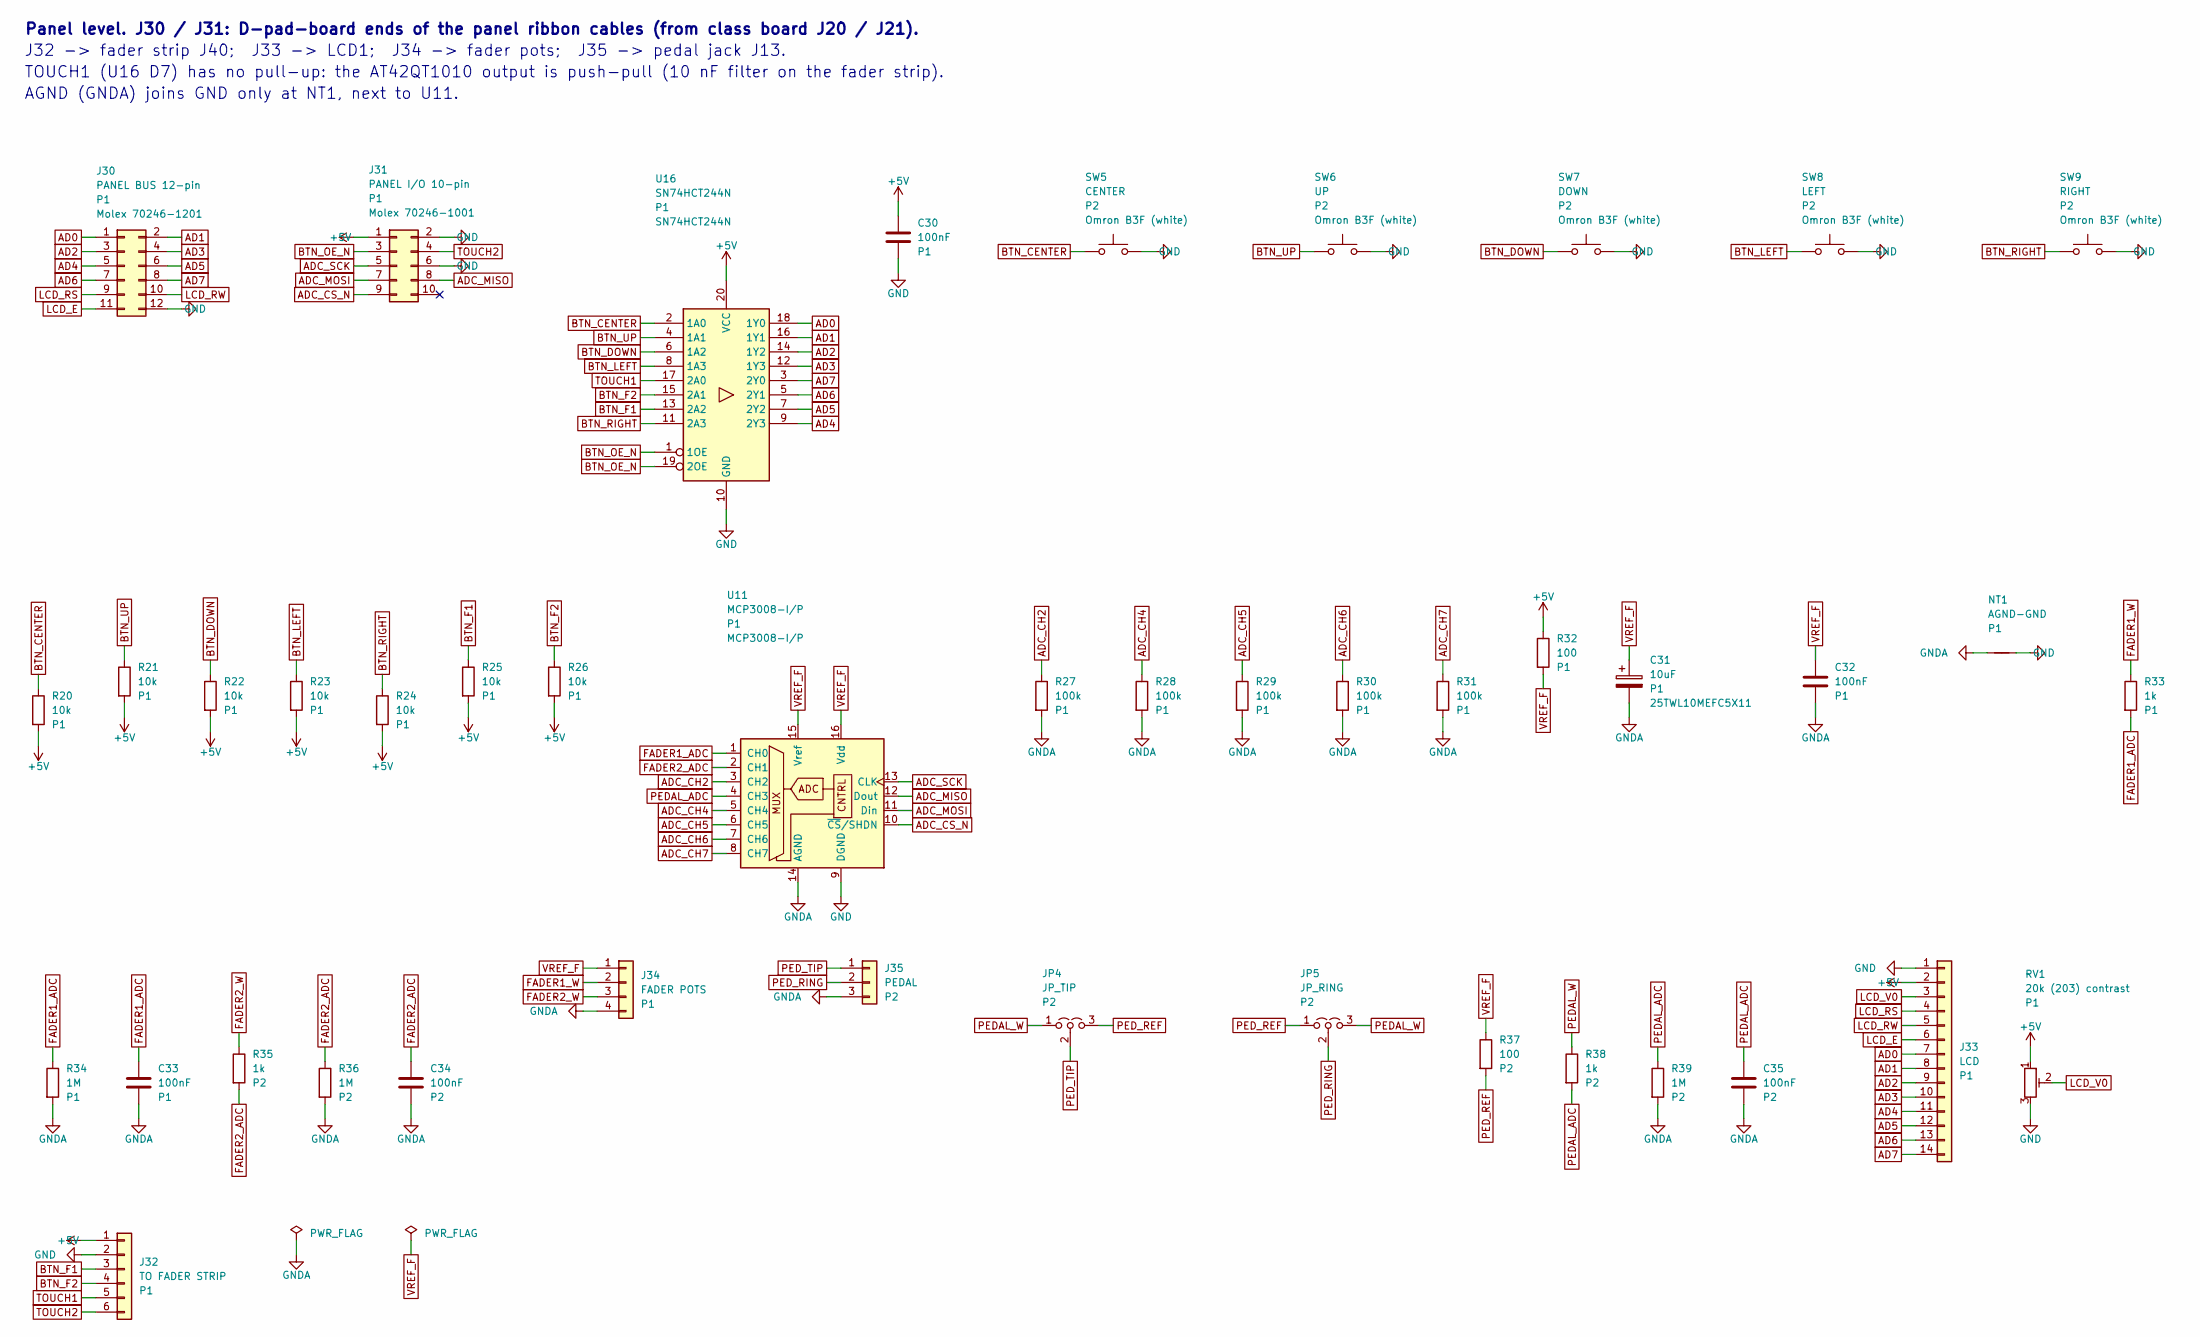
[picture p28: schematic dpad.kicad_sch]

Parts:
C30, C32, C33, C34, C35: 100nF
C31: 10uF; MPN 25TWL10MEFC5X11
J30: PANEL BUS 12-pin; MPN Molex 70246-1201
J31: PANEL I/O 10-pin; MPN Molex 70246-1001
J32: TO FADER STRIP
J33: LCD
J34: FADER POTS
J35: PEDAL
JP4: JP_TIP
JP5: JP_RING
NT1: AGND-GND
R20, R21, R22, R23, R24, R25, R26: 10k
R27, R28, R29, R30, R31: 100k
R32, R37: 100
R33, R35, R38: 1k
R34, R36, R39: 1M
RV1: 20k (203) contrast
SW5: CENTER; MPN Omron B3F (white)
SW6: UP; MPN Omron B3F (white)
SW7: DOWN; MPN Omron B3F (white)
SW8: LEFT; MPN Omron B3F (white)
SW9: RIGHT; MPN Omron B3F (white)
U11: MCP3008-I/P; MPN MCP3008-I/P
U16: SN74HCT244N; MPN SN74HCT244N

Connections:
+5V: C30.1, J31.1, J32.1, J33.2, R20.2, R21.2, R22.2, R23.2, R24.2, R25.2, R26.2, R32.1, RV1.1, U16.20 (VCC)
AD0: J30.1, J33.7, U16.18 (1Y0)
AD1: J30.2, J33.8, U16.16 (1Y1)
AD2: J30.3, J33.9, U16.14 (1Y2)
AD3: J30.4, J33.10, U16.12 (1Y3)
AD4: J30.5, J33.11, U16.9 (2Y3)
AD5: J30.6, J33.12, U16.7 (2Y2)
AD6: J30.7, J33.13, U16.5 (2Y1)
AD7: J30.8, J33.14, U16.3 (2Y0)
ADC_CH2: R27.1, U11.3 (CH2)
ADC_CH4: R28.1, U11.5 (CH4)
ADC_CH5: R29.1, U11.6 (CH5)
ADC_CH6: R30.1, U11.7 (CH6)
ADC_CH7: R31.1, U11.8 (CH7)
ADC_CS_N: J31.9, U11.10 (~CS/SHDN)
ADC_MISO: J31.8, U11.12 (Dout)
ADC_MOSI: J31.7, U11.11 (Din)
ADC_SCK: J31.5, U11.13 (CLK)
BTN_CENTER: R20.1, SW5.1, U16.2 (1A0)
BTN_DOWN: R22.1, SW7.1, U16.6 (1A2)
BTN_F1: J32.3, R25.1, U16.13 (2A2)
BTN_F2: J32.4, R26.1, U16.15 (2A1)
BTN_LEFT: R23.1, SW8.1, U16.8 (1A3)
BTN_OE_N: J31.3, U16.1 (1OE), U16.19 (2OE)
BTN_RIGHT: R24.1, SW9.1, U16.11 (2A3)
BTN_UP: R21.1, SW6.1, U16.4 (1A1)
FADER1_ADC: C33.1, R33.2, R34.1, U11.1 (CH0)
FADER1_W: J34.2, R33.1
FADER2_ADC: C34.1, R35.2, R36.1, U11.2 (CH1)
FADER2_W: J34.3, R35.1
GND: C30.2, J30.12, J31.2, J31.6, J32.2, J33.1, NT1.2, RV1.3, SW5.2, SW6.2, SW7.2, SW8.2, SW9.2, U11.9 (DGND), U16.10 (GND)
GNDA: C31.2, C32.2, C33.2, C34.2, C35.2, J34.4, J35.3, NT1.1, R27.2, R28.2, R29.2, R30.2, R31.2, R34.2, R36.2, R39.2, U11.14 (AGND)
LCD_E: J30.11, J33.6
LCD_RS: J30.9, J33.4
LCD_RW: J30.10, J33.5
LCD_V0: J33.3, RV1.2
PEDAL_ADC: C35.1, R38.2, R39.1, U11.4 (CH3)
PEDAL_W: JP4.1 (A), JP5.3 (B), R38.1
PED_REF: JP4.3 (B), JP5.1 (A), R37.2
PED_RING: J35.2, JP5.2 (C)
PED_TIP: J35.1, JP4.2 (C)
TOUCH1: J32.5, U16.17 (2A0)
TOUCH2: J31.4, J32.6
VREF_F: C31.1, C32.1, J34.1, R32.2, R37.1, U11.15 (Vref), U11.16 (Vdd)

Notes on the sheet:
Panel level. J30 / J31: D-pad-board ends of the panel ribbon cables (from class board J20 / J21).
J32 -> fader strip J40; J33 -> LCD1; J34 -> fader pots; J35 -> pedal jack J13.
TOUCH1 (U16 D7) has no pull-up: the AT42QT1010 output is push-pull (10 nF filter on the fader strip).
AGND (GNDA) joins GND only at NT1, next to U11.
