TravisNagle/ECEN5613_Final_Project/hardware/kicad/ESD_Final/fader_strip.kicad_sch

## KiCad design hardware/kicad/ESD_Final/fader_strip.kicad_sch (2026-10-25)

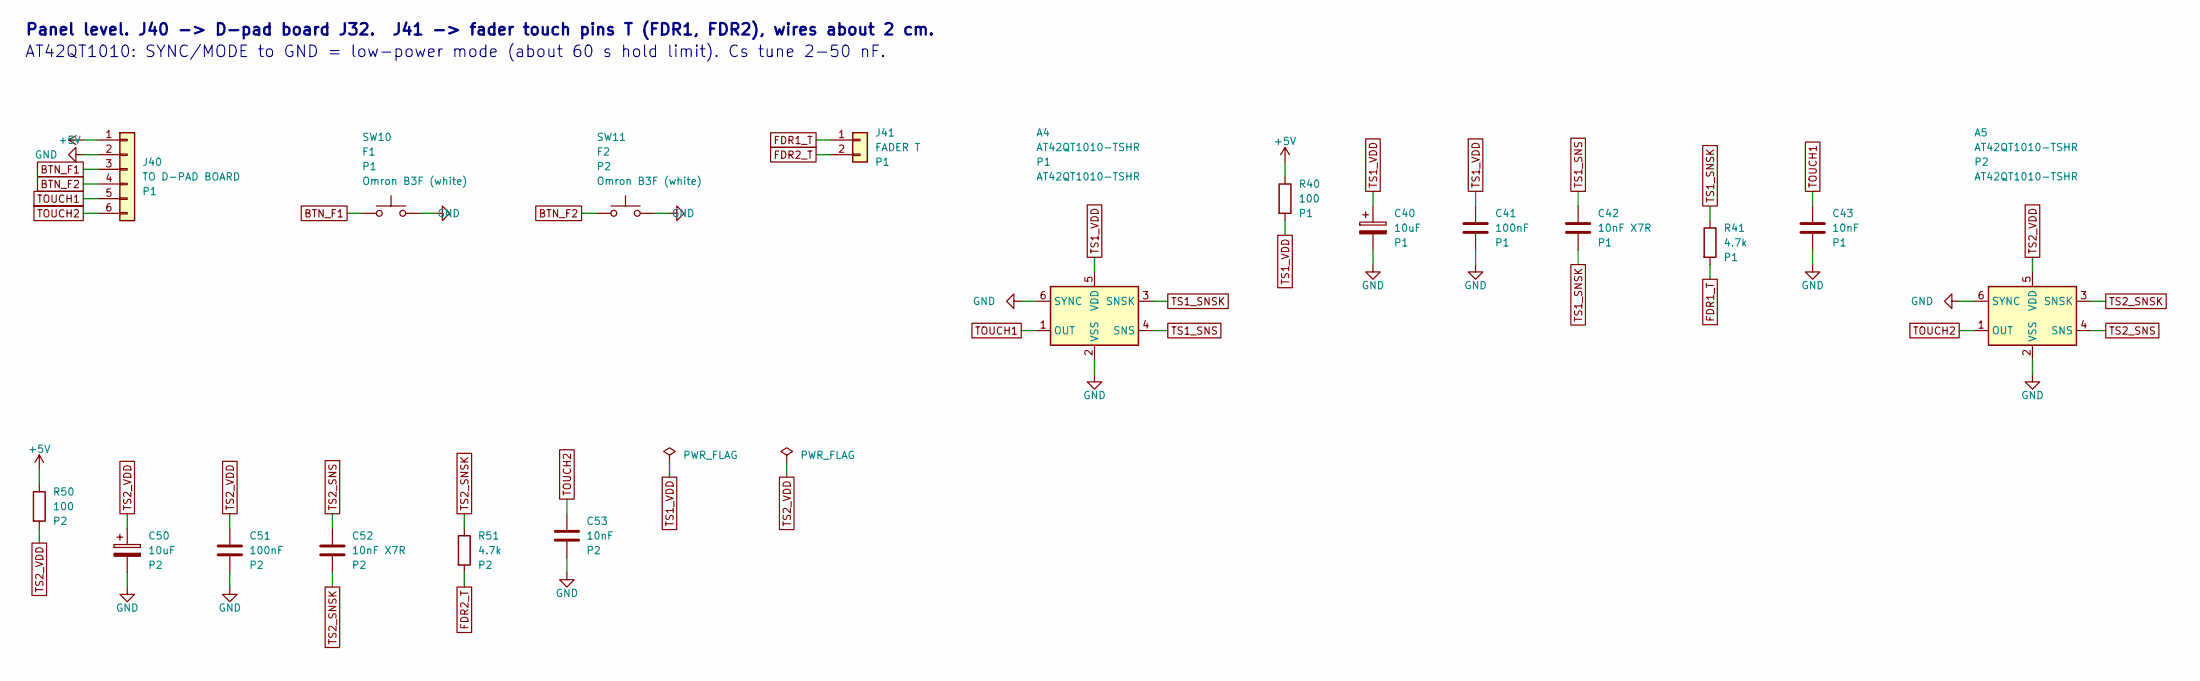
[picture p29: schematic fader_strip.kicad_sch]

Parts:
A4, A5: AT42QT1010-TSHR; MPN AT42QT1010-TSHR
C40, C50: 10uF
C41, C51: 100nF
C42, C52: 10nF X7R
C43, C53: 10nF
J40: TO D-PAD BOARD
J41: FADER T
R40, R50: 100
R41, R51: 4.7k
SW10: F1; MPN Omron B3F (white)
SW11: F2; MPN Omron B3F (white)

Connections:
+5V: J40.1, R40.1, R50.1
BTN_F1: J40.3, SW10.1
BTN_F2: J40.4, SW11.1
FDR1_T: J41.1, R41.2
FDR2_T: J41.2, R51.2
GND: A4.2 (VSS), A4.6 (SYNC), A5.2 (VSS), A5.6 (SYNC), C40.2, C41.2, C43.2, C50.2, C51.2, C53.2, J40.2, SW10.2, SW11.2
TOUCH1: A4.1 (OUT), C43.1, J40.5
TOUCH2: A5.1 (OUT), C53.1, J40.6
TS1_SNS: A4.4 (SNS), C42.1
TS1_SNSK: A4.3 (SNSK), C42.2, R41.1
TS1_VDD: A4.5 (VDD), C40.1, C41.1, R40.2
TS2_SNS: A5.4 (SNS), C52.1
TS2_SNSK: A5.3 (SNSK), C52.2, R51.1
TS2_VDD: A5.5 (VDD), C50.1, C51.1, R50.2

Notes on the sheet:
Panel level. J40 -> D-pad board J32. J41 -> fader touch pins T (FDR1, FDR2), wires about 2 cm.
AT42QT1010: SYNC/MODE to GND = low-power mode (about 60 s hold limit). Cs tune 2-50 nF.
