TravisNagle/ECEN5613_Final_Project/hardware/kicad/ESD_Final/panel.kicad_sch

## KiCad design hardware/kicad/ESD_Final/panel.kicad_sch (2026-10-25)

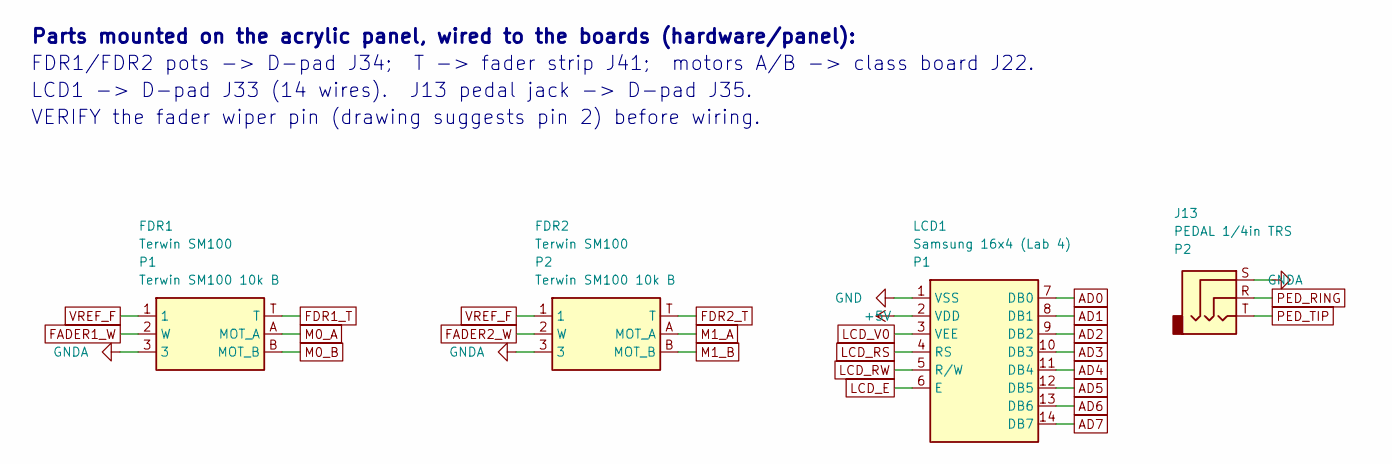
[picture p30: schematic panel.kicad_sch]

Parts:
FDR1, FDR2: Terwin SM100; MPN Terwin SM100 10k B
J13: PEDAL 1/4in TRS
LCD1: Samsung 16x4 (Lab 4)

Connections:
+5V: LCD1.2 (VDD)
AD0: LCD1.7 (DB0)
AD1: LCD1.8 (DB1)
AD2: LCD1.9 (DB2)
AD3: LCD1.10 (DB3)
AD4: LCD1.11 (DB4)
AD5: LCD1.12 (DB5)
AD6: LCD1.13 (DB6)
AD7: LCD1.14 (DB7)
FADER1_W: FDR1.2 (W)
FADER2_W: FDR2.2 (W)
FDR1_T: FDR1.T
FDR2_T: FDR2.T
GND: LCD1.1 (VSS)
GNDA: FDR1.3, FDR2.3, J13.S
LCD_E: LCD1.6 (E)
LCD_RS: LCD1.4 (RS)
LCD_RW: LCD1.5 (R/W)
LCD_V0: LCD1.3 (VEE)
M0_A: FDR1.A (MOT_A)
M0_B: FDR1.B (MOT_B)
M1_A: FDR2.A (MOT_A)
M1_B: FDR2.B (MOT_B)
PED_RING: J13.R
PED_TIP: J13.T
VREF_F: FDR1.1, FDR2.1

Notes on the sheet:
Parts mounted on the acrylic panel, wired to the boards (hardware/panel):
FDR1/FDR2 pots -> D-pad J34; T -> fader strip J41; motors A/B -> class board J22.
LCD1 -> D-pad J33 (14 wires). J13 pedal jack -> D-pad J35.
VERIFY the fader wiper pin (drawing suggests pin 2) before wiring.
