TravisNagle/ECEN5613_Final_Project/reference/class_board/kicad_schematic/ECEN5613_Dev_Board.kicad_sch

## KiCad design reference/class_board/kicad_schematic/ECEN5613_Dev_Board.kicad_sch (2026-10-20)

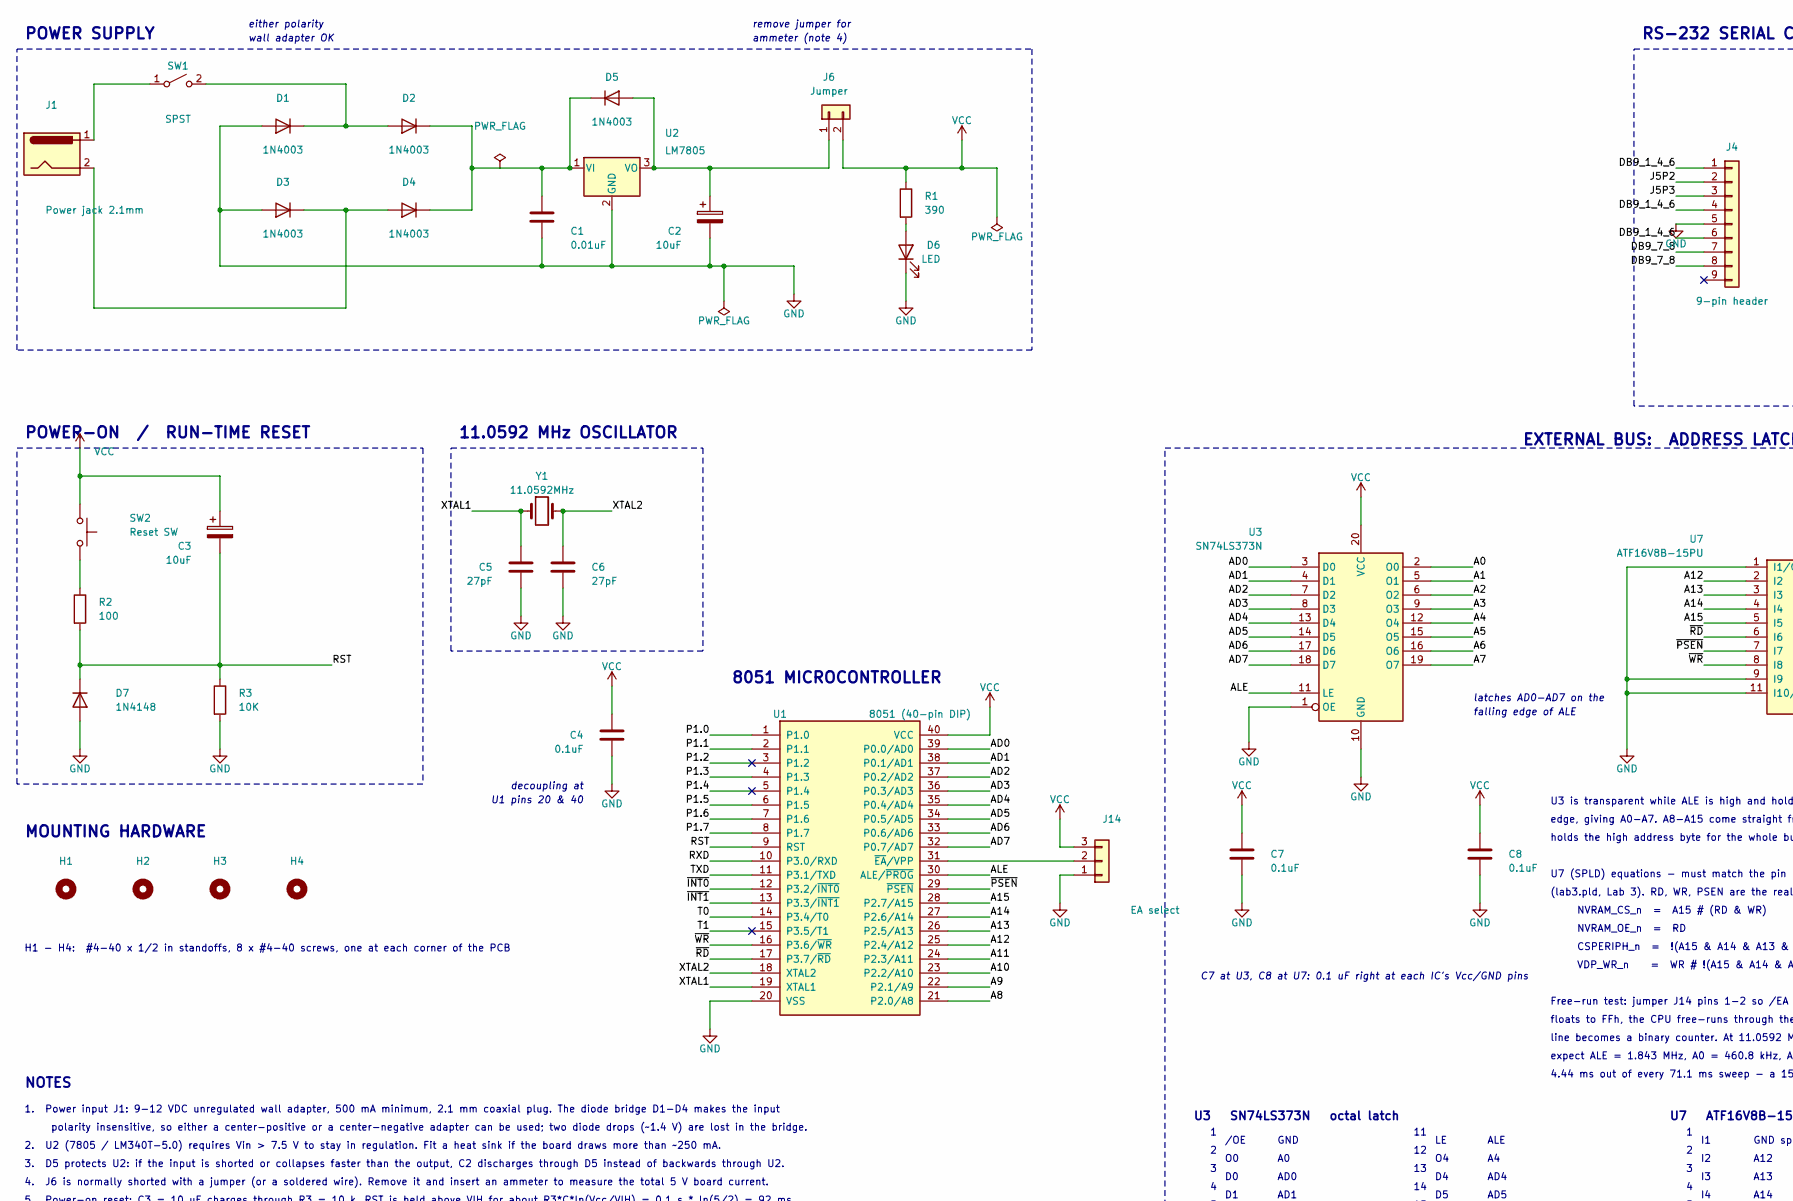
[picture p31: schematic ECEN5613_Dev_Board.kicad_sch, part in row 1, column 1]

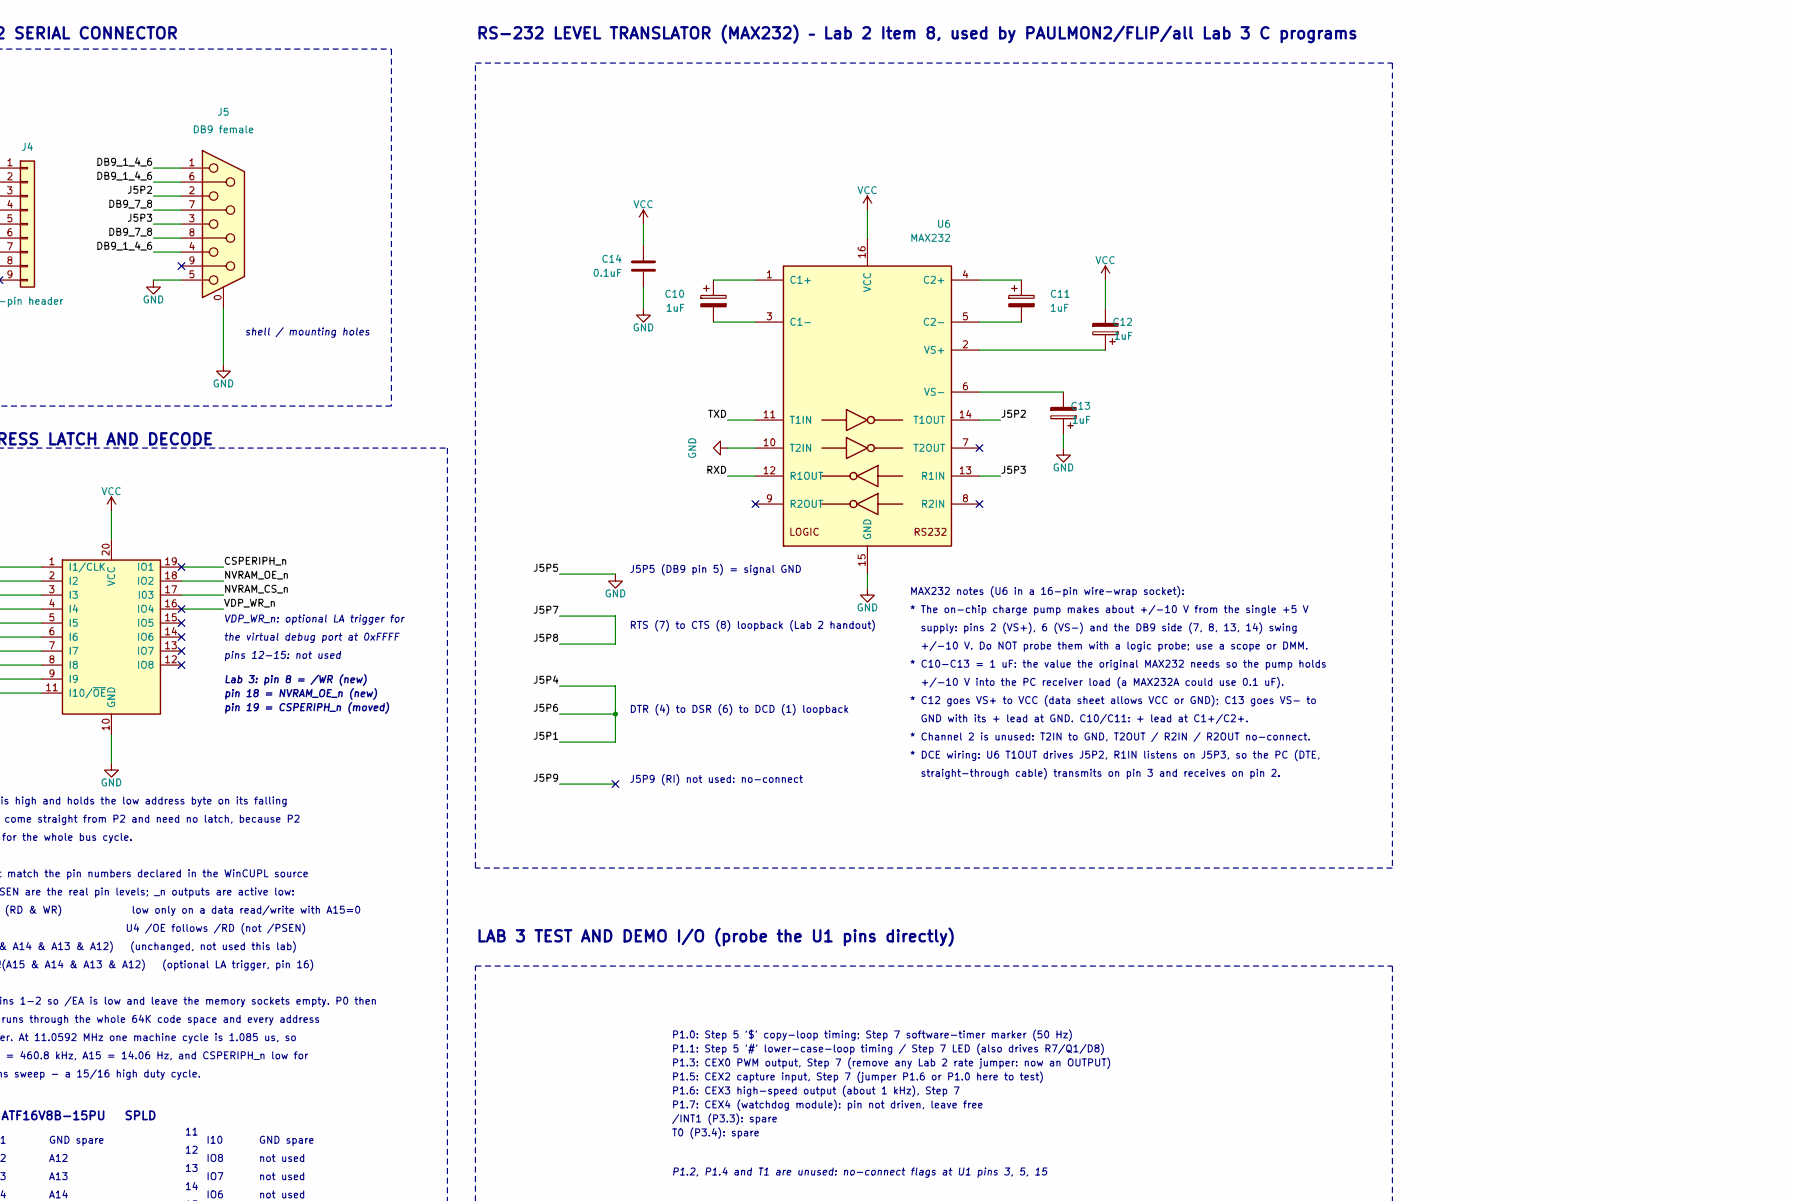
[picture p32: schematic ECEN5613_Dev_Board.kicad_sch, part in row 1, column 2]

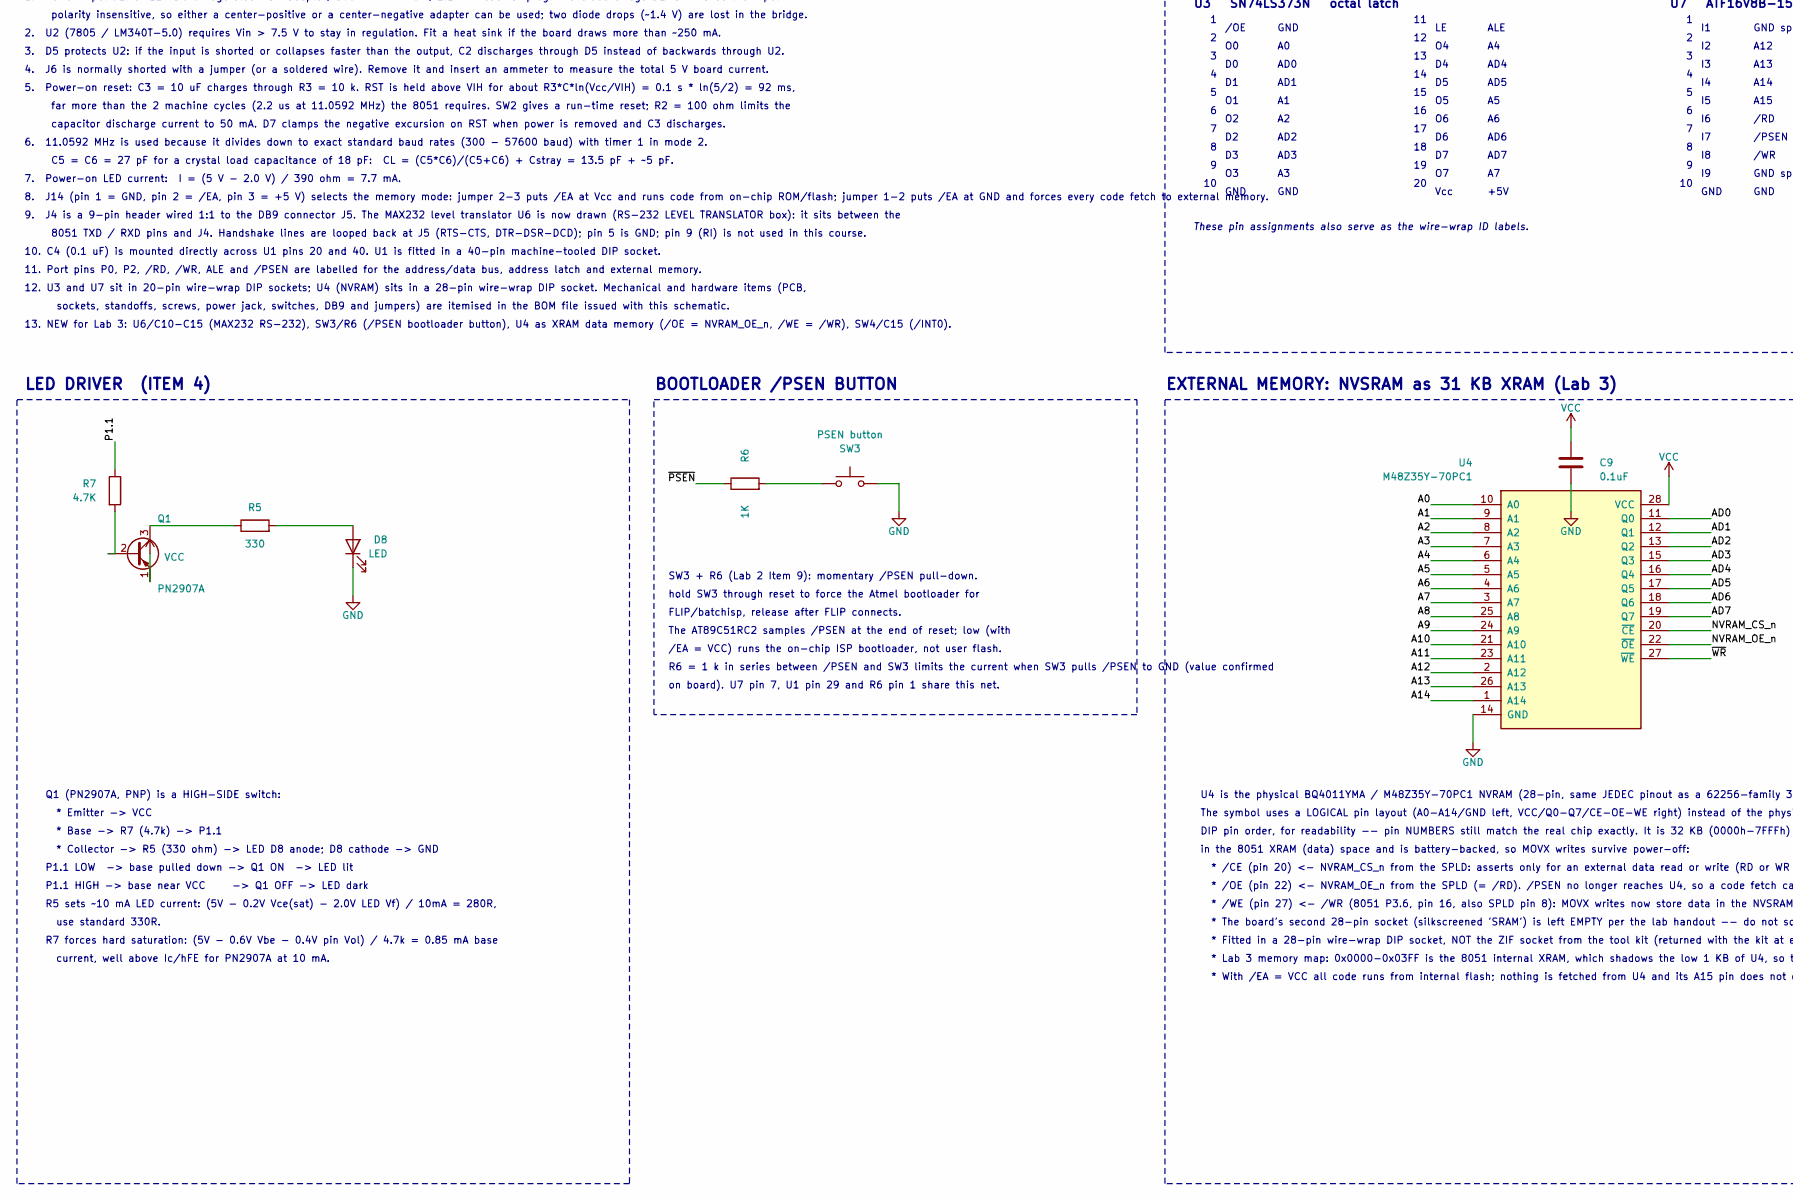
[picture p33: schematic ECEN5613_Dev_Board.kicad_sch, part in row 2, column 1]

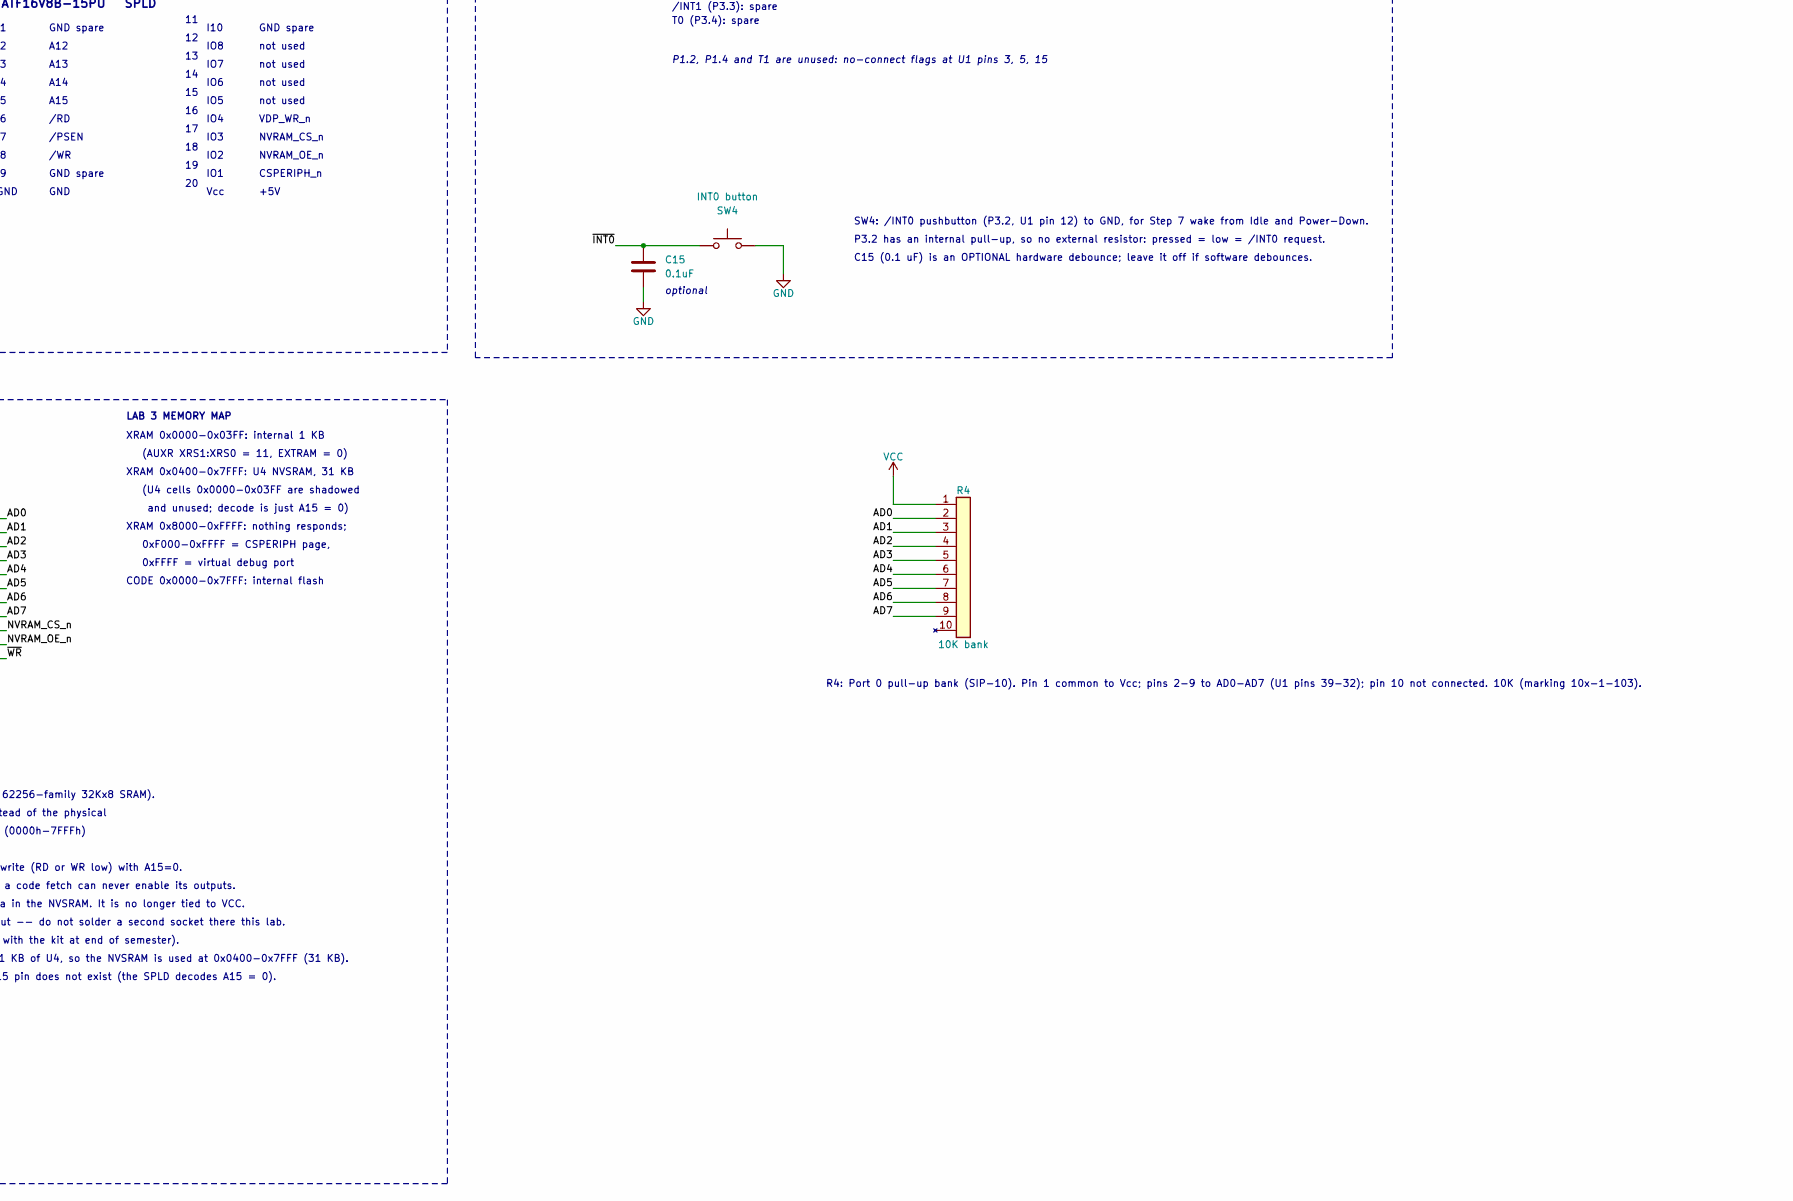
[picture p34: schematic ECEN5613_Dev_Board.kicad_sch, part in row 2, column 2]

Parts:
C1: 0.01uF; C_Disc_D5.0mm_W2.5mm_P5.00mm
C2, C3: 10uF; CP_Radial_D5.0mm_P2.50mm
C4, C7, C8, C9, C14, C15: 0.1uF; C_Disc_D5.0mm_W2.5mm_P5.00mm
C5, C6: 27pF; C_Disc_D5.0mm_W2.5mm_P5.00mm
C10, C11, C12, C13: 1uF; CP_Radial_D5.0mm_P2.50mm
D1, D2, D3, D4, D5: 1N4003; D_DO-41_SOD81_P10.16mm_Horizontal
D6, D8: LED; LED_D5.0mm
D7: 1N4148; D_DO-35_SOD27_P7.62mm_Horizontal
H1, H2, H3, H4: Standoff #4-40 x 1/2in; MountingHole_3.2mm_M3
J1: Power jack 2.1mm; BarrelJack_Horizontal
J4: 9-pin header; PinHeader_1x09_P2.54mm_Vertical
J5: DB9 female; DSUB-9_Female_Horizontal_P2.77x2.84mm_EdgePinOffset7.70mm_H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
J6: Jumper; PinHeader_1x02_P2.54mm_Vertical
J14: EA select; PinHeader_1x03_P2.54mm_Vertical
Q1: PN2907A; TO-92_Inline
R1: 390; R_Axial_DIN0207_L6.3mm_D2.5mm_P10.16mm_Horizontal
R2: 100; R_Axial_DIN0207_L6.3mm_D2.5mm_P10.16mm_Horizontal
R3: 10K; R_Axial_DIN0207_L6.3mm_D2.5mm_P10.16mm_Horizontal
R4: 10K bank; R_Array_SIP10
R5: 330; R_Axial_DIN0207_L6.3mm_D2.5mm_P10.16mm_Horizontal
R6: 1K; R_Axial_DIN0207_L6.3mm_D2.5mm_P10.16mm_Horizontal
R7: 4.7K; R_Axial_DIN0207_L6.3mm_D2.5mm_P10.16mm_Horizontal
SW1: SPST; SW_DIP_SPSTx01_Slide_9.78x4.72mm_W7.62mm_P2.54mm
SW2: Reset SW; SW_PUSH_6mm
SW3: PSEN button; SW_PUSH_6mm
SW4: INT0 button; SW_PUSH_6mm
U1: 8051 (40-pin DIP); DIP-40_W15.24mm_Socket
U2: LM7805; TO-220-3_Vertical
U3: SN74LS373N; DIP-20_W7.62mm_Socket
U4: M48Z35Y-70PC1; DIP-28_W15.24mm_Socket
U6: MAX232; DIP-16_W7.62mm_Socket
U7: ATF16V8B-15PU; DIP-20_W7.62mm_Socket
Y1: 11.0592MHz; Crystal_HC49-U_Vertical

Connections:
A0: U3.2 (O0), U4.10 (A0)
A1: U3.5 (O1), U4.9 (A1)
A2: U3.6 (O2), U4.8 (A2)
A3: U3.9 (O3), U4.7 (A3)
A4: U3.12 (O4), U4.6 (A4)
A5: U3.15 (O5), U4.5 (A5)
A6: U3.16 (O6), U4.4 (A6)
A7: U3.19 (O7), U4.3 (A7)
A8: U1.21 (P2.0/A8), U4.25 (A8)
A9: U1.22 (P2.1/A9), U4.24 (A9)
A10: U1.23 (P2.2/A10), U4.21 (A10)
A11: U1.24 (P2.3/A11), U4.23 (A11)
A12: U1.25 (P2.4/A12), U4.2 (A12), U7.2 (I2)
A13: U1.26 (P2.5/A13), U4.26 (A13), U7.3 (I3)
A14: U1.27 (P2.6/A14), U4.1 (A14), U7.4 (I4)
A15: U1.28 (P2.7/A15), U7.5 (I5)
AD0: R4.2 (R1), U1.39 (P0.0/AD0), U3.3 (D0), U4.11 (Q0)
AD1: R4.3 (R2), U1.38 (P0.1/AD1), U3.4 (D1), U4.12 (Q1)
AD2: R4.4 (R3), U1.37 (P0.2/AD2), U3.7 (D2), U4.13 (Q2)
AD3: R4.5 (R4), U1.36 (P0.3/AD3), U3.8 (D3), U4.15 (Q3)
AD4: R4.6 (R5), U1.35 (P0.4/AD4), U3.13 (D4), U4.16 (Q4)
AD5: R4.7 (R6), U1.34 (P0.5/AD5), U3.14 (D5), U4.17 (Q5)
AD6: R4.8 (R7), U1.33 (P0.6/AD6), U3.17 (D6), U4.18 (Q6)
AD7: R4.9 (R8), U1.32 (P0.7/AD7), U3.18 (D7), U4.19 (Q7)
ALE: U1.30 (ALE/~PROG), U3.11 (LE)
CSPERIPH_n: U7.19 (IO1)
DB9_1_4_6: J4.1, J4.4, J4.6, J5.1, J5.4, J5.6
DB9_7_8: J4.7, J4.8, J5.7, J5.8
GND: C1.2, C2.2, C4.2, C5.2, C6.2, C7.2, C8.2, C9.2, C13.1, C14.2, C15.2, D1.2 (A), D3.2 (A), D6.1 (K), D7.2 (A), D8.1 (K), J4.5, J5.0 (PAD), J5.5, J14.1, R3.2, SW3.2, SW4.2, U1.20 (VSS), U2.2 (GND), U3.1 (OE), U3.10 (GND), U4.14 (GND), U6.10 (T2IN), U6.15 (GND), U7.1 (I1/CLK), U7.9 (I9), U7.10 (GND), U7.11 (I10/~OE)
J5P2: J4.2, J5.2, U6.14 (T1OUT)
J5P3: J4.3, J5.3, U6.13 (R1IN)
NVRAM_CS_n: U4.20 (~CE), U7.17 (I03)
NVRAM_OE_n: U4.22 (~OE), U7.18 (IO2)
unnamed: C1.1, D2.1 (K), D4.1 (K), D5.1 (K), U2.1 (VI)
unnamed: C2.1, D5.2 (A), J6.1, U2.3 (VO)
unnamed: C10.1, U6.1 (C1+)
unnamed: C10.2, U6.3 (C1-)
unnamed: C11.1, U6.4 (C2+)
unnamed: C11.2, U6.5 (C2-)
unnamed: C12.1, U6.2 (VS+)
unnamed: C13.2, U6.6 (VS-)
unnamed: D1.1 (K), D2.2 (A), SW1.2 (B)
unnamed: D3.1 (K), D4.2 (A), J1.2
unnamed: D6.2 (A), R1.2
unnamed: D8.2 (A), R5.2
unnamed: J1.1, SW1.1 (A)
unnamed: J14.2, U1.31 (~EA/VPP)
unnamed: Q1.2 (B), R7.2
unnamed: Q1.3 (C), R5.1
unnamed: R2.1, SW2.2
unnamed: R6.2, SW3.1
P1.0: U1.1 (P1.0)
P1.1: R7.1, U1.2 (P1.1)
P1.2: U1.3 (P1.2)
P1.3: U1.4 (P1.3)
P1.4: U1.5 (P1.4)
P1.5: U1.6 (P1.5)
P1.6: U1.7 (P1.6)
P1.7: U1.8 (P1.7)
RST: C3.2, D7.1 (K), R2.2, R3.1, U1.9 (RST)
RXD: U1.10 (P3.0/RXD), U6.12 (R1OUT)
T0: U1.14 (P3.4/T0)
T1: U1.15 (P3.5/T1)
TXD: U1.11 (P3.1/TXD), U6.11 (T1IN)
VCC: C3.1, C4.1, C7.1, C8.1, C9.1, C12.2, C14.1, J6.2, J14.3, Q1.1 (E), R1.1, R4.1 (COM), SW2.1, U1.40 (VCC), U3.20 (VCC), U4.28 (VCC), U6.16 (VCC), U7.20 (VCC)
VDP_WR_n: U7.16 (IO4)
XTAL1: C5.1, U1.19 (XTAL1), Y1.1
XTAL2: C6.1, U1.18 (XTAL2), Y1.2
~INT0: C15.1, SW4.1, U1.12 (P3.2/~INT0)
~INT1: U1.13 (P3.3/~INT1)
~PSEN: R6.1, U1.29 (~PSEN), U7.7 (I7)
~RD: U1.17 (P3.7/~RD), U7.6 (I6)
~WR: U1.16 (P3.6/~WR), U4.27 (~WE), U7.8 (I8)

Notes on the sheet:
/OE
MAX232 notes (U6 in a 16-pin wire-wrap socket):
/RD
P1.1 LOW -> base pulled down -> Q1 ON -> LED lit
CSPERIPH_n
(lab3.pld, Lab 3). RD, WR, PSEN are the real pin levels; _n outputs are active low:
SW4: /INT0 pushbutton (P3.2, U1 pin 12) to GND, for Step 7 wake from Idle and Power-Down.
P1.0: Step 5 '$' copy-loop timing; Step 7 software-timer marker (50 Hz)
optional
GND
+5V
6. 11.0592 MHz is used because it divides down to exact standard baud rates (300 - 57600 baud) with timer 1 in mode 2.
NVRAM_CS_n
edge, giving A0-A7. A8-A15 come straight from P2 and need no latch, because P2
P1.7: CEX4 (watchdog module): pin not driven, leave free
straight-through cable) transmits on pin 3 and receives on pin 2.
LAB 3 TEST AND DEMO I/O (probe the U1 pins directly)
P3.2 has an internal pull-up, so no external resistor: pressed = low = /INT0 request.
P1.2, P1.4 and T1 are unused: no-connect flags at U1 pins 3, 5, 15
either polarity
expect ALE = 1.843 MHz, A0 = 460.8 kHz, A15 = 14.06 Hz, and CSPERIPH_n low for
the virtual debug port at 0xFFFF
XRAM 0x0000-0x03FF: internal 1 KB
capacitor discharge current to 50 mA. D7 clamps the negative excursion on RST when power is removed and C3 discharges.
* Channel 2 is unused: T2IN to GND, T2OUT / R2IN / R2OUT no-connect.
R6 = 1 k in series between /PSEN and SW3 limits the current when SW3 pulls /PSEN to GND (value confirmed
supply: pins 2 (VS+), 6 (VS-) and the DB9 side (7, 8, 13, 14) swing
U1 pins 20 & 40
P1.6: CEX3 high-speed output (about 1 kHz), Step 7
pins 12-15: not used
U7 (SPLD) equations - must match the pin numbers declared in the WinCUPL source
far more than the 2 machine cycles (2.2 us at 11.0592 MHz) the 8051 requires. SW2 gives a run-time reset; R2 = 100 ohm limits the
* Base -> R7 (4.7k) -> P1.1
hold SW3 through reset to force the Atmel bootloader for
pin 18 = NVRAM_OE_n (new)
in the 8051 XRAM (data) space and is battery-backed, so MOVX writes survive power-off:
Q1 (PN2907A, PNP) is a HIGH-SIDE switch:
DTR (4) to DSR (6) to DCD (1) loopback
VDP_WR_n
remove jumper for
VDP_WR_n: optional LA trigger for
VDP_WR_n = WR # !(A15 & A14 & A13 & A12) (optional LA trigger, pin 16)
AD0
2. U2 (7805 / LM340T-5.0) requires Vin > 7.5 V to stay in regulation. Fit a heat sink if the board draws more than ~250 mA.
C5 = C6 = 27 pF for a crystal load capacitance of 18 pF: CL = (C5*C6)/(C5+C6) + Cstray = 13.5 pF + ~5 pF.
MOUNTING HARDWARE
R5 sets ~10 mA LED current: (5V - 0.2V Vce(sat) - 2.0V LED Vf) / 10mA = 280R,
XRAM 0x0400-0x7FFF: U4 NVSRAM, 31 KB
ALE
* Fitted in a 28-pin wire-wrap DIP socket, NOT the ZIF socket from the tool kit (returned with the kit at end of semester).
U7 ATF16V8B-15PU SPLD
GND with its + lead at GND. C10/C11: + lead at C1+/C2+.
IO1
* Emitter -> VCC
NVRAM_CS_n = A15 # (RD & WR) low only on a data read/write with A15=0
P1.1: Step 5 '#' lower-case-loop timing / Step 7 LED (also drives R7/Q1/D8)
(U4 cells 0x0000-0x03FF are shadowed
These pin assignments also serve as the wire-wrap ID labels.
AD7
J5P9 (RI) not used: no-connect
U3 is transparent while ALE is high and holds the low address byte on its falling
IO7
LAB 3 MEMORY MAP
13. NEW for Lab 3: U6/C10-C15 (MAX232 RS-232), SW3/R6 (/PSEN bootloader button), U4 as XRAM data memory (/OE = NVRAM_OE_n, /WE = /WR), SW4/C15 (/INT0).
* DCE wiring: U6 T1OUT drives J5P2, R1IN listens on J5P3, so the PC (DTE,
The symbol uses a LOGICAL pin layout (A0-A14/GND left, VCC/Q0-Q7/CE-OE-WE right) instead of the physical
IO5
8051 TXD / RXD pins and J4. Handshake lines are looped back at J5 (RTS-CTS, DTR-DSR-DCD); pin 5 is GND; pin 9 (RI) is not used in this course.
DIP pin order, for readability -- pin NUMBERS still match the real chip exactly. It is 32 KB (0000h-7FFFh)
C15 (0.1 uF) is an OPTIONAL hardware debounce; leave it off if software debounces.
11.0592 MHz OSCILLATOR
8. J14 (pin 1 = GND, pin 2 = /EA, pin 3 = +5 V) selects the memory mode: jumper 2-3 puts /EA at Vcc and runs code from on-chip ROM/flash; jumper 1-2 puts /EA at GND and forces every code fetch to external memory.
/PSEN
11. Port pins P0, P2, /RD, /WR, ALE and /PSEN are labelled for the address/data bus, address latch and external memory.
LED DRIVER (ITEM 4)
7. Power-on LED current: I = (5 V - 2.0 V) / 390 ohm = 7.7 mA.
AD4
IO4
C7 at U3, C8 at U7: 0.1 uF right at each IC's Vcc/GND pins
/EA = VCC) runs the on-chip ISP bootloader, not user flash.
line becomes a binary counter. At 11.0592 MHz one machine cycle is 1.085 us, so
NVRAM_OE_n = RD U4 /OE follows /RD (not /PSEN)
/INT1 (P3.3): spare
EXTERNAL MEMORY: NVSRAM as 31 KB XRAM (Lab 3)
A12
A13
A14
AD1
Lab 3: pin 8 = /WR (new)
* C10-C13 = 1 uF: the value the original MAX232 needs so the pump holds
10. C4 (0.1 uF) is mounted directly across U1 pins 20 and 40. U1 is fitted in a 40-pin machine-tooled DIP socket.
RS-232 SERIAL CONNECTOR
Vcc
IO3
1. Power input J1: 9-12 VDC unregulated wall adapter, 500 mA minimum, 2.1 mm coaxial plug. The diode bridge D1-D4 makes the input
BOOTLOADER /PSEN BUTTON
wall adapter OK
/WR
XRAM 0x8000-0xFFFF: nothing responds;
9. J4 is a 9-pin header wired 1:1 to the DB9 connector J5. The MAX232 level translator U6 is now drawn (RS-232 LEVEL TRANSLATOR box): it sits between the
FLIP/batchisp, release after FLIP connects.
R4: Port 0 pull-up bank (SIP-10). Pin 1 common to Vcc; pins 2-9 to AD0-AD7 (U1 pins 39-32); pin 10 not connected. 10K (marking 10x-1-103).
* /WE (pin 27) <- /WR (8051 P3.6, pin 16, also SPLD pin 8): MOVX writes now store data in the NVSRAM. It is no longer tied to VCC.
R7 forces hard saturation: (5V - 0.6V Vbe - 0.4V pin Vol) / 4.7k = 0.85 mA base
IO6
IO2
polarity insensitive, so either a center-positive or a center-negative adapter can be used; two diode drops (~1.4 V) are lost in the bridge.
* Collector -> R5 (330 ohm) -> LED D8 anode; D8 cathode -> GND
AD2
0xFFFF = virtual debug port
EXTERNAL BUS: ADDRESS LATCH AND DECODE
J5P5 (DB9 pin 5) = signal GND
4.44 ms out of every 71.1 ms sweep - a 15/16 high duty cycle.
* /CE (pin 20) <- NVRAM_CS_n from the SPLD: asserts only for an external data read or write (RD or WR low) with A15=0.
(AUXR XRS1:XRS0 = 11, EXTRAM = 0)
CSPERIPH_n = !(A15 & A14 & A13 & A12) (unchanged, not used this lab)
5. Power-on reset: C3 = 10 uF charges through R3 = 10 k. RST is held above VIH for about R3*C*ln(Vcc/VIH) = 0.1 s * ln(5/2) = 92 ms,
sockets, standoffs, screws, power jack, switches, DB9 and jumpers) are itemised in the BOM file issued with this schematic.
* The on-chip charge pump makes about +/-10 V from the single +5 V
AD3
ammeter (note 4)
shell / mounting holes
3. D5 protects U2: if the input is shorted or collapses faster than the output, C2 discharges through D5 instead of backwards through U2.
T0 (P3.4): spare
GND spare
AD6
U4 is the physical BQ4011YMA / M48Z35Y-70PC1 NVRAM (28-pin, same JEDEC pinout as a 62256-family 32Kx8 SRAM).
NVRAM_OE_n
P1.1 HIGH -> base near VCC -> Q1 OFF -> LED dark
* /OE (pin 22) <- NVRAM_OE_n from the SPLD (= /RD). /PSEN no longer reaches U4, so a code fetch can never enable its outputs.
not used
The AT89C51RC2 samples /PSEN at the end of reset; low (with
+/-10 V into the PC receiver load (a MAX232A could use 0.1 uF).
current, well above Ic/hFE for PN2907A at 10 mA.
A15
RTS (7) to CTS (8) loopback (Lab 2 handout)
* C12 goes VS+ to VCC (data sheet allows VCC or GND); C13 goes VS- to
+/-10 V. Do NOT probe them with a logic probe; use a scope or DMM.
latches AD0-AD7 on the
RS-232 LEVEL TRANSLATOR (MAX232) – Lab 2 Item 8, used by PAULMON2/FLIP/all Lab 3 C programs
IO8
AD5
CODE 0x0000-0x7FFF: internal flash
4. J6 is normally shorted with a jumper (or a soldered wire). Remove it and insert an ammeter to measure the total 5 V board current.
decoupling at
H1 - H4: #4-40 x 1/2 in standoffs, 8 x #4-40 screws, one at each corner of the PCB
* The board's second 28-pin socket (silkscreened 'SRAM') is left EMPTY per the lab handout -- do not solder a second socket there this lab.
holds the high address byte for the whole bus cycle.
floats to FFh, the CPU free-runs through the whole 64K code space and every address
0xF000-0xFFFF = CSPERIPH page,
POWER SUPPLY
U3 SN74LS373N octal latch
* With /EA = VCC all code runs from internal flash; nothing is fetched from U4 and its A15 pin does not exist (the SPLD decodes A15 = 0).
* Lab 3 memory map: 0x0000-0x03FF is the 8051 internal XRAM, which shadows the low 1 KB of U4, so the NVSRAM is used at 0x0400-0x7FFF (31 KB).
P1.5: CEX2 capture input, Step 7 (jumper P1.6 or P1.0 here to test)
8051 MICROCONTROLLER
falling edge of ALE
on board). U7 pin 7, U1 pin 29 and R6 pin 1 share this net.
NOTES
pin 19 = CSPERIPH_n (moved)
Free-run test: jumper J14 pins 1-2 so /EA is low and leave the memory sockets empty. P0 then
SW3 + R6 (Lab 2 Item 9): momentary /PSEN pull-down.
P1.3: CEX0 PWM output, Step 7 (remove any Lab 2 rate jumper: now an OUTPUT)
I10
POWER-ON / RUN-TIME RESET
and unused; decode is just A15 = 0)
use standard 330R.
12. U3 and U7 sit in 20-pin wire-wrap DIP sockets; U4 (NVRAM) sits in a 28-pin wire-wrap DIP socket. Mechanical and hardware items (PCB,
