TravisNagle/ECEN5613_Final_Project/(commit log)

2026-10-20 Add project docs, class-board reference and ESD_Main design inputs
    - Hardware_Map Rev 12 (spec and KiCad hand-off brief) and the Rev 10 review
    - README, AGENTS.md, .gitignore for KiCad/SDCC/router output
    - Course spec, PDR deck and PDR-era design doc
    - reference/: read-only copies of the class dev board (KiCad project,
    symbol library, BOM, Lab 3 SPLD, memory map) and the SM100 fader datasheet
    - kicad/lib: ESD symbols/footprints (SM100 fader, SDS-50J DIN-5, Samsung
    16x4 LCD 1x14) and a copy of the class ECEN5613 symbol library
    - kicad/tools: ESD_Main parts/netlist data and placement plan
    The ESD_Main schematic/PCB and generator scripts are still being routed
    and are not included yet.
    Co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
    [ECEN5613_Dev_Board.kicad_sch, ECEN5613_Dev_Board_BOM.csv]
2026-10-20 Add ESD_Main KiCad 10 board: schematic, routed PCB, fab outputs
    First complete draft of the main board, generated from
    kicad/tools/esd_main_design.py and esd_main_placement.py (Hardware_Map Rev 12).
    NOT reviewed in KiCad by a person yet; do not order. See
    kicad/ESD_Main/README.md for status and the pre-order checklist.
    - Schematic: 7 hierarchical sheets, ERC 0 violations, netlist matches the
    design data (178 parts, 555 pins); PDF included.
    - PCB: 200 x 150 mm, 2 layers, faders on top with motor notches in the back
    edge, LCD over the bus logic; 100 % routed with Freerouting 1.9.0.
    DRC: 0 errors, 0 unconnected, 0 parity issues; 14 silk_edge_clearance
    warnings on edge connectors (by de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
    [ESD_Main-B_Cu.gbl, ESD_Main-B_Mask.gbs, ESD_Main-B_Paste.gbp, ESD_Main-B_Silkscreen.gbo, ESD_Main-Edge_Cuts.gm1, ESD_Main-F_Cu.gtl, ESD_Main-F_Mask.gts, ESD_Main-F_Paste.gtp]
2026-10-24 Add perf-board order notes, Digi-Key order and cart, parts kit list; RJ45 bus pointer in Hardware_Map
    [digikey_cart_2026-10-24.csv, digikey_phase1_2_order.csv]
2026-10-24 Use RHEF300 (3 A hold) PTC for the motor rail
    [digikey_phase1_2_order.csv]
2026-10-24 Remove the ESD_Main custom PCB draft
    The master board is now the existing class board and the daughter
    boards are hand-built perf boards, so the KiCad 10 PCB, fab outputs,
    generator scripts and ESD footprint/symbol libraries are dropped.
    The last state is kept under tag pcb-draft-archive.
    [ESD_Main-B_Cu.gbl, ESD_Main-B_Mask.gbs, ESD_Main-B_Paste.gbp, ESD_Main-B_Silkscreen.gbo, ESD_Main-Edge_Cuts.gm1, ESD_Main-F_Cu.gtl, ESD_Main-F_Mask.gts, ESD_Main-F_Paste.gtp]
2026-10-24 Move course docs into docs/, archive the Rev 10 review
    PDR deck, course spec and design doc move from the root into docs/.
    Hardware_Map_Review (a review of the dropped PCB design) moves to
    docs/archive/ with a banner and fixed links. Empty docs/ and hardware/
    placeholders removed now that both folders have content.
2026-10-24 Hardware_Map Rev 13: class board master, perf boards, two faders
    Rewrite the spec for the 2026-10-24 scope: the class dev board is the
    master, all new circuits are hand-built, and two Terwin SM100 faders run
    from one TB6612FNG. Folds in the 10/24 perf-board decisions (KB2040
    USB-MIDI with a BSS138 level shifter, 74AHC157 PWM buffer, 2N2222 reset
    inverter, kit 24C16, RJ45 daughter bus) and updates the pin map, SPLD
    outputs and Appendix A. New OPEN items: motor supply vs the 9 V class
    input, build location, pot-board ADC, KB2040 link baud, hardware SPI,
    mechanical layout.
    Perfboard_Order_Notes becomes the parts/order record (PTC and cart
    mismatches listed). README describes the current design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
2026-10-24 Add laser-cut acrylic top panel generator and SVGs
    hardware/panel/gen_panel.py writes the cut file, an annotated preview
    and a to-scale side view of one button. The 6 x 8 in sheet sits on the
    five #6-32 main standoffs and holds two Terwin SM100 faders (motor ends
    at the top edge, 1.05 in apart), the 16x4 LCD (3 3/8 x 1 11/16 in
    window, M2.5 holes) and seven buttons. Buttons are flat acrylic T
    plungers nested in the LCD window scrap, trapped by perf boards on
    25 mm standoffs: D-pad on the 7 x 9 cm board (M3), fader buttons on the
    2 x 8 cm strip (M2). Assumes 1/8 in acrylic and B3F-1000 switches.
2026-10-24 Hardware_Map Rev 13.1: AT42QT1010 touch sensor per fader
    The SM100 T pin connects to the knob (< 10 ohm measured), so each fader
    gets a capacitive touch sensor with T as the electrode. TOUCH1 takes the
    spare '244 input (D7 at 0xF800), TOUCH2 takes P1.5, which uses the last
    spare port pin and closes OPEN #5 (hardware SPI). Adds Appendix A.15,
    updates build stages, README and the to-source list.
2026-10-24 Point to commit 735803c for the old PCB draft instead of a tag
2026-10-25 Panel: per-board standoffs, measured switch and hole sizes, D-pad moves
    - Switch height 4.0 mm (measured white Omron B3F).
    - Standoff length per board: D-pad 0.4 in, fader strip 0.8 in, so two
    plunger lengths (12.0 mm and 22.2 mm), both nested in the LCD scrap.
    - Measured 7 x 9 cm board hole insets (0.1 in x 0.15 in).
    - D-pad switches 0.5 in south so the legs clear a chip on the class
    board; D-pad board holes 0.05 in right to line the grid up with the
    plungers.
    - Side view split into plunger_detail_dpad.svg and _fader.svg.
2026-10-25 Panel: fader strip standoffs 0.6 in, strip holes confirmed
    Fader-button plungers shorten to 17.1 mm (8.9 mm leg).
2026-10-25 Hardware_Map Rev 13.2-13.3, panel cables and order updates
    - Rev 13.2: two-level build (section 3.13). Panel: D-pad board with the
    '244 and MCP3008, fader strip with F1/F2 and the touch sensors.
    Bottom: class board and the rest. J20 (2x6 bus), J21 (2x5 I/O),
    J22 (motor), J23 (panel jumper). Closes OPEN #2.
    - Rev 13.3: touch sensors are bare AT42QT1010-TSHR chips on adapters
    (the SparkFun breakout has its own pad). Datasheet pinout and
    circuit: SYNC/MODE to GND for the ~60 s hold limit, no pull-up on
    TOUCH1, 10 nF HeartBeat filter, RC-filtered VDD.
    - Order: touch chips, Molex shrouded headers, home-made ribbon cables
    (Adam Tech FCS-12-SG, On Shore 101-106, 3M 3365/12), Rubycon 1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
    [digikey_phase1_2_order.csv]
2026-10-25 Hardware_Map Rev 13.4: one 9 V adapter powers logic and motors
    Closes OPEN #1. A 9 V >= 2 A adapter replaces the course's 500 mA one.
    VM is tapped at the class board's bridge output (before SW1) through
    JP_VM, PTC, TVS and 470 uF, with the TB6612 ground on the bridge
    negative output as the star point. The motor sees about 7.1 V, inside
    its 10 V rating, so no PWM cap; a 12 V adapter is a drop-in upgrade.
    README setup and order notes updated.
2026-10-25 Record Digi-Key order 102466363 and parts on hand
    - Add Digi-Key's export of the placed order (13 lines, $30.37 before
    shipping) for the costed BOM; rewrite the re-upload list to match it
    with the real Digi-Key part numbers; drop the stale unordered cart.
    - Order notes: ordered status, 2 ft ribbon, 1x40 header dropped.
    - Both faders and four 8-position DIP switch blocks on hand.
    - OPEN #3 (pot inputs) deferred, with the no-new-parts options listed.
    - LCD contrast trimmer: 10-20 k (20 k on hand).
    [digikey_cart_2026-10-24.csv, digikey_order_102466363.csv, digikey_phase1_2_order.csv]
2026-10-25 Add KiCad 10 schematic (one sheet per board) and generators
    hardware/kicad/ESD_Final: root sheet with the boards and inter-board
    cables, three class-board sheets (full class circuit from the reference
    netlist plus the bottom-level additions), D-pad board, fader button
    board, Panel Mounted (faders, LCD, pedal jack) and the Phase 3 button
    daughter board. Includes the 12-pin and 10-pin panel connectors on both
    ends and every other inter-board header. ERC 0 violations; netlist
    matches design.py (645 pins). PDF exported.
    Generated by hardware/kicad/tools (design.py, gen_symbols.py,
    gen_schematic.py, check_netlist.py), adapted from the Rev 12 generator.
    lib/ has a KiCad 10 copy of the class libra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
    [ESD_Final.kicad_sch, btn_daughter.kicad_sch, class_io.kicad_sch, class_mcu.kicad_sch, class_power.kicad_sch, dpad.kicad_sch, fader_strip.kicad_sch, panel.kicad_sch]
