TravisNagle/ECEN5613_Final_Project/(notices)

Notices in the files:
reference/class_board/kicad_schematic/ECEN5613_Dev_Board.kicad_sch:
Reference: ECEN 5613 PCB partial schematic (c) 2005 Linden H. McClure, Ph.D.
